formulaslug/fs-3-schematics/BMS/BMS.step

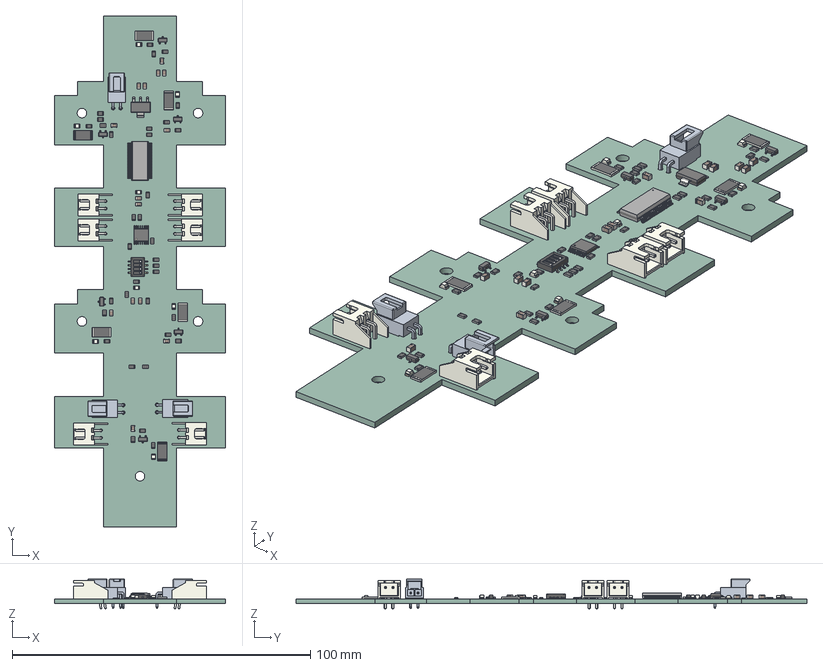
[picture p1: CAD file, 2025-05-03]
BMS/BMS.step
57.4 x 171.2 x 10.0 mm
C_0805_2012Metric x 14
R_0805_2012Metric x 35
SOT_23 x 6
JST_S2B_XH_A x 6
R_2512_6332Metric x 6
LED_0805_2012Metric x 8
A6H_4101
TSSOP_16_44x5mm_P065mm
SOT_223
BMS_PCB
