formulaslug/fs-3-schematics/Telemetry peripheral boards/FS3 Peripheral V4 ATTINY/F3 peripheral boards.step

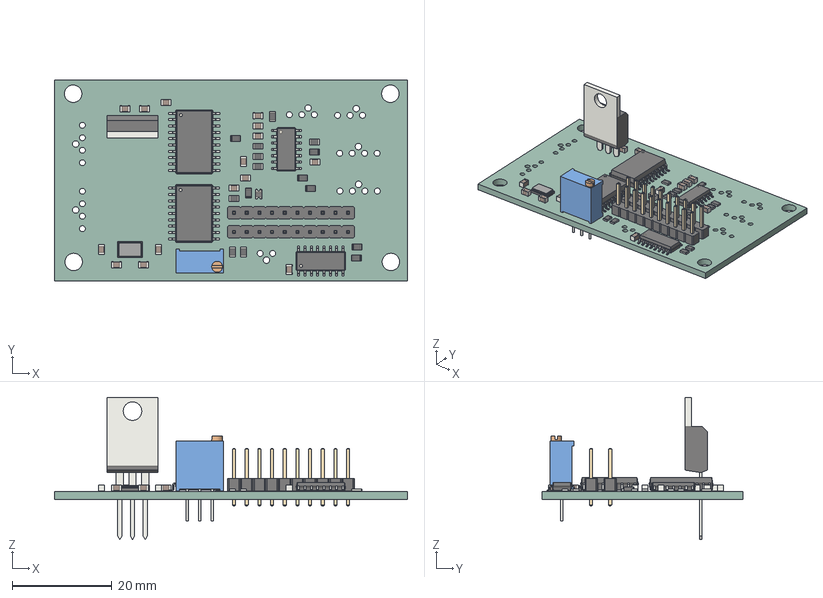
[picture p2: CAD file, 2025-06-03]
Telemetry peripheral boards/FS3 Peripheral V4 ATTINY/F3 peripheral boards.step
70.7 x 40.3 x 28.5 mm
C_0805_2012Metric x 15
SOIC_18W_75x116mm_P127mm
D_0805
R_0805_2012Metric x 15
SOIC_20W_75x128mm_P127mm
Crystal_SMD_5032-2Pin_5.0x3.2mm
SOIC_14_39x87mm_P127mm
PinHeader_1x10_P254mm_Vertical x 2
TO-220-3_Vertical
SOIC_16_39x99mm_P127mm
Potentiometer_Bourns_3296W_Vertical
F3 peripheral boards_PCB
