formulaslug/fs-3-schematics/BSPD/BSPD.pdf

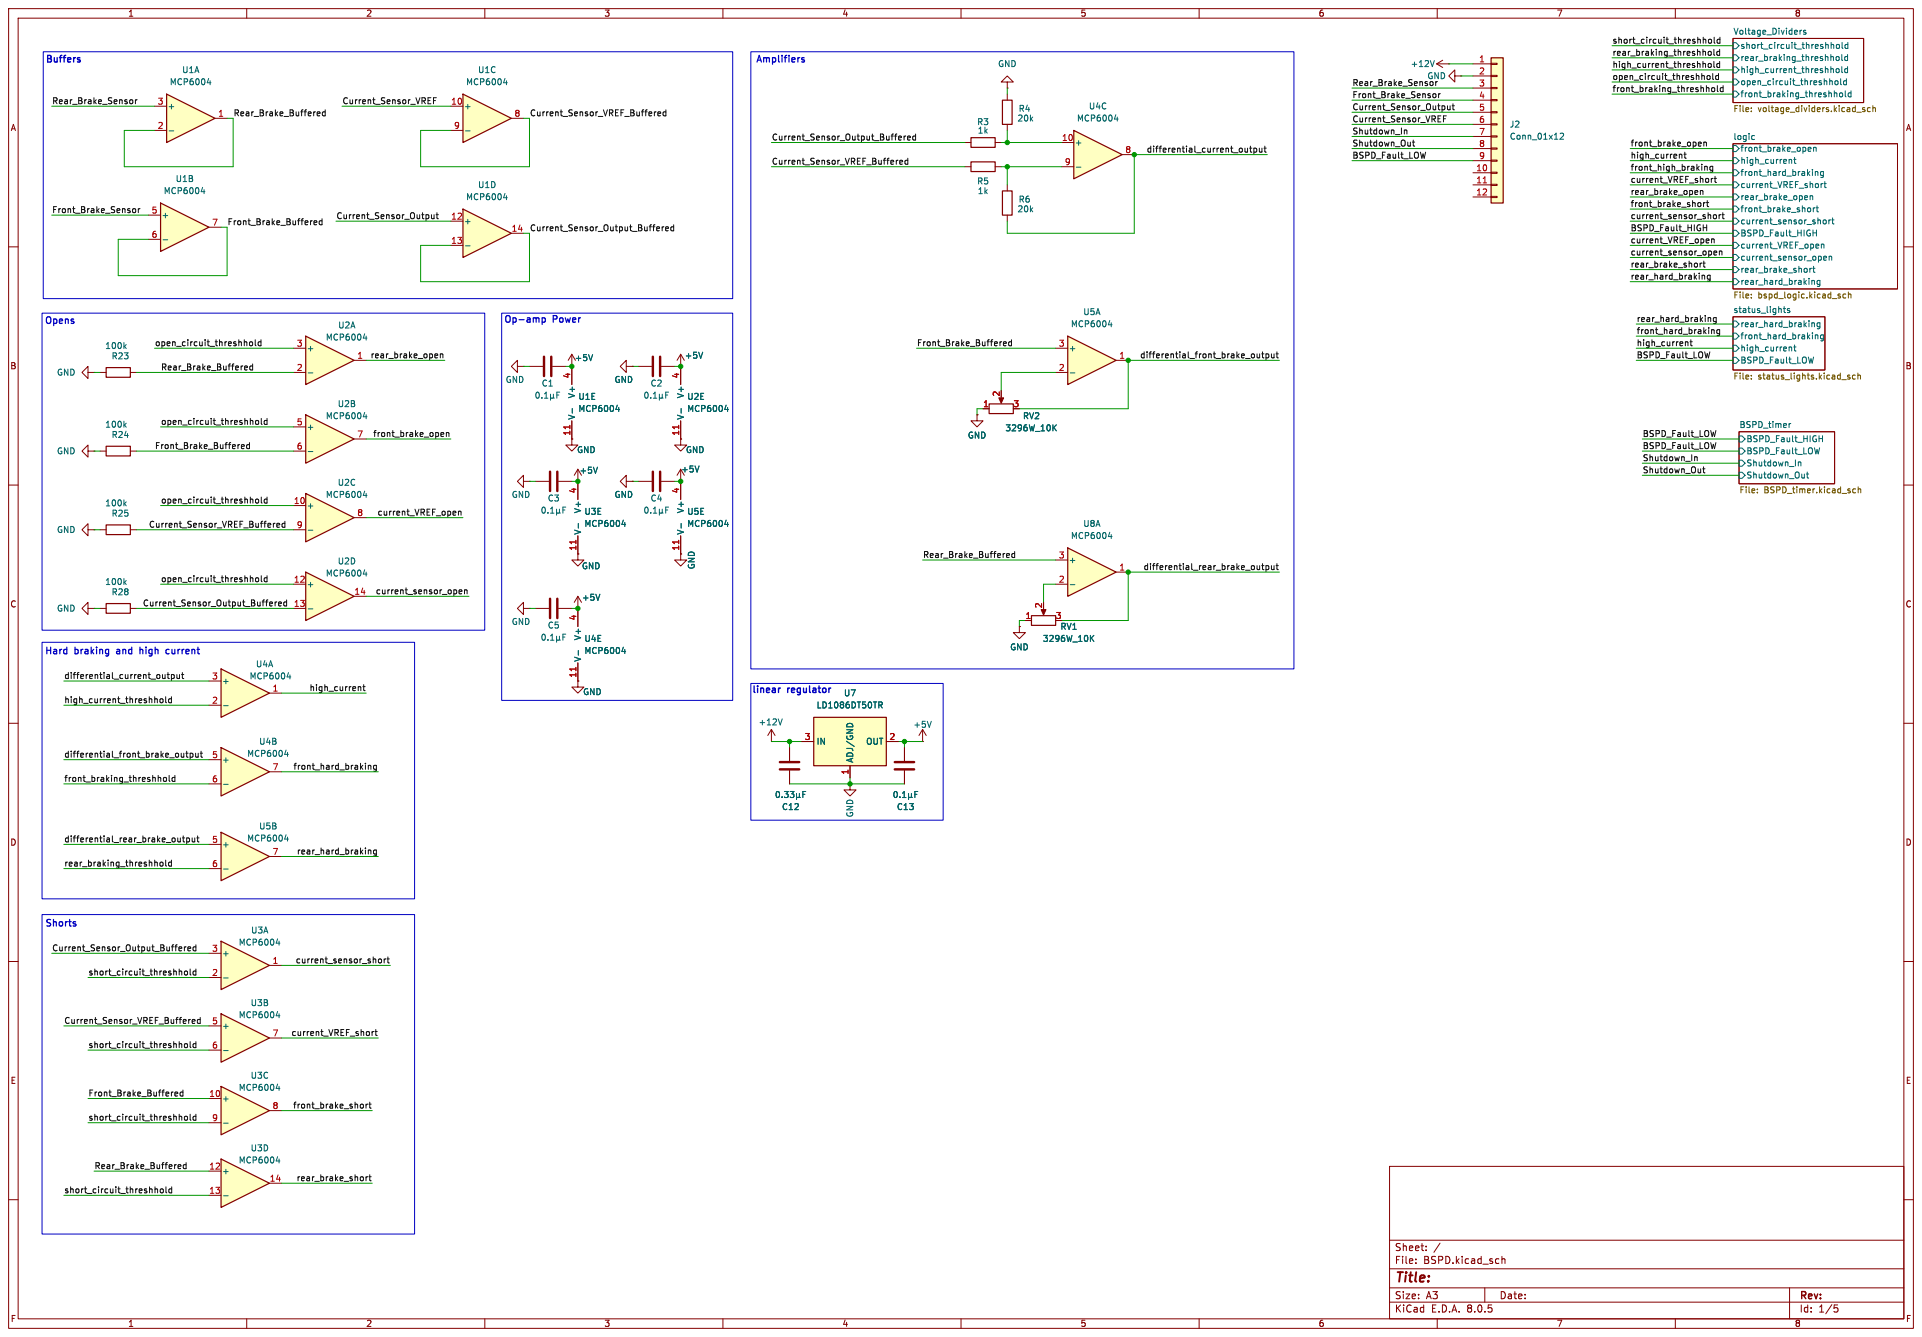
[picture p4: page 1]

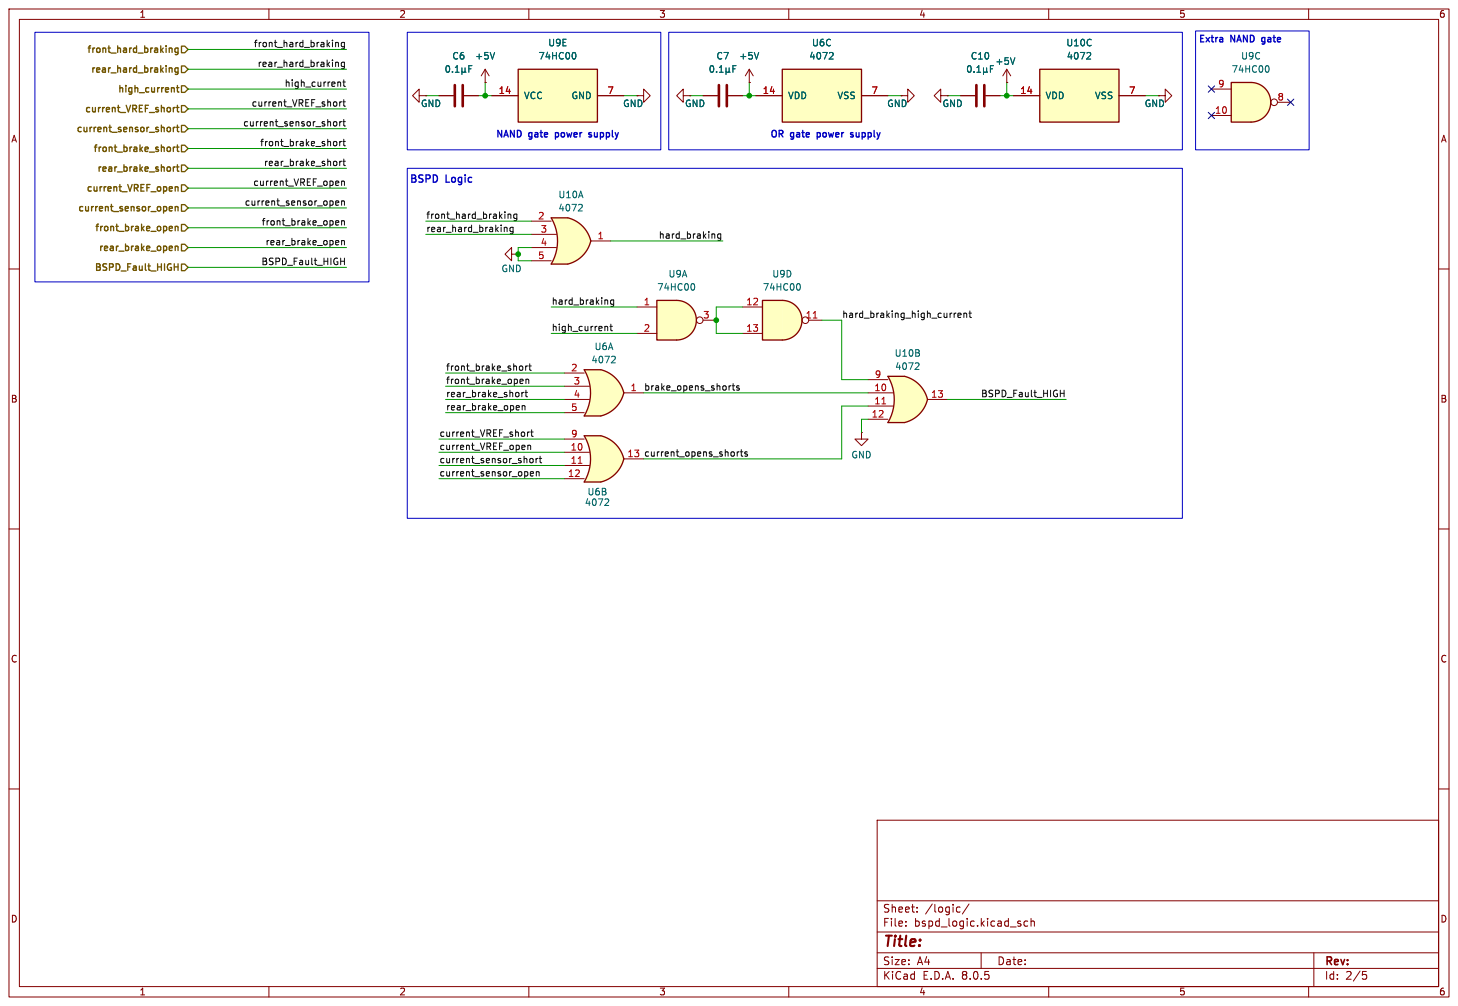
[picture p5: page 2]

Id: 2/5 Title: File: bspd_logic.kicad_sch Sheet: /logic/

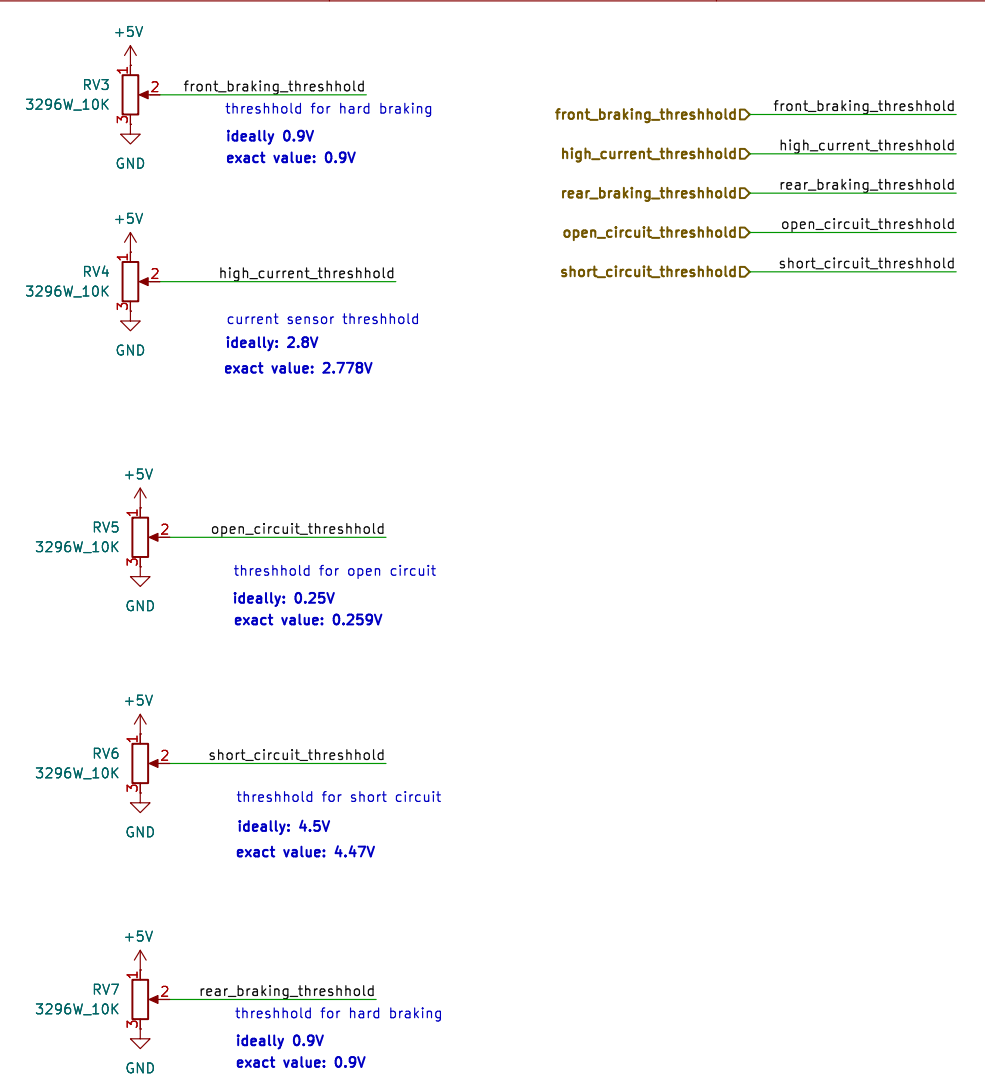
[picture p6: page 3]

Id: 3/5 Title: File: voltage_dividers.kicad_sch Sheet: /Voltage_Dividers/

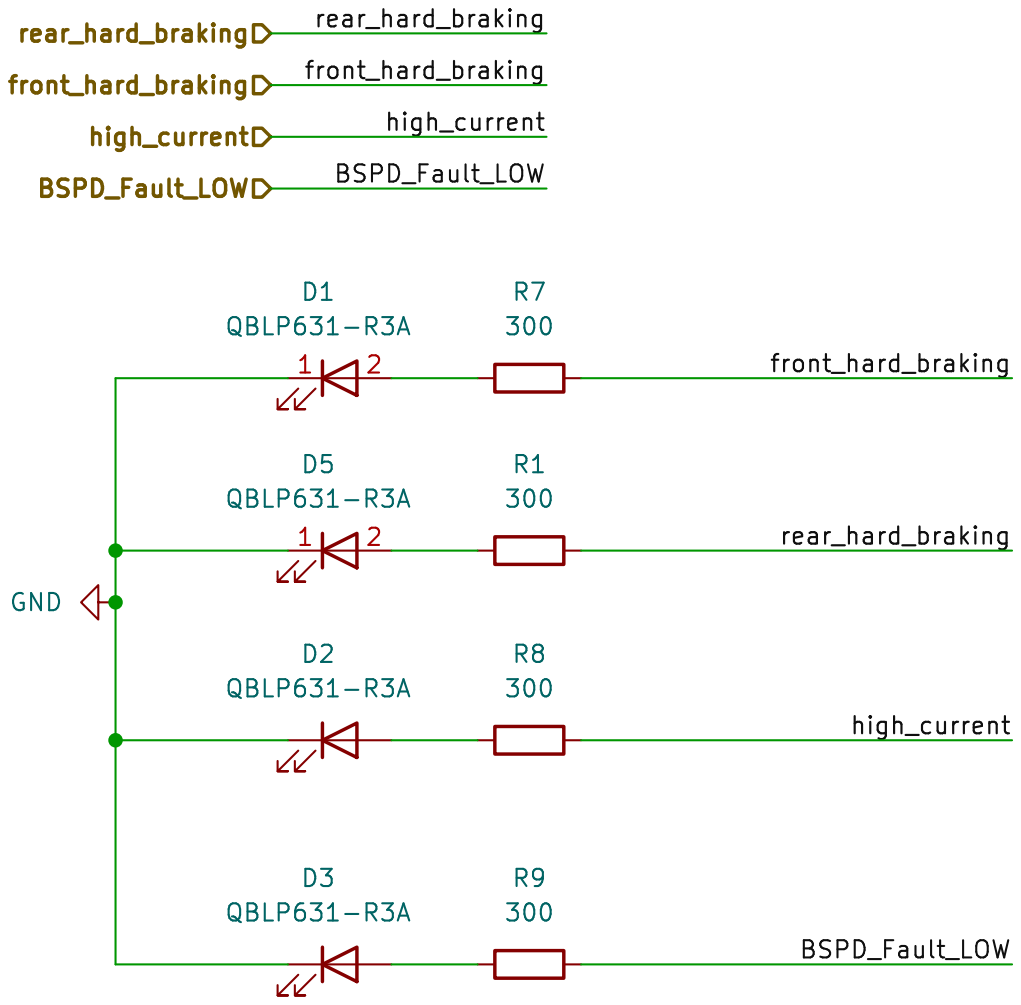
[picture p7: page 4]

Id: 4/5 Title: File: status_lights.kicad_sch Sheet: /status_lights/

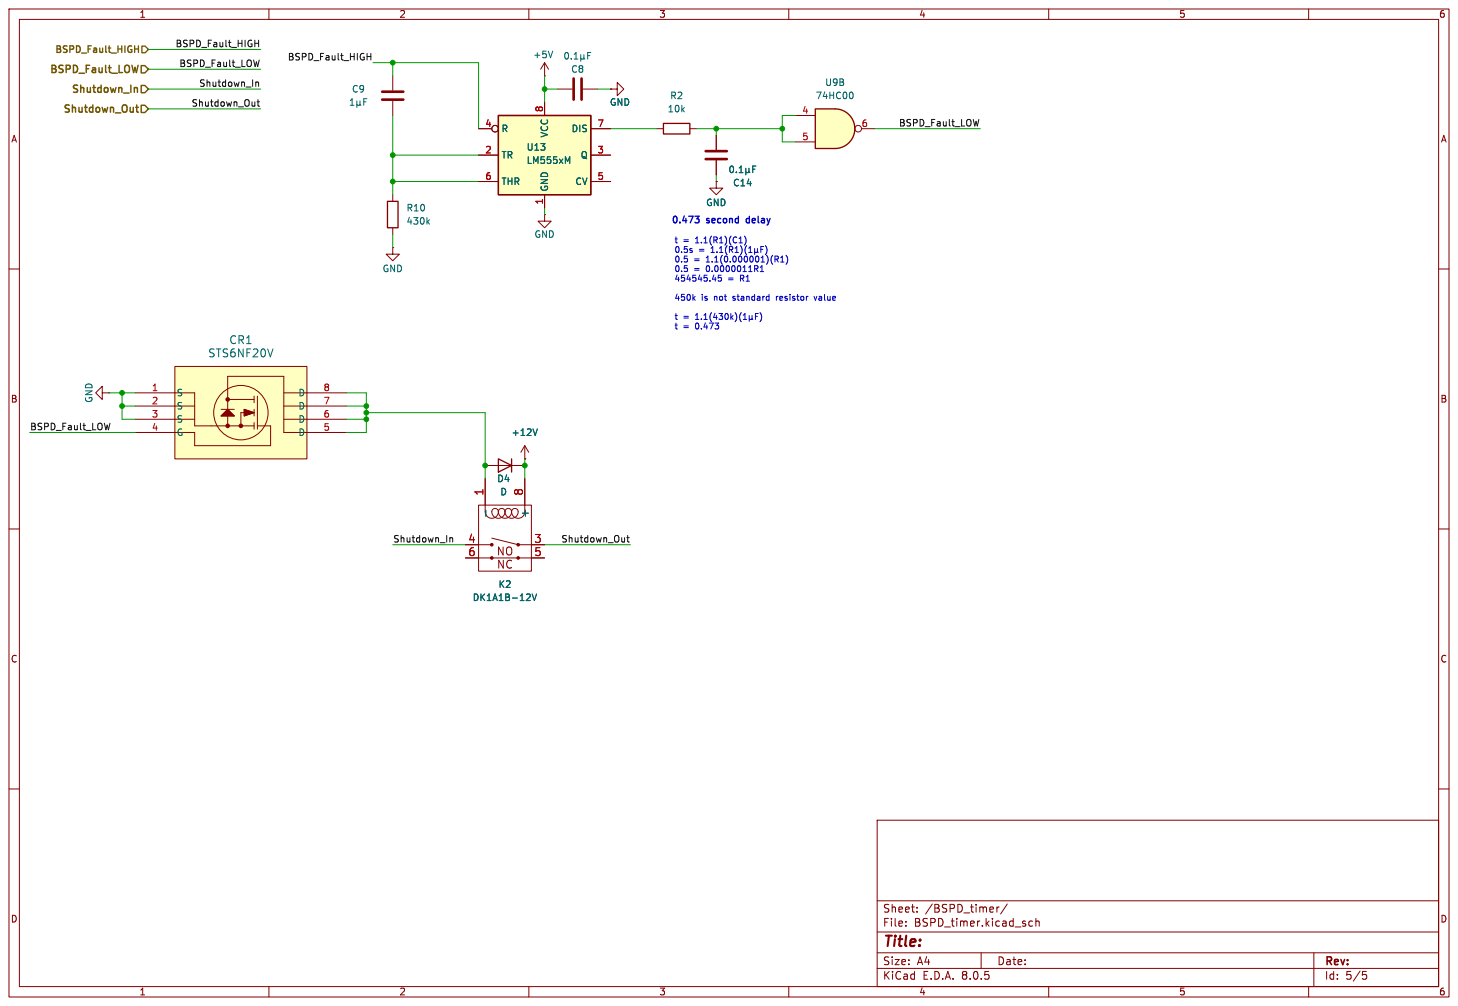
[picture p8: page 5]

Id: 5/5 Title: File: BSPD_timer.kicad_sch Sheet: /BSPD_timer/ D4D
