formulaslug/fs-3-schematics/TelemetryMainRev3/TelemMainV3/Telemetry Board Drawings/Print Preview Black and White.pdf

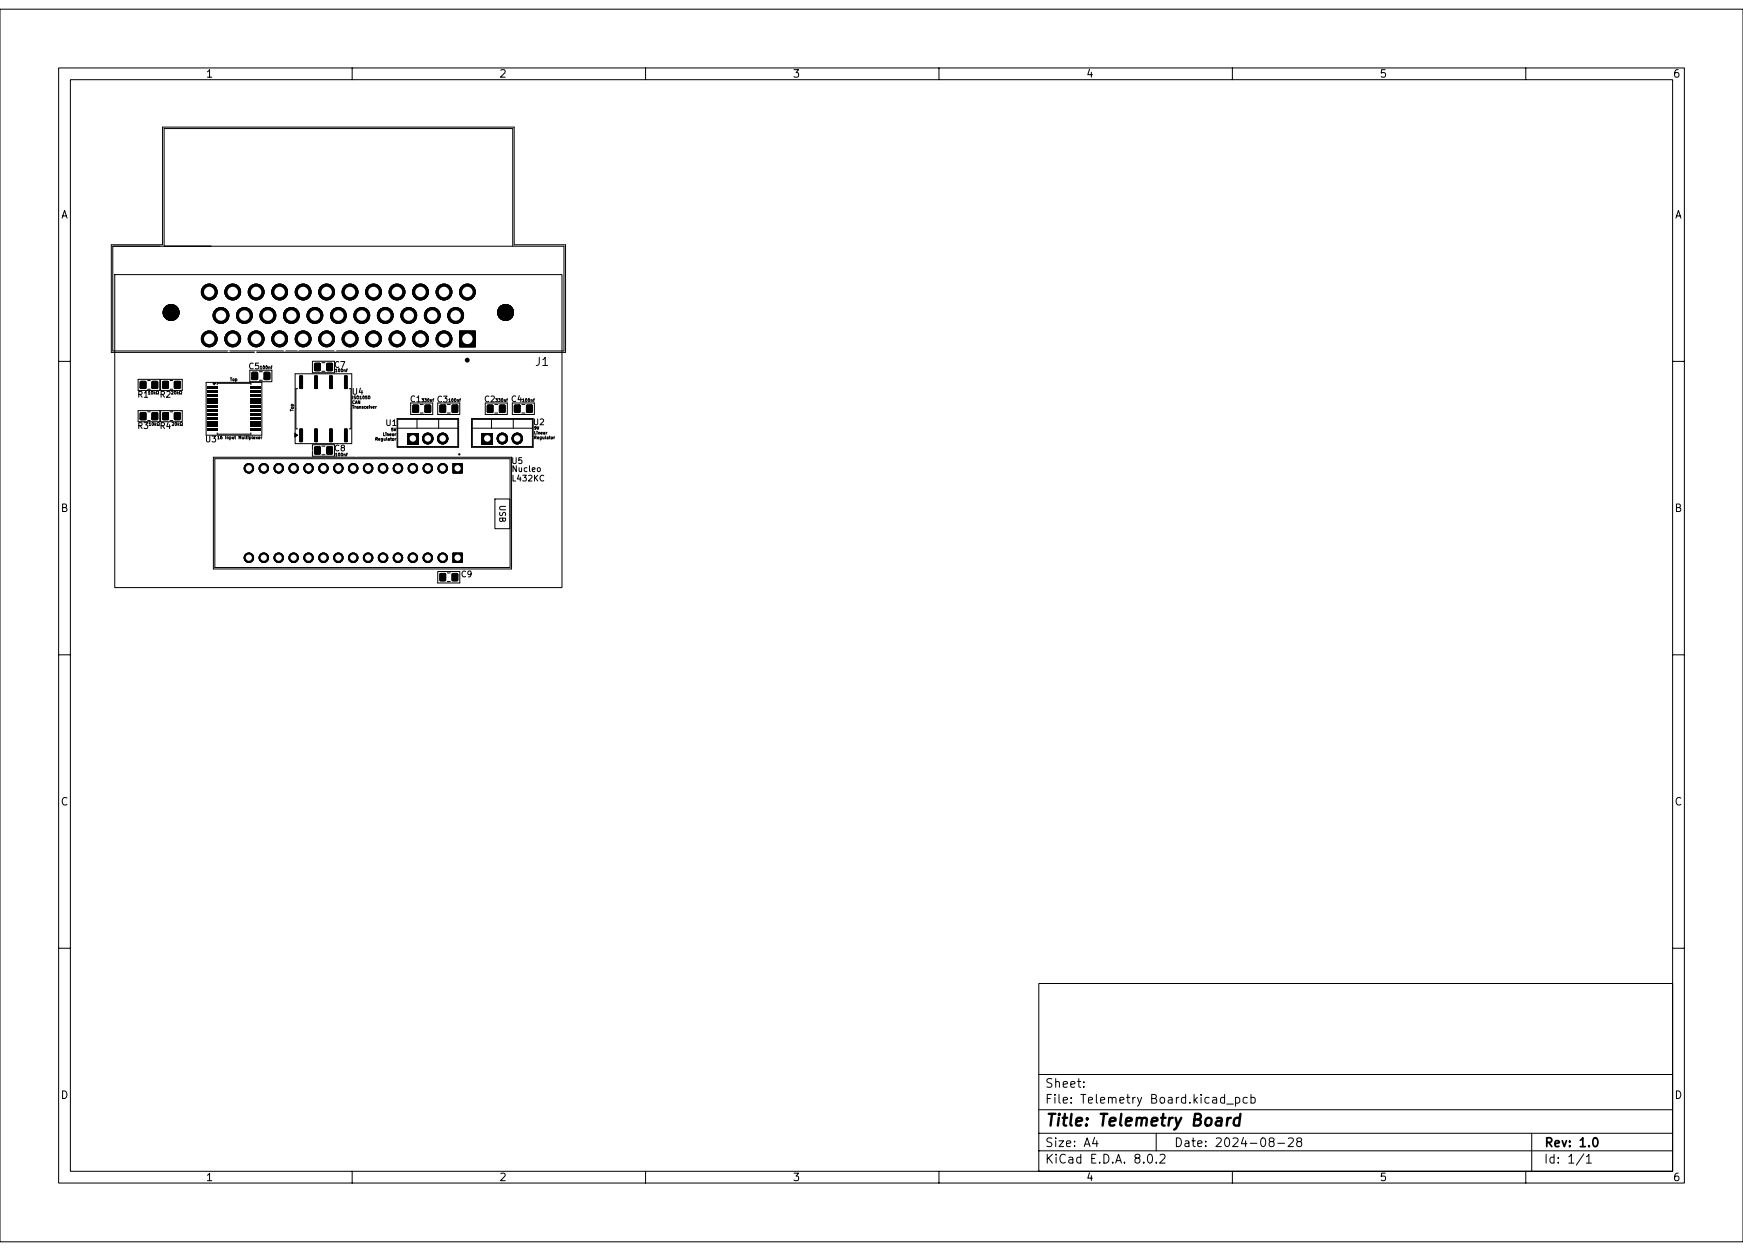
[picture p9: page 1]
