formulaslug/fs-3-schematics/TelemetryMainRev3/TelemMainV3/Telemetry Board Drawings/Print Preview Dark Background.pdf

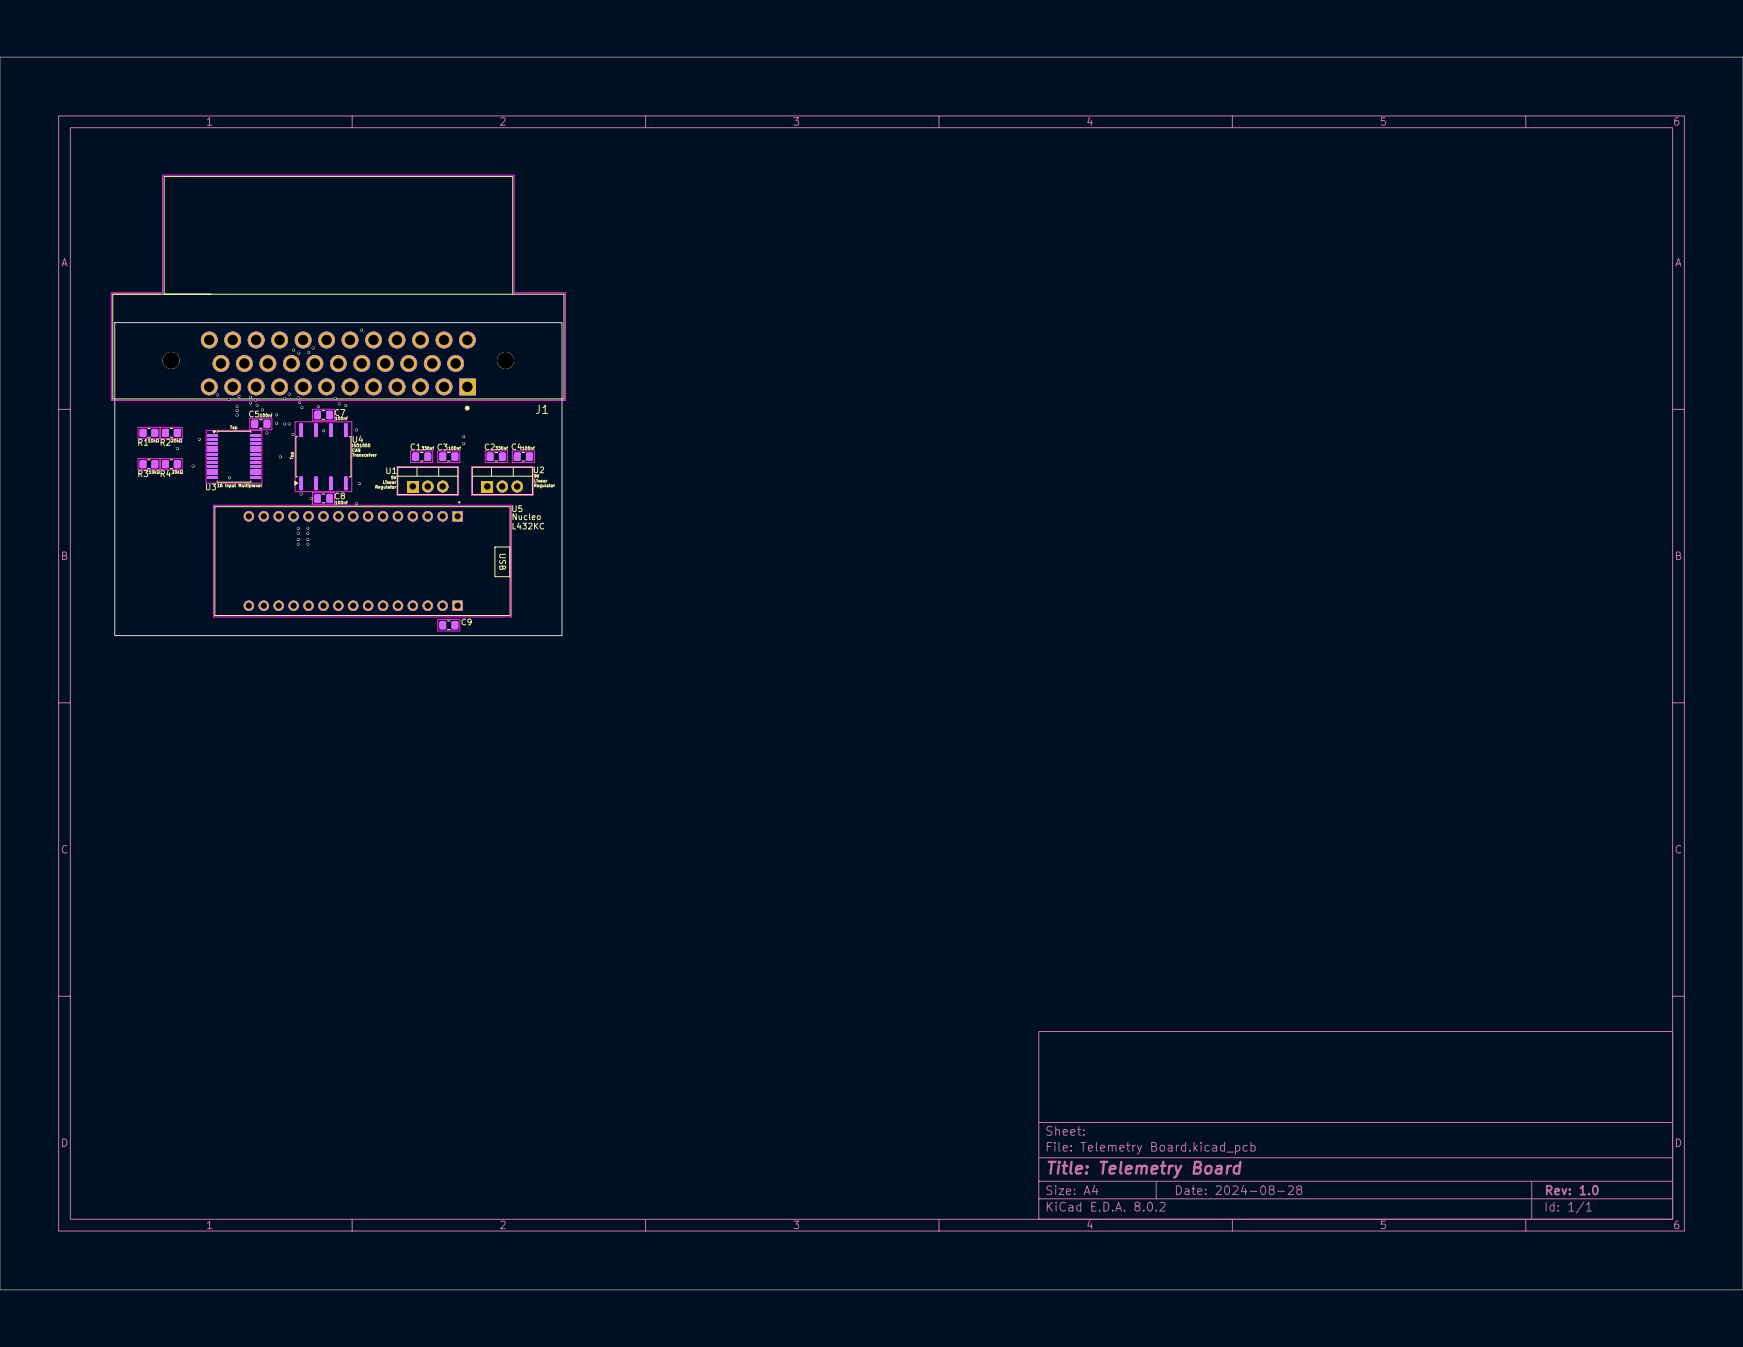
[picture p10: page 1]
