formulaslug/fs-3-schematics/TelemetryMainRev3/TelemMainV3/Telemetry Board Drawings/Print Preview.pdf

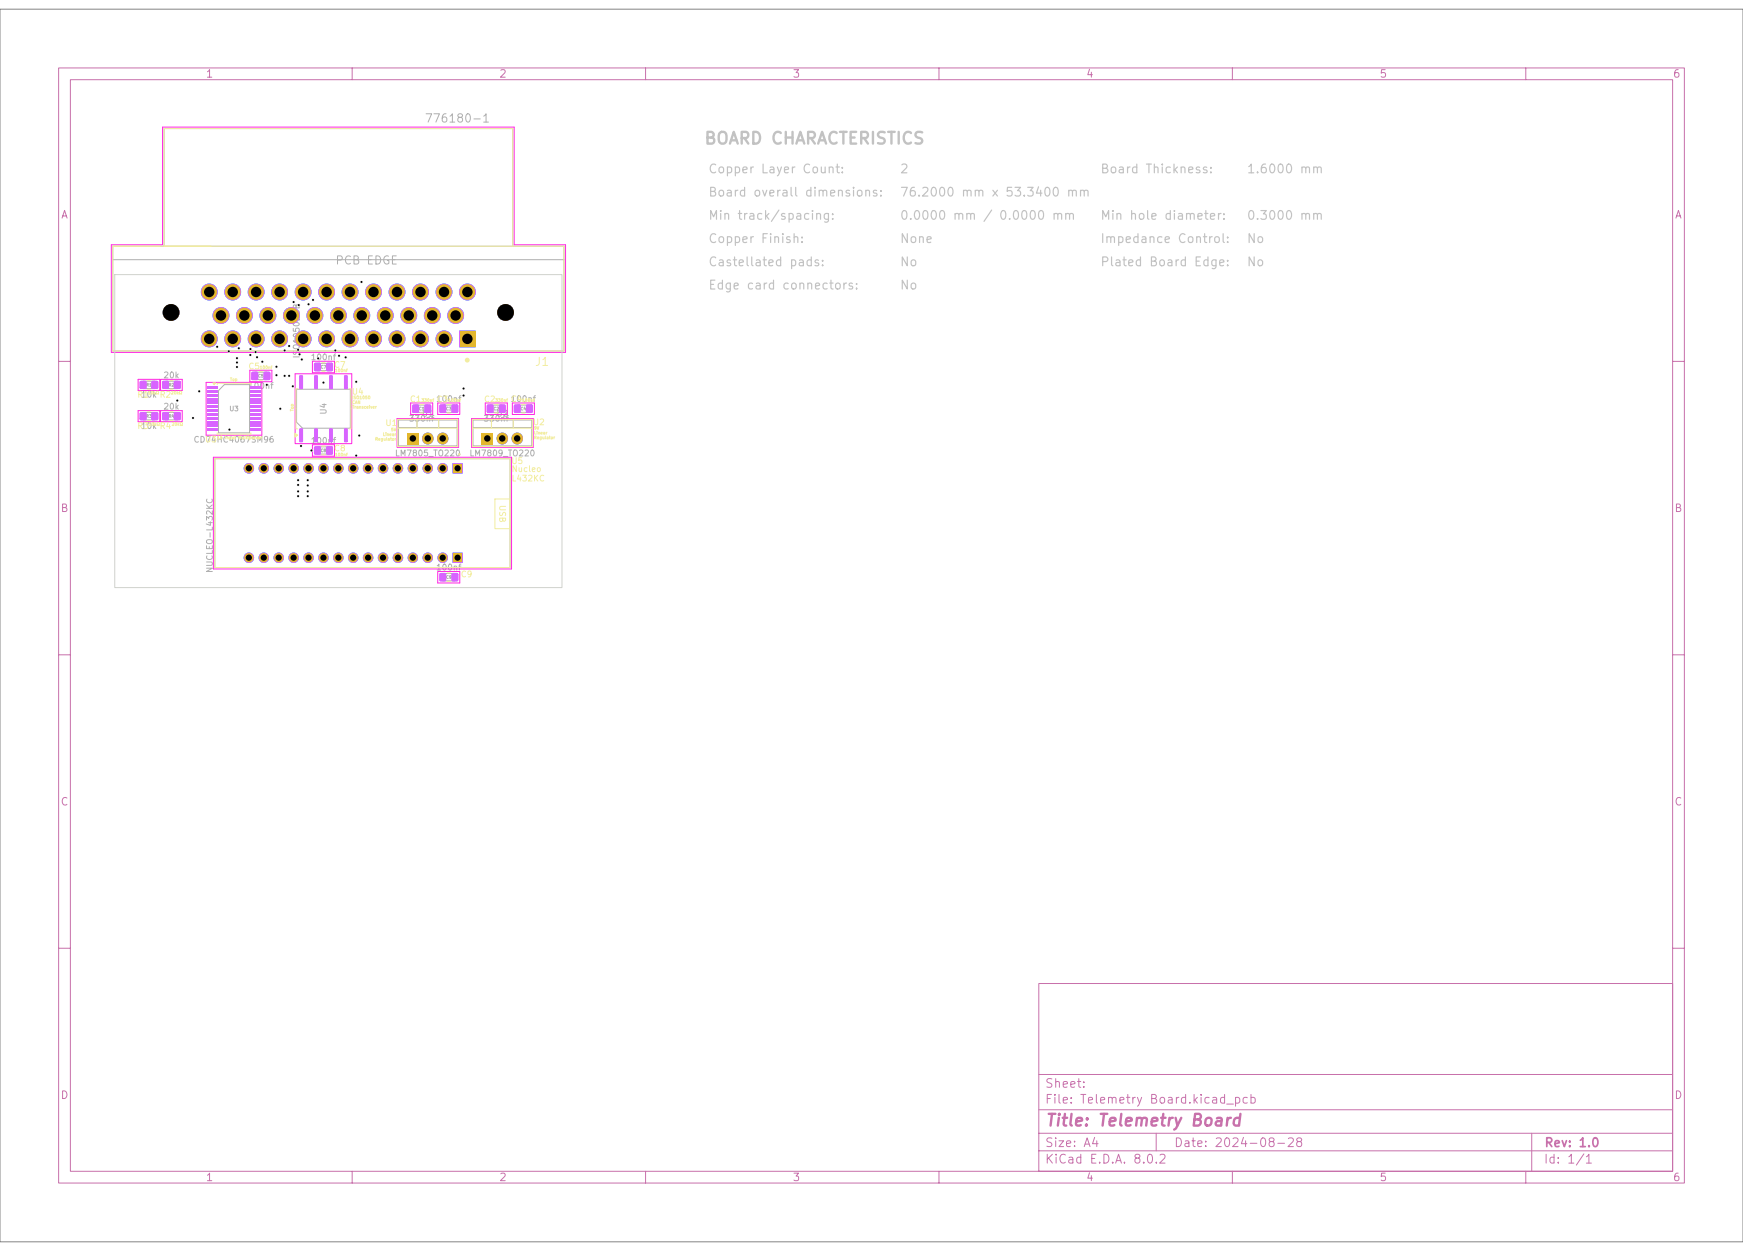
[picture p11: page 1]
