formulaslug/fs-3-schematics/Discharge/Discharge PCB.pdf

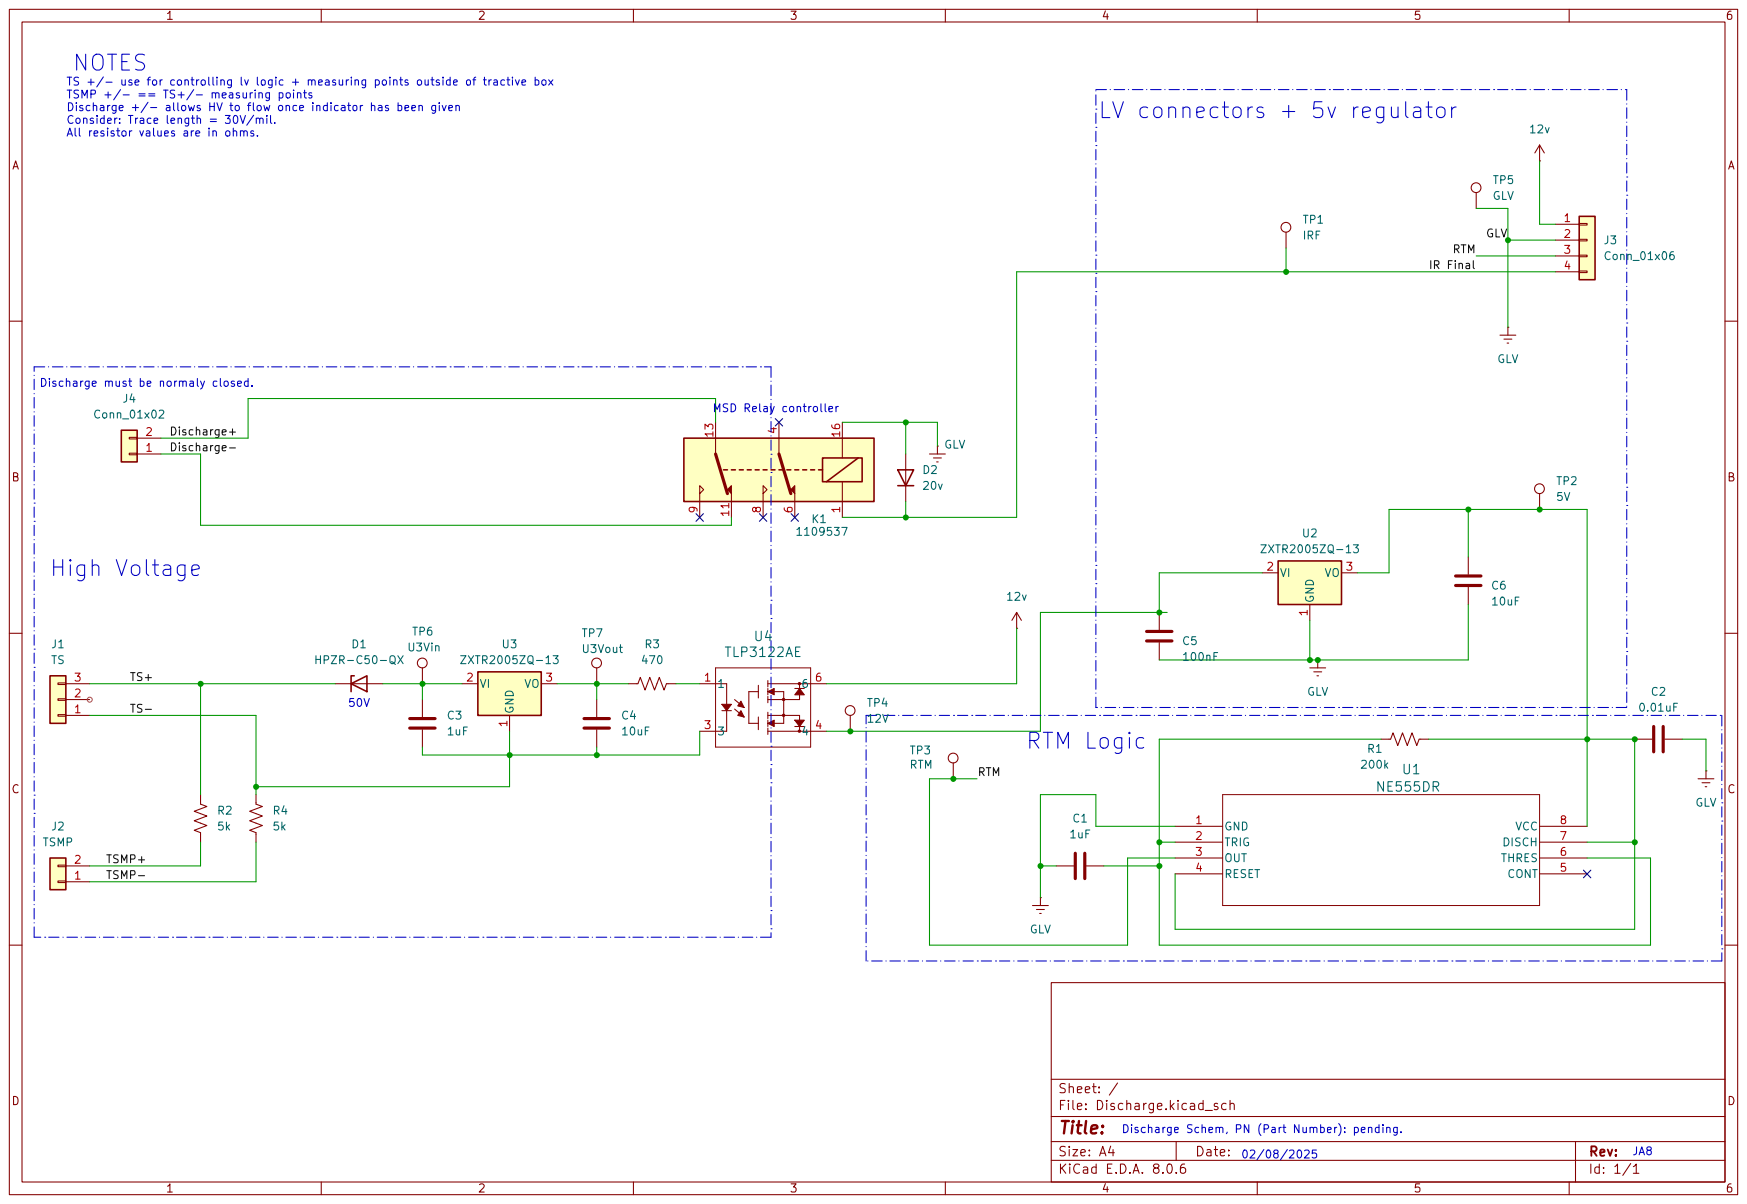
[picture p12: page 1]
