formulaslug/fs-3-schematics/Discharge/Discharge Rev_5.pdf

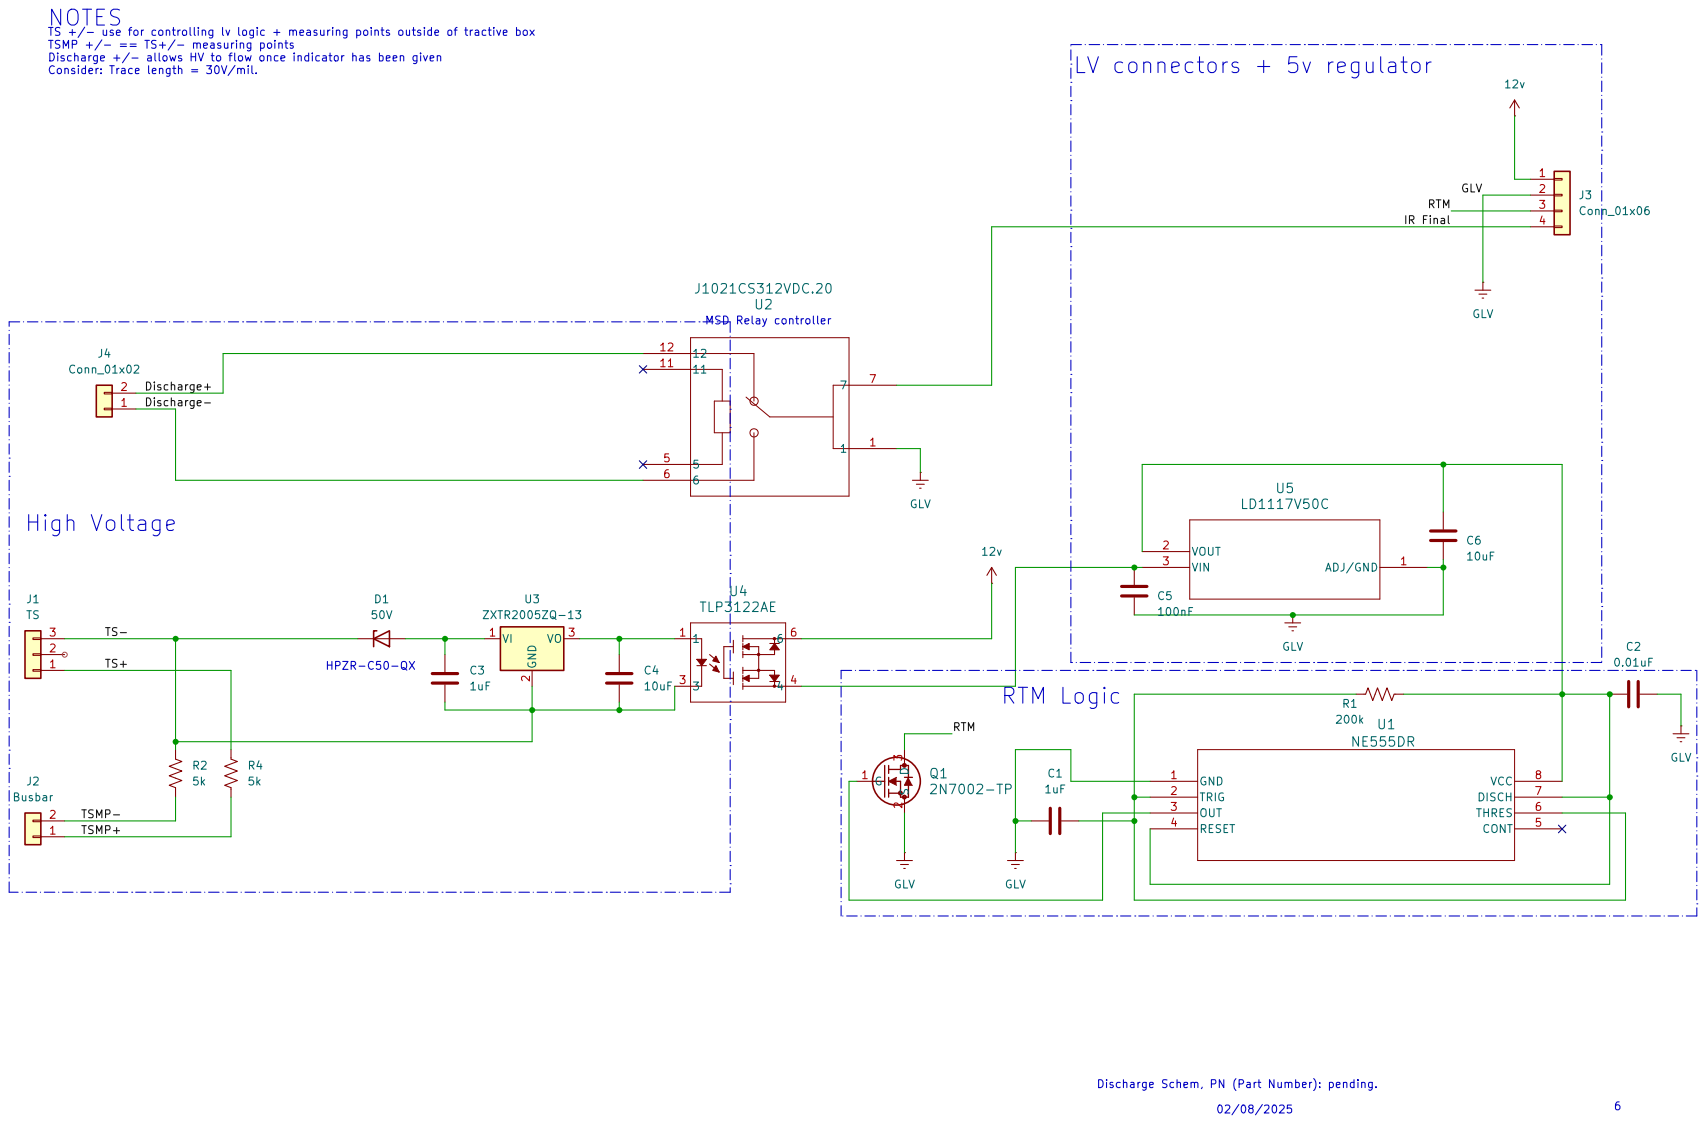
[picture p13: page 1]
