formulaslug/fs-3-schematics/TelemetryMainRev3/TelemMainV3/Telemetry Board Drawings/Full Board V1.pdf

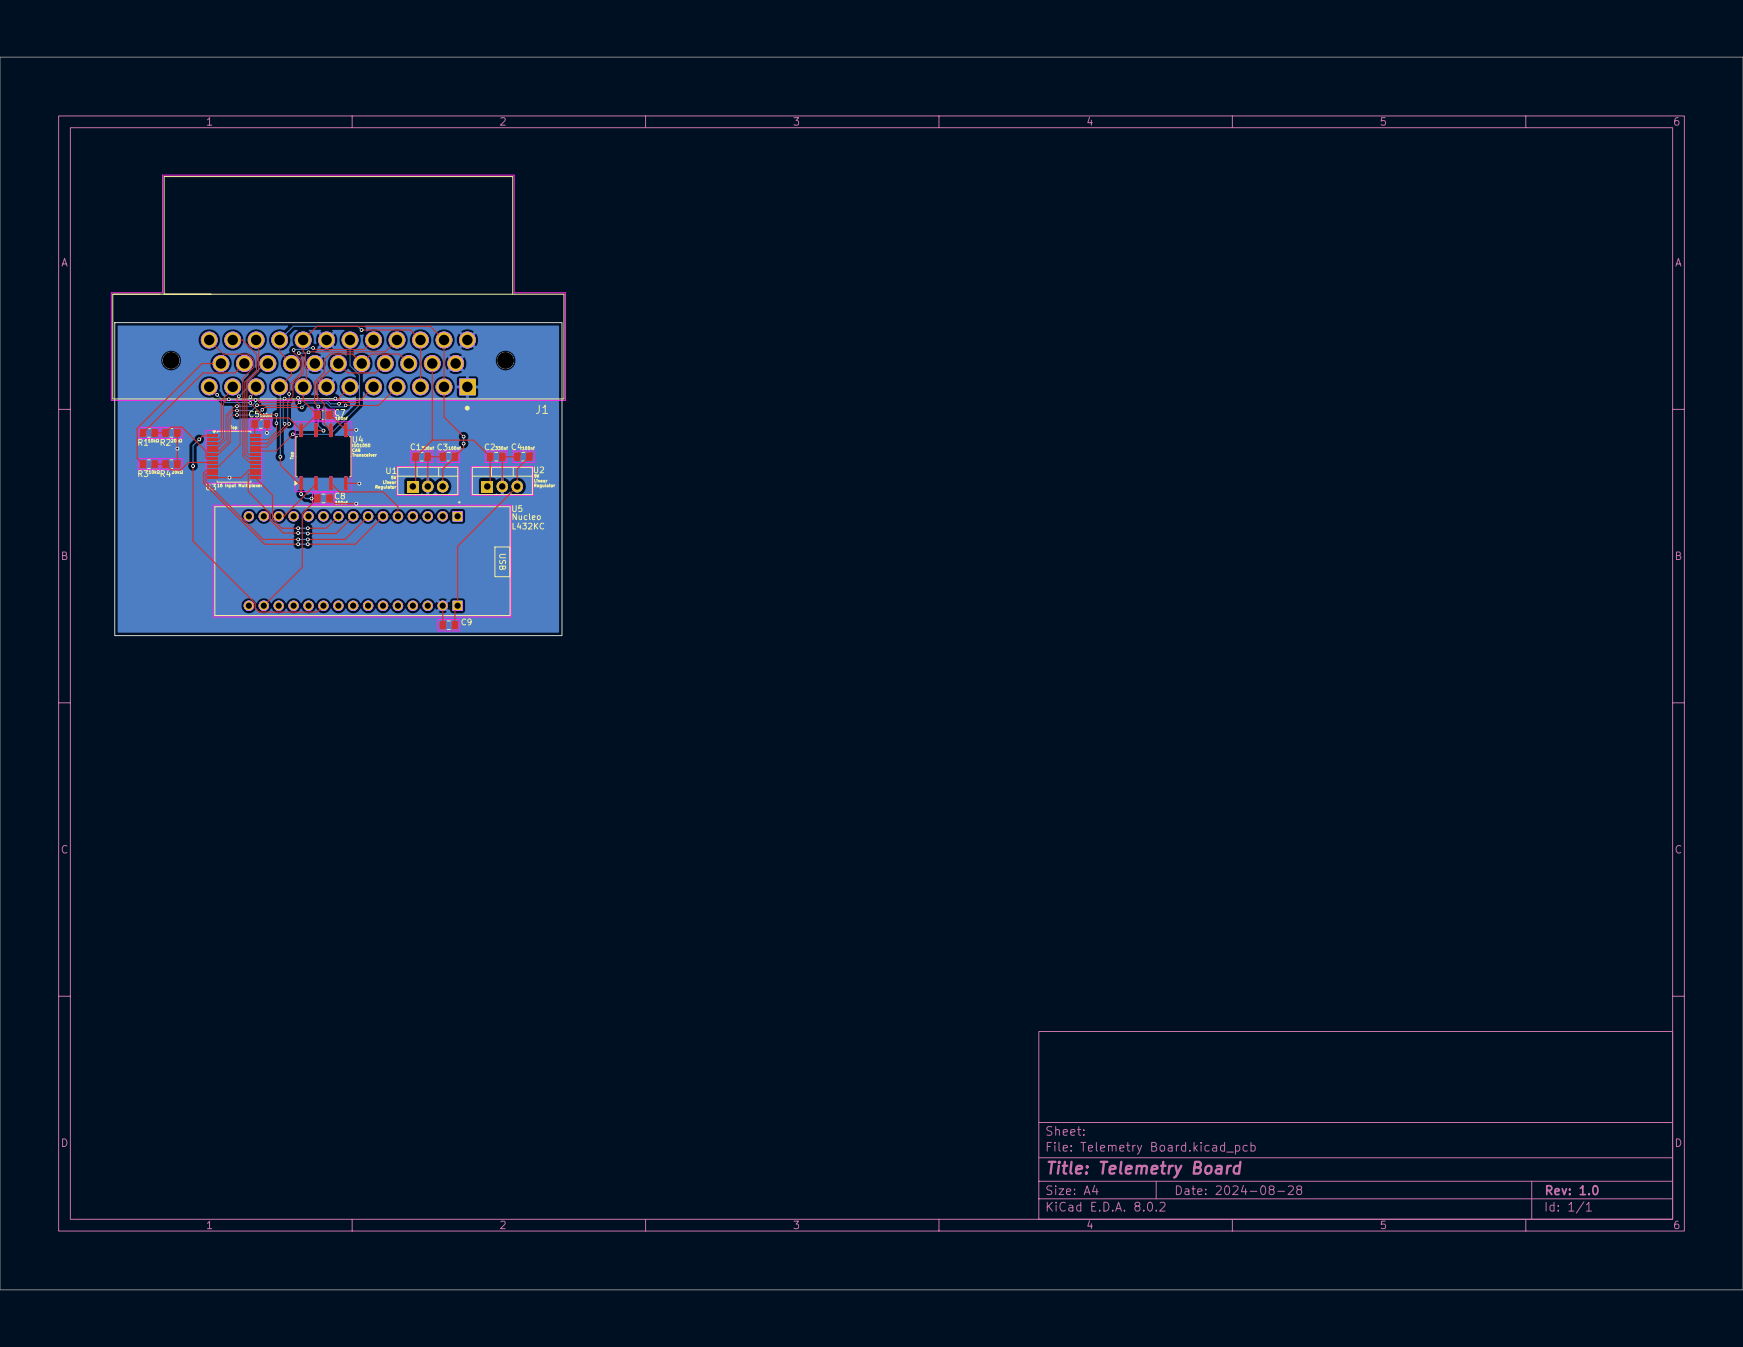
[picture p14: page 1]
