formulaslug/fs-3-schematics/Discharge/Discharge Rev_4.pdf

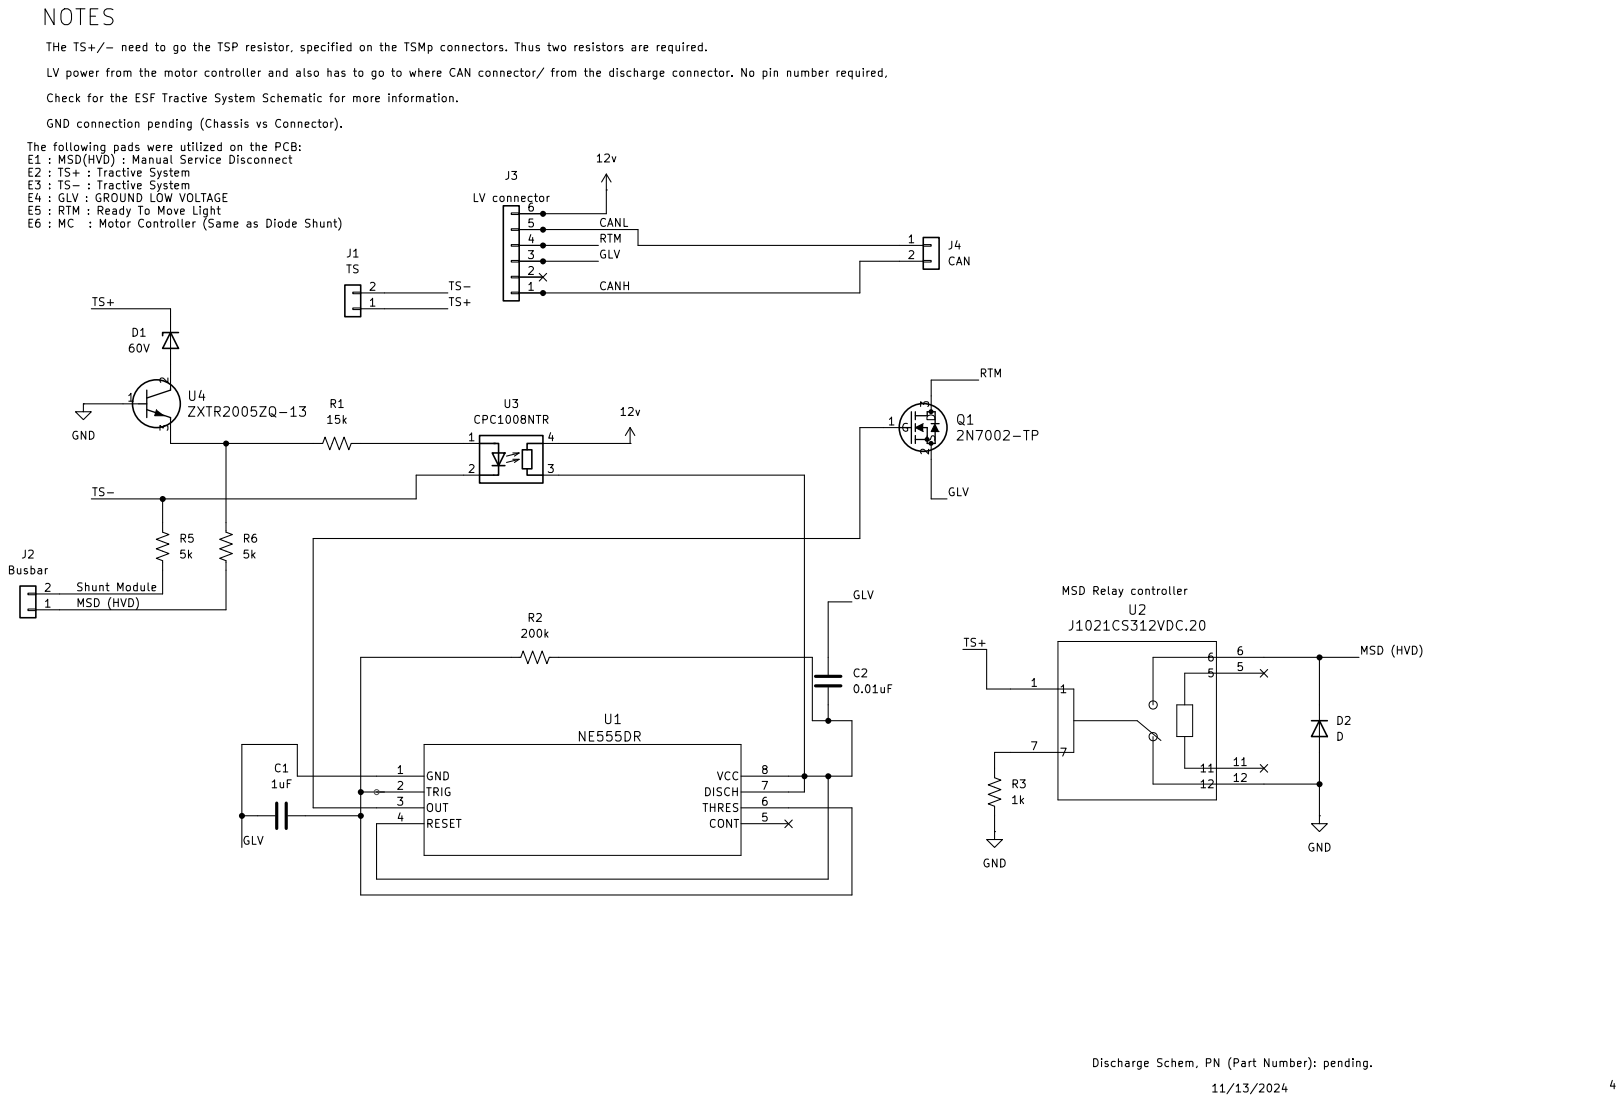
[picture p15: page 1]
