formulaslug/fs-3-schematics/Discharge/Discharge.kicad_pcb

## KiCad design Discharge/Discharge.kicad_pcb (2025-06-14)

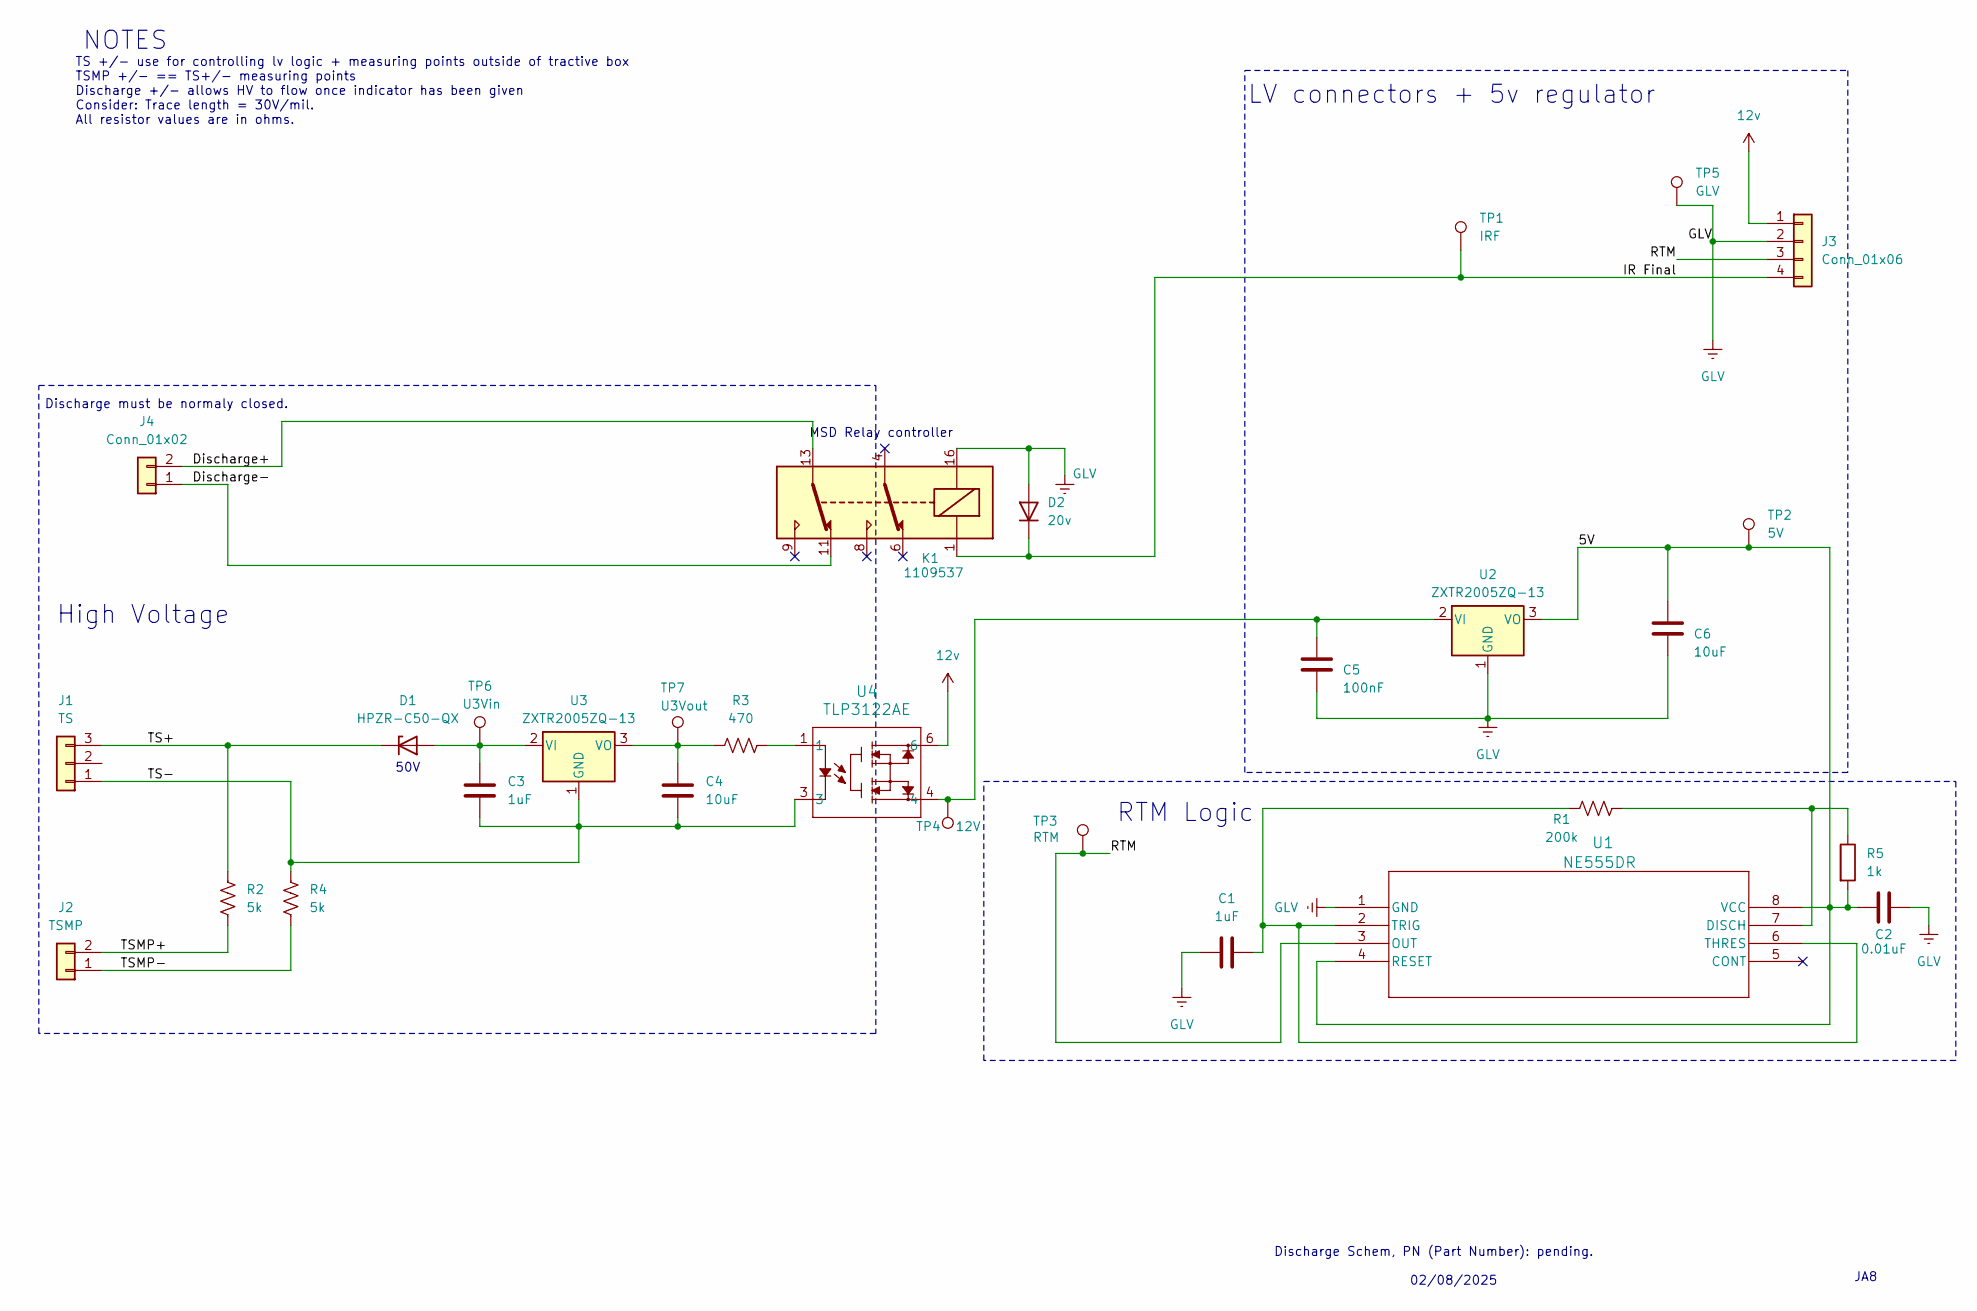
[picture p16: schematic Discharge.kicad_sch]

Parts:
C1, C3: 1uF; C_0805_2012Metric_Pad1.18x1.45mm_HandSolder
C2: 0.01uF; C_0805_2012Metric_Pad1.18x1.45mm_HandSolder
C4, C6: 10uF; C_0805_2012Metric_Pad1.18x1.45mm_HandSolder
C5: 100nF; C_0805_2012Metric_Pad1.18x1.45mm_HandSolder
D1: HPZR-C50-QX; Nexperia_CFP3_SOD-123W
D2: 20v; D_2010_5025Metric
J1: TS; Molex_Nano-Fit_105309-xx03_1x03_P2.50mm_Vertical
J2: TSMP; Molex_Nano-Fit_105309-xx02_1x02_P2.50mm_Vertical
J3: Conn_01x06; Molex_Nano-Fit_105309-xx04_1x04_P2.50mm_Vertical
J4: Conn_01x02; Molex_Nano-Fit_105309-xx02_1x02_P2.50mm_Vertical
K1: 1109537; Relay_DPDT_Omron_G5V-2
R1: 200k; R_0805_2012Metric_Pad1.20x1.40mm_HandSolder
R2, R4: 5k; R_Axial_Power_L20.0mm_W6.4mm_P22.40mm
R3: 470; R_0603_1608Metric_Pad0.98x0.95mm_HandSolder
R5: 1k; R_0805_2012Metric
TP1: IRF; TestPoint_Loop_D2.50mm_Drill1.0mm
TP2: 5V; TestPoint_Loop_D2.50mm_Drill1.0mm
TP3: RTM; TestPoint_Loop_D2.50mm_Drill1.0mm
TP4: 12V; TestPoint_Loop_D2.50mm_Drill1.0mm
TP5: GLV; TestPoint_Loop_D2.50mm_Drill1.0mm
TP6: U3Vin; TestPoint_Loop_D2.50mm_Drill1.0mm
TP7: U3Vout; TestPoint_Loop_D2.50mm_Drill1.0mm
U1: NE555DR; D8
U2, U3: ZXTR2005ZQ-13; SOT-89-3_Handsoldering
U4: TLP3122AE; SO-5-6_4.55x3.7mm_P1.27mm

Connections:
12v: J3.1, U4.6
/5V: C2.1, C6.1, R5.2, TP2.1, U1.4 (RESET), U1.8 (VCC), U2.3 (VO)
/Discharge+: J4.2, K1.13
/Discharge-: J4.1, K1.11
/IR Final: D2.1 (K), J3.4, K1.1, TP1.1
/RTM: J3.3, TP3.1, U1.3 (OUT)
/TS+: D1.1 (K), J1.3, R2.2
/TS-: C3.2, C4.2, J1.1, R4.1, U3.1 (GND), U4.3
/TSMP+: J2.2, R2.1
/TSMP-: J2.1, R4.2
GLV: C1.1, C2.2, C5.2, C6.2, D2.2 (A), J3.2, K1.16, TP5.1, U1.1 (GND), U2.1 (GND)
unnamed: C3.1, D1.2 (A), TP6.1, U3.2 (VI)
unnamed: R3.2, U4.1
unnamed: R1.2, R5.1, U1.7 (DISCH)
unnamed: C1.2, R1.1, U1.2 (TRIG), U1.6 (THRES)
unnamed: C5.1, TP4.1, U2.2 (VI), U4.4
unnamed: C4.1, R3.1, TP7.1, U3.3 (VO)

Notes on the sheet:
JA8
NOTES
MSD Relay controller
High Voltage
LV connectors + 5v regulator
TS +/- use for controlling lv logic + measuring points outside of tractive box TSMP +/- == TS+/- measuring points Discharge +/- allows HV to flow once indicator has been given Consider: Trace length = 30V/mil. All resistor values are in ohms.
50V
02/08/2025
RTM Logic
Discharge must be normaly closed.
Discharge Schem, PN (Part Number): pending.

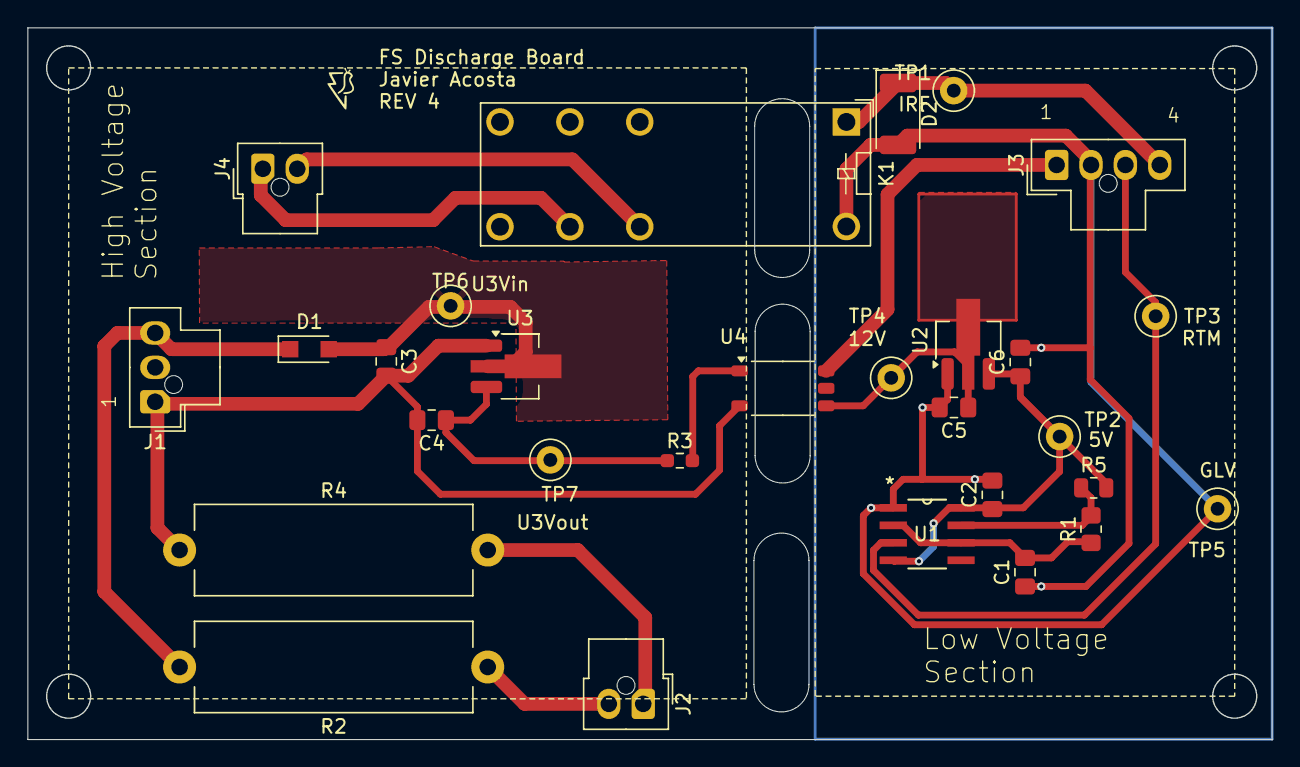
[picture p17: board Discharge.kicad_pcb from above]

Board: 2 copper layers, 90.4 x 51.7 mm, 29 parts (0 on the bottom side), 17 nets.
