formulaslug/fs-3-schematics/TelemetryMainRev3/TelemMainV3/TelemMainV3.kicad_pcb

## KiCad design TelemetryMainRev3/TelemMainV3/TelemMainV3.kicad_pcb (2025-06-03)

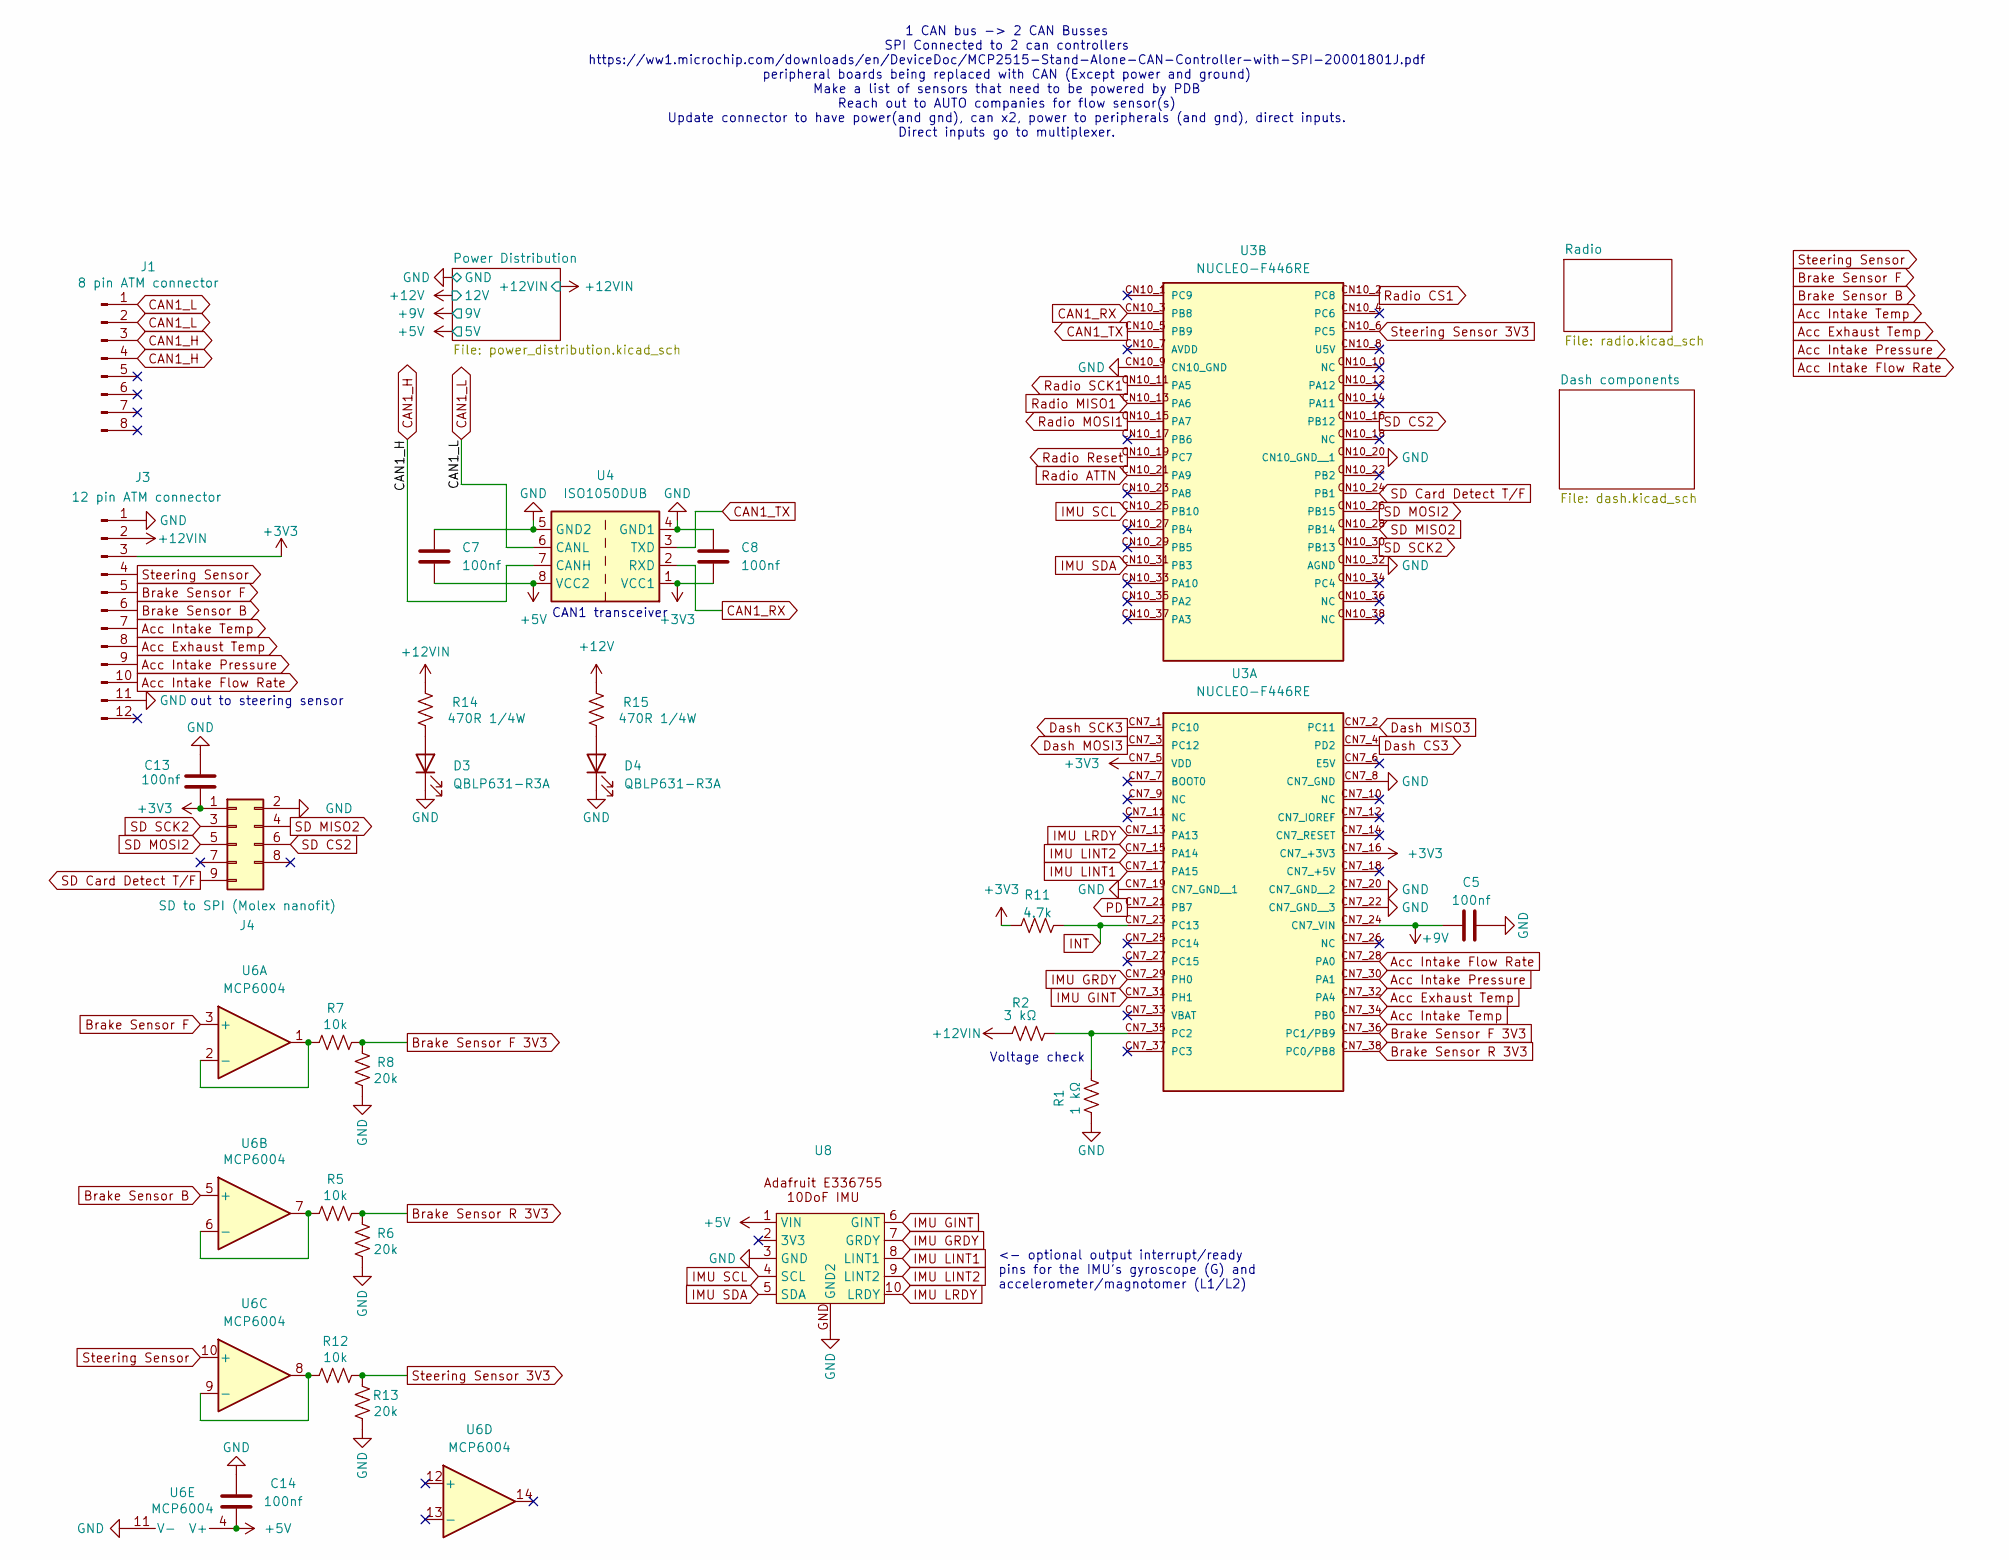
[picture p18: schematic TelemMainV3.kicad_sch, Telemetry Board]

Parts:
C5, C7, C8, C13, C14: 100nf; C_0805_2012Metric_Pad1.18x1.45mm_HandSolder
D3, D4: QBLP631-R3A; LED_0805_2012Metric_Pad1.15x1.40mm_HandSolder
J1: 8 pin ATM connector; ATM13-8PA-BM03
J3: 12 pin ATM connector; ATM13-12PA-BM03
J4: SD to SPI (Molex nanofit); Molex_Nano-Fit_105310-xx10_2x05_P2.50mm_Vertical
R1: 1 kΩ; R_0805_2012Metric_Pad1.20x1.40mm_HandSolder
R2: 3 kΩ; R_0805_2012Metric_Pad1.20x1.40mm_HandSolder
R5, R7, R12: 10k; R_0805_2012Metric_Pad1.20x1.40mm_HandSolder
R6, R8, R13: 20k; R_0805_2012Metric_Pad1.20x1.40mm_HandSolder
R11: 4.7k; R_0805_2012Metric
R14, R15: 470R 1/4W; R_0805_2012Metric_Pad1.20x1.40mm_HandSolder
U3: NUCLEO-F446RE; PARTREV 13
U4: ISO1050DUB; SOP-8_6.62x9.15mm_P2.54mm
U6: MCP6004; SOIC-14_3.9x8.7mm_P1.27mm
U8: Adafruit_E336755_10DoF_IMU

Connections:
+3V3: C8.2, C13.1, J3.3, J4.1, R11.1, U3.CN7_5 (VDD), U3.CN7_16 (CN7_+3V3), U4.1 (VCC1); also elsewhere on the board
+5V: C7.2, C14.1, U4.8 (VCC2), U6.4 (V+), U8.1 (VIN); also elsewhere on the board
+9V: C5.1, U3.CN7_24 (CN7_VIN); also elsewhere on the board
+12V: R15.1; also elsewhere on the board
+12VIN: J3.2, R2.2, R14.1; also elsewhere on the board
Acc Exhaust Temp: J3.8, U3.CN7_32 (PA4)
Acc Intake Flow Rate: J3.10, U3.CN7_28 (PA0)
Acc Intake Pressure: J3.9, U3.CN7_30 (PA1)
Acc Intake Temp: J3.7, U3.CN7_34 (PB0)
Brake Sensor B: J3.6, U6.5 (+)
Brake Sensor F: J3.5, U6.3 (+)
Brake Sensor F 3V3: R7.2, R8.2, U3.CN7_36 (PC1/PB9)
Brake Sensor R 3V3: R5.2, R6.2, U3.CN7_38 (PC0/PB8)
CAN1_H: J1.3, J1.4, U4.7 (CANH)
CAN1_L: J1.1, J1.2, U4.6 (CANL)
CAN1_RX: U3.CN10_3 (PB8), U4.2 (RXD)
CAN1_TX: U3.CN10_5 (PB9), U4.3 (TXD)
Dash CS3: U3.CN7_4 (PD2); also elsewhere on the board
Dash MISO3: U3.CN7_2 (PC11); also elsewhere on the board
Dash MOSI3: U3.CN7_3 (PC12); also elsewhere on the board
Dash SCK3: U3.CN7_1 (PC10); also elsewhere on the board
GND: C5.2, C7.1, C8.1, C13.2, C14.2, D3.1 (K), D4.1 (K), J3.1, J3.11, J4.2, R1.1, R6.1, R8.1, R13.1, U3.CN7_8 (CN7_GND), U3.CN7_19 (CN7_GND__1), U3.CN7_20 (CN7_GND__2), U3.CN7_22 (CN7_GND__3), U3.CN10_9 (CN10_GND), U3.CN10_20 (CN10_GND__1), U3.CN10_32 (AGND), U4.4 (GND1), U4.5 (GND2), U6.11 (V-), U8.3 (GND), U8.GND (GND2); also elsewhere on the board
IMU GINT: U3.CN7_31 (PH1), U8.6 (GINT)
IMU GRDY: U3.CN7_29 (PH0), U8.7 (GRDY)
IMU LINT1: U3.CN7_17 (PA15), U8.8 (LINT1)
IMU LINT2: U3.CN7_15 (PA14), U8.9 (LINT2)
IMU LRDY: U3.CN7_13 (PA13), U8.10 (LRDY)
IMU SCL: U3.CN10_25 (PB10), U8.4 (SCL)
IMU SDA: U3.CN10_31 (PB3), U8.5 (SDA)
INT: R11.2, U3.CN7_23 (PC13); also elsewhere on the board
unnamed: D3.2 (A), R14.2
unnamed: D4.2 (A), R15.2
unnamed: R1.2, R2.1, U3.CN7_35 (PC2)
unnamed: R7.1, U6.1, U6.2 (-)
unnamed: R5.1, U6.6 (-), U6.7
unnamed: R12.1, U6.8, U6.9 (-)
PD: U3.CN7_21 (PB7); also elsewhere on the board
Radio ATTN: U3.CN10_21 (PA9); also elsewhere on the board
Radio CS1: U3.CN10_2 (PC8); also elsewhere on the board
Radio MISO1: U3.CN10_13 (PA6); also elsewhere on the board
Radio MOSI1: U3.CN10_15 (PA7); also elsewhere on the board
Radio Reset: U3.CN10_19 (PC7); also elsewhere on the board
Radio SCK1: U3.CN10_11 (PA5); also elsewhere on the board
SD CS2: J4.6, U3.CN10_16 (PB12)
SD Card Detect T/F: J4.9, U3.CN10_24 (PB1)
SD MISO2: J4.4, U3.CN10_28 (PB14)
SD MOSI2: J4.5, U3.CN10_26 (PB15)
SD SCK2: J4.3, U3.CN10_30 (PB13)
Steering Sensor: J3.4, U6.10 (+)
Steering Sensor 3V3: R12.2, R13.2, U3.CN10_6 (PC5)

Notes on the sheet:
1 CAN bus -> 2 CAN Busses SPI Connected to 2 can controllers https://ww1.microchip.com/downloads/en/DeviceDoc/MCP2515-Stand-Alone-CAN-Controller-with-SPI-20001801J.pdf peripheral boards being replaced with CAN (Except power and ground) Make a list of sensors that need to be powered by PDB Reach out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
CAN1 transceiver
Voltage check
<- optional output interrupt/ready pins for the IMU's gyroscope (G) and accelerometer/magnotomer (L1/L2)
out to steering sensor

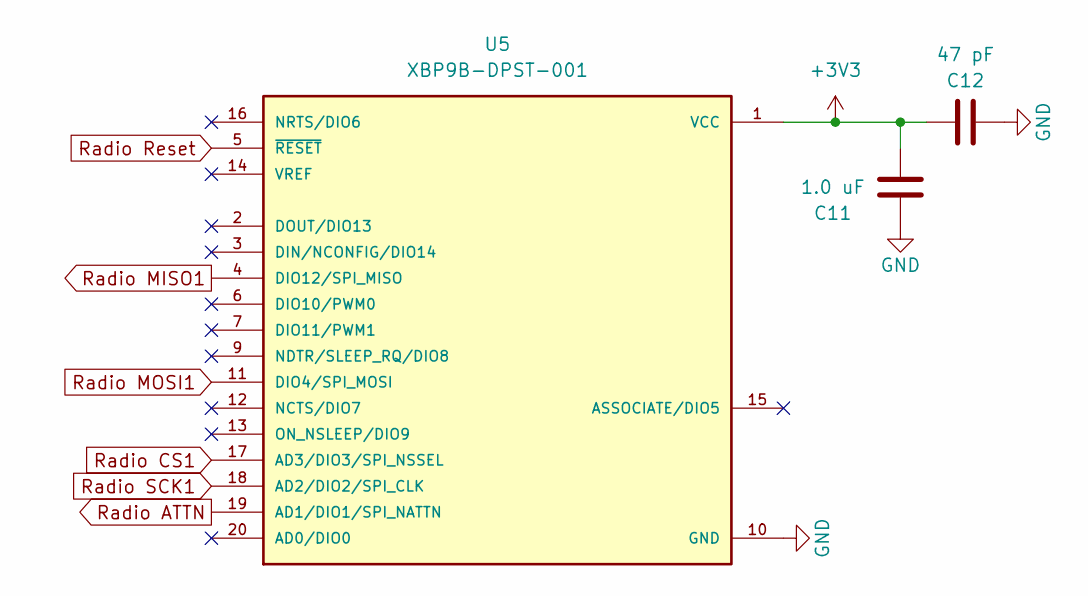
[picture p19: schematic radio.kicad_sch]

Parts:
C11: 1.0 uF; C_0805_2012Metric_Pad1.18x1.45mm_HandSolder
C12: 47 pF; C_0805_2012Metric_Pad1.18x1.45mm_HandSolder
U5: XBP9B-DPST-001

Connections:
+3V3: C11.1, C12.1, U5.1 (VCC); also elsewhere on the board
GND: C11.2, C12.2, U5.10 (GND); also elsewhere on the board
Radio ATTN: U5.19 (AD1/DIO1/SPI_NATTN); also elsewhere on the board
Radio CS1: U5.17 (AD3/DIO3/SPI_NSSEL); also elsewhere on the board
Radio MISO1: U5.4 (DIO12/SPI_MISO); also elsewhere on the board
Radio MOSI1: U5.11 (DIO4/SPI_MOSI); also elsewhere on the board
Radio Reset: U5.5 (~RESET); also elsewhere on the board
Radio SCK1: U5.18 (AD2/DIO2/SPI_CLK); also elsewhere on the board

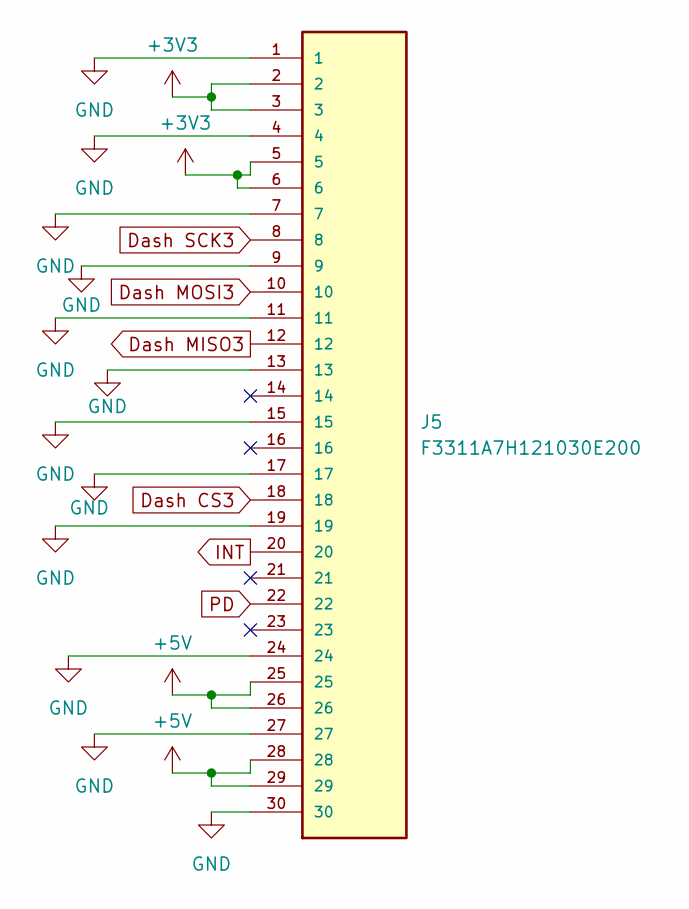
[picture p20: schematic dash.kicad_sch]

Parts:
J5: F3311A7H121030E200; AMPHENOL_F3311A7H121030E200; PARTREV A

Connections:
+3V3: J5.2, J5.3, J5.5, J5.6; also elsewhere on the board
+5V: J5.25, J5.26, J5.28, J5.29; also elsewhere on the board
Dash CS3: J5.18; also elsewhere on the board
Dash MISO3: J5.12; also elsewhere on the board
Dash MOSI3: J5.10; also elsewhere on the board
Dash SCK3: J5.8; also elsewhere on the board
GND: J5.1, J5.4, J5.7, J5.9, J5.11, J5.13, J5.15, J5.17, J5.19, J5.24, J5.27, J5.30; also elsewhere on the board
INT: J5.20; also elsewhere on the board
PD: J5.22; also elsewhere on the board

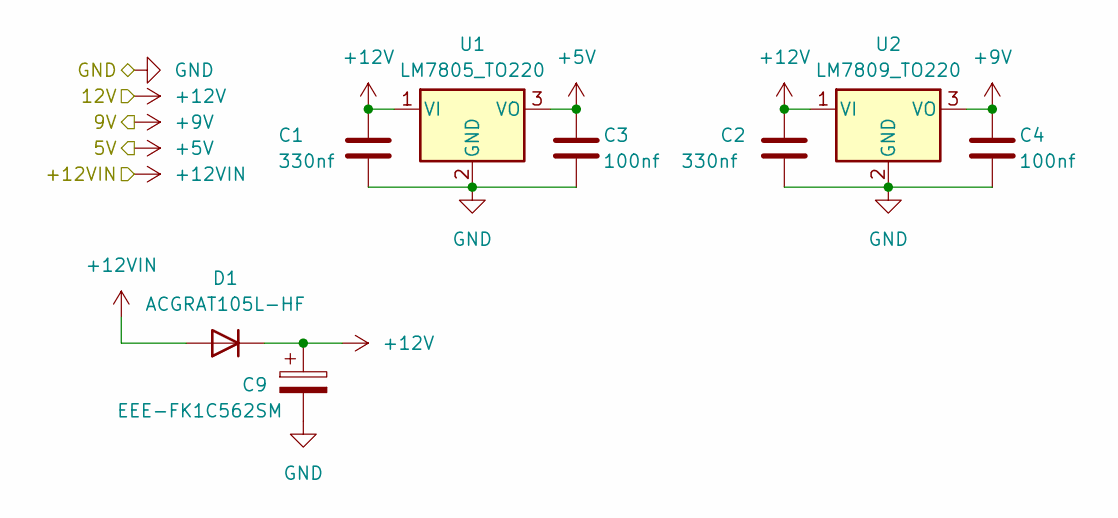
[picture p21: schematic power_distribution.kicad_sch]

Parts:
C1, C2: 330nf; C_0805_2012Metric_Pad1.18x1.45mm_HandSolder
C3, C4: 100nf; C_0805_2012Metric_Pad1.18x1.45mm_HandSolder
C9: EEE-FK1C562SM; CP_Elec_18x17.5
D1: ACGRAT105L-HF; D_2010_5025Metric_Pad1.52x2.65mm_HandSolder
U1: LM7805_TO220; TO-220-3_Vertical
U2: LM7809_TO220; TO-220-3_Vertical

Connections:
+5V: C3.1, U1.3 (VO); also elsewhere on the board
+9V: C4.1, U2.3 (VO); also elsewhere on the board
+12V: C1.1, C2.1, C9.1, D1.1 (K), U1.1 (VI), U2.1 (VI); also elsewhere on the board
+12VIN: D1.2 (A); also elsewhere on the board
GND: C1.2, C2.2, C3.2, C4.2, C9.2, U1.2 (GND), U2.2 (GND); also elsewhere on the board

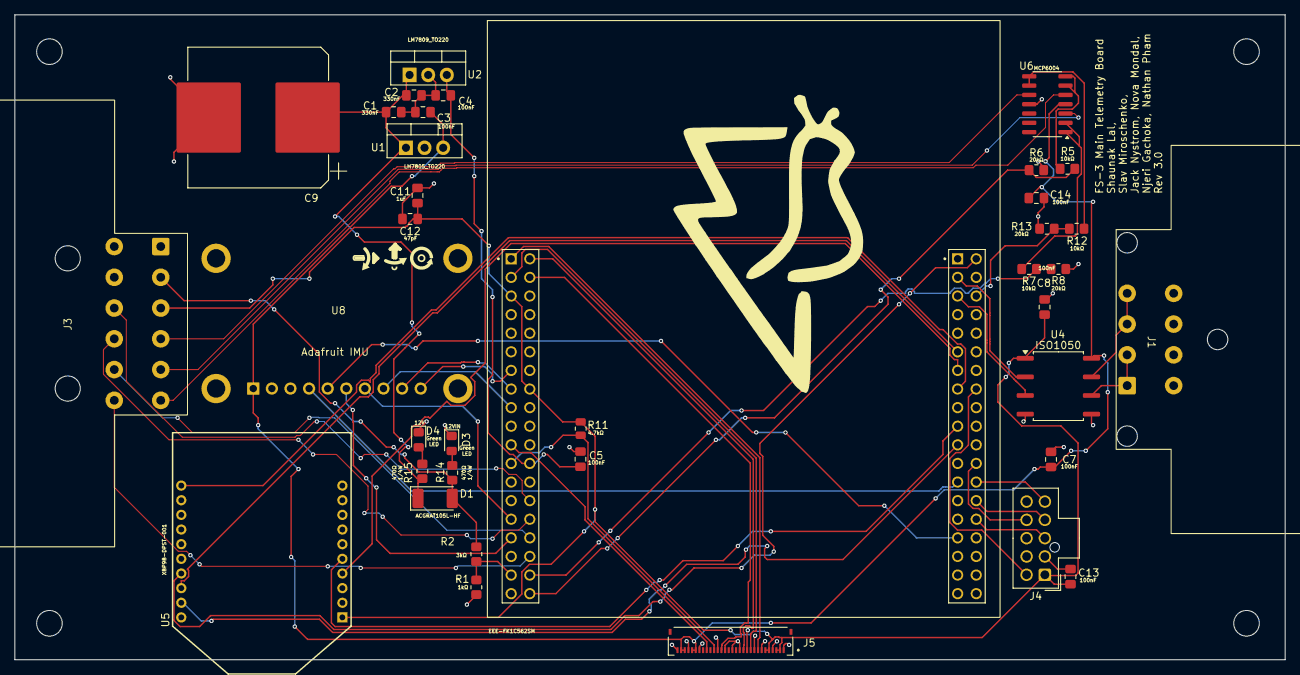
[picture p22: board TelemMainV3.kicad_pcb from above]

Board: 2 copper layers, 173.4 x 88.1 mm, 38 parts (0 on the bottom side), 50 nets.

Other parts of the board:
G1: FS Logo; FS Logo Big
