formulaslug/fs-3-schematics/Telemetry peripheral boards/FS3 Peripheral V3 ATTINY/F3 peripheral boards.kicad_pcb

## KiCad design Telemetry peripheral boards/FS3 Peripheral V3 ATTINY/F3 peripheral boards.kicad_pcb (2025-06-03, an earlier design)

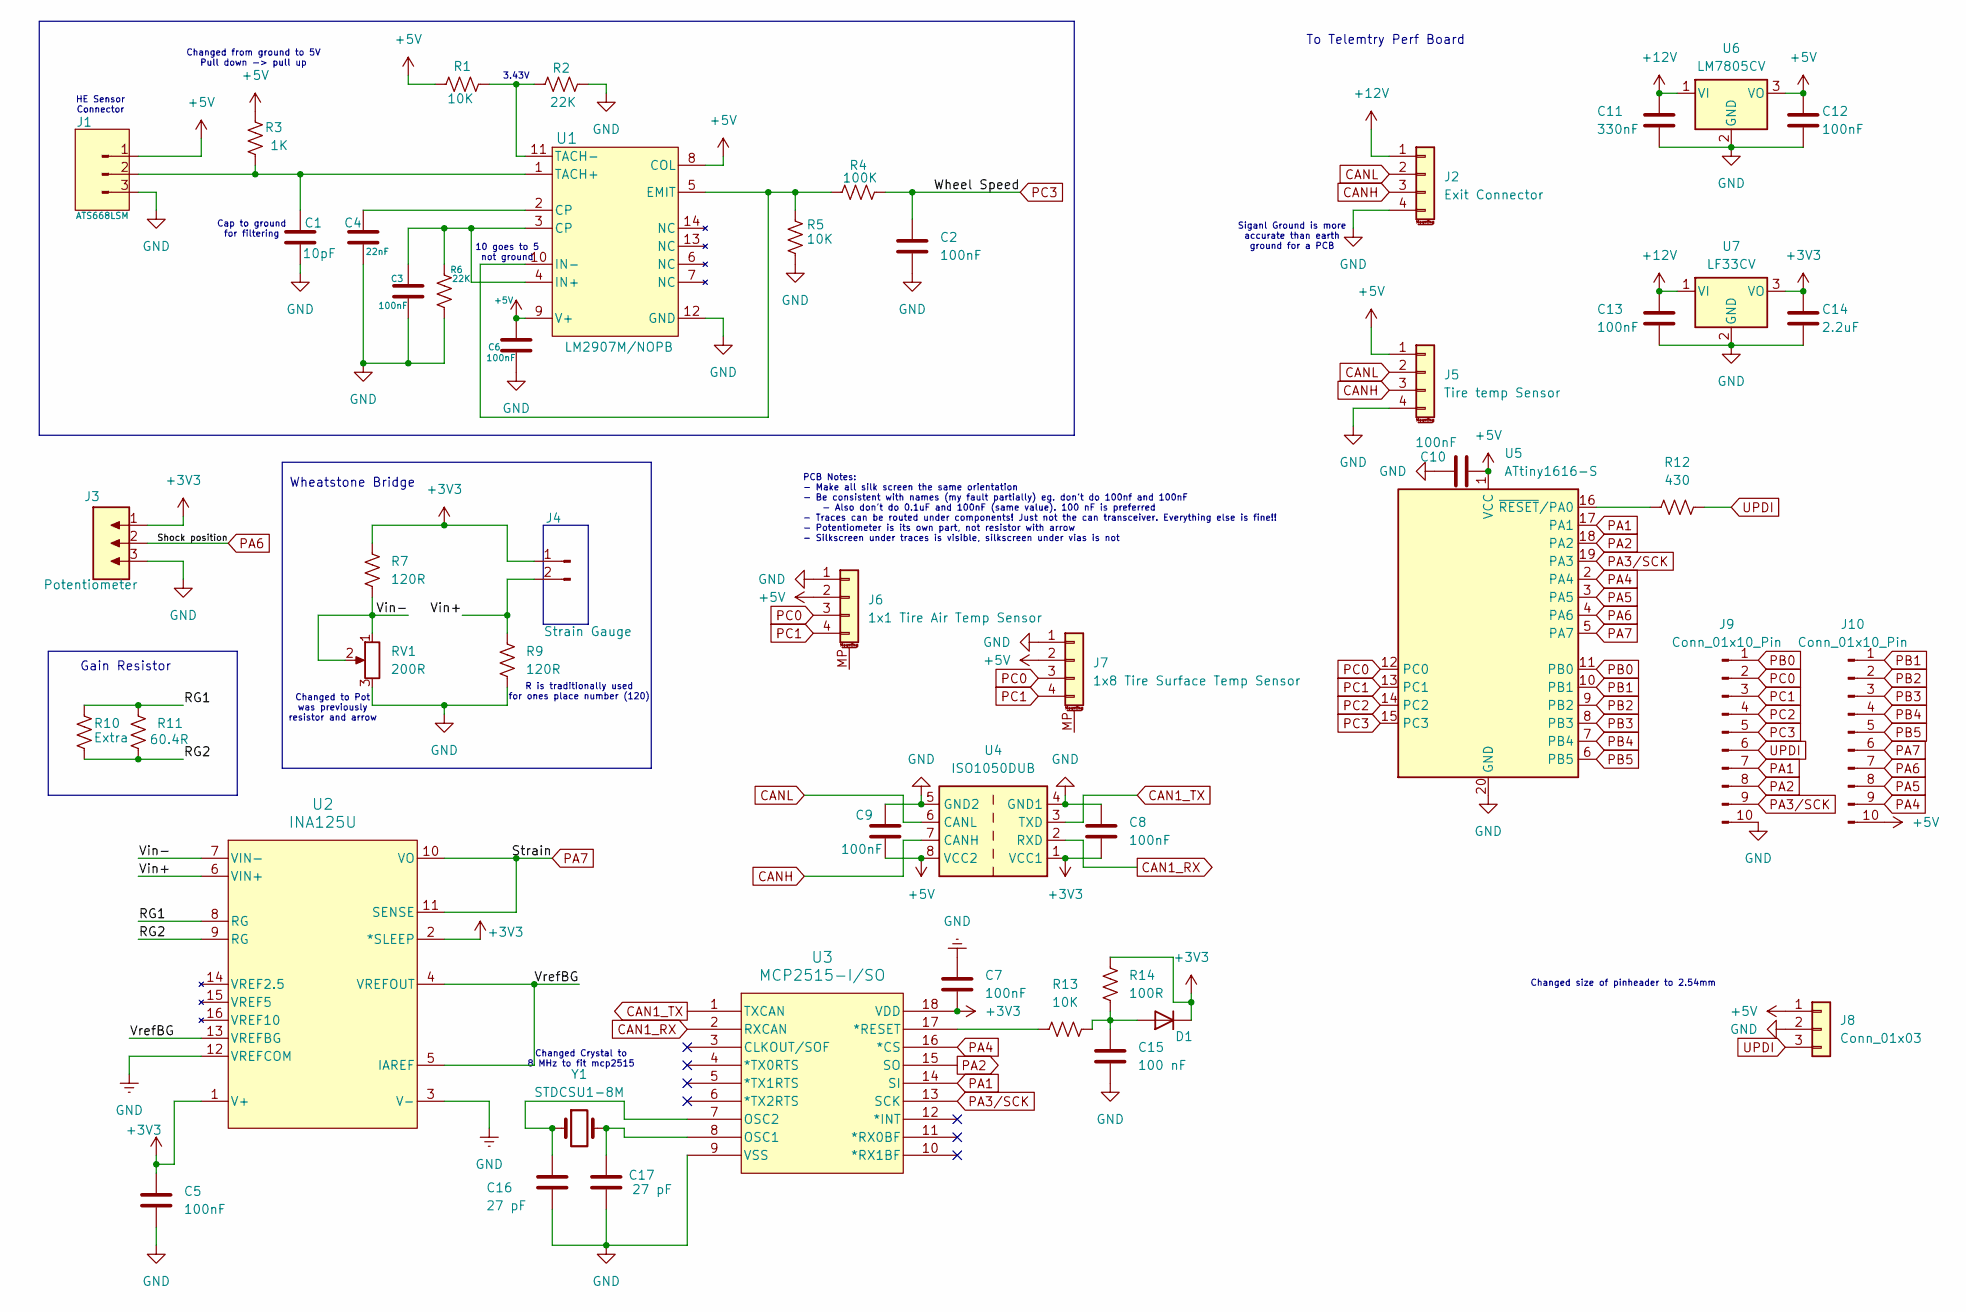
[picture p23: schematic F3 peripheral boards.kicad_sch, Peripheral Board]

Parts:
C1: 10pF; C_0805_2012Metric_Pad1.18x1.45mm_HandSolder
C2, C3, C5, C6, C7, C8, C9, C10, C12, C13: 100nF; C_0805_2012Metric_Pad1.18x1.45mm_HandSolder
C4: 22nF; C_0805_2012Metric_Pad1.18x1.45mm_HandSolder
C11: 330nF; C_0805_2012Metric_Pad1.18x1.45mm_HandSolder
C14: 2.2uF; C_0805_2012Metric_Pad1.18x1.45mm_HandSolder
C15: 100 nF; C_0805_2012Metric_Pad1.18x1.45mm_HandSolder
C16, C17: 27 pF; C_0805_2012Metric_Pad1.18x1.45mm_HandSolder
D1: D; D_0805_2012Metric
J1: ATS668LSM; Molex_Nano-Fit_105309-xx03_1x03_P2.50mm_Vertical
J2: Exit Connector; Molex_Nano-Fit_105309-xx04_1x04_P2.50mm_Vertical
J3: Potentiometer; Molex_Nano-Fit_105309-xx03_1x03_P2.50mm_Vertical
J4: Strain Gauge; Molex_Nano-Fit_105309-xx02_1x02_P2.50mm_Vertical
J5: Tire temp Sensor; Molex_Nano-Fit_105309-xx04_1x04_P2.50mm_Vertical
J6: 1x1 Tire Air Temp Sensor; Molex_Nano-Fit_105309-xx04_1x04_P2.50mm_Vertical
J7: 1x8 Tire Surface Temp Sensor; Molex_Nano-Fit_105309-xx04_1x04_P2.50mm_Vertical
J8: Conn_01x03; PinHeader_1x03_P2.54mm_Vertical
J9, J10: Conn_01x10_Pin; PinHeader_1x10_P2.54mm_Vertical
R1, R6: 22K; R_0805_2012Metric_Pad1.20x1.40mm_HandSolder
R2, R5, R13: 10K; R_0805_2012Metric_Pad1.20x1.40mm_HandSolder
R3: 1K; R_0805_2012Metric_Pad1.20x1.40mm_HandSolder
R4: 100K; R_0805_2012Metric_Pad1.20x1.40mm_HandSolder
R7, R9: 120R; R_0805_2012Metric_Pad1.20x1.40mm_HandSolder
R10: Extra; R_0805_2012Metric_Pad1.20x1.40mm_HandSolder
R11: 60.4R; R_0805_2012Metric_Pad1.20x1.40mm_HandSolder
R12: 430; R_0805_2012Metric_Pad1.20x1.40mm_HandSolder
R14: 100R; R_0805_2012Metric_Pad1.20x1.40mm_HandSolder
RV1: 200R; Potentiometer_Bourns_3296W_Vertical
U1: LM2907M/NOPB; M14A_TEX
U2: INA125U; D16
U3: MCP2515-I/SO; SOIC-18W_7.5x11.6mm_P1.27mm
U4: ISO1050DUB; SOP-8_6.62x9.15mm_P2.54mm
U5: ATtiny1616-S; SOIC-20W_7.5x12.8mm_P1.27mm
U6: LM7805CV; TO-220-3_Vertical
U7: LF33CV; TO-220-3_Vertical
Y1: STDCSU1-8M; Crystal_SMD_5032-2Pin_5.0x3.2mm_HandSoldering

Connections:
+3V3: C5.1, C7.2, C8.2, C14.1, D1.1 (K), J3.1, J4.1 (Pin_2), R7.1, R14.1, U2.1 (V+), U2.2 (*SLEEP), U3.18 (VDD), U4.1 (VCC1), U7.3 (VO)
+5V: C6.1, C9.2, C10.2, C12.1, J1.1, J5.1, J6.2, J7.2, J8.1, J10.10, R1.2, R3.1, U1.8 (COL), U1.9 (V+), U4.8 (VCC2), U5.1 (VCC), U6.3 (VO)
+12V: C11.1, C13.1, J2.1, U6.1 (VI), U7.1 (VI)
/RG1: R10.1, R11.1, U2.8 (RG)
/RG2: R10.2, R11.2, U2.9 (RG)
/Vin+: J4.2 (Pin_1), R9.1, U2.6 (VIN+)
/Vin-: R7.2, RV1.1, RV1.2, U2.7 (VIN-)
/VrefBG: U2.4 (VREFOUT), U2.5 (IAREF), U2.13 (VREFBG)
CAN1_RX: U3.2 (RXCAN), U4.2 (RXD)
CAN1_TX: U3.1 (TXCAN), U4.3 (TXD)
CANH: J2.3, J5.3, U4.7 (CANH)
CANL: J2.2, J5.2, U4.6 (CANL)
GND: C1.2, C2.2, C3.2, C4.2, C5.2, C6.2, C7.1, C8.1, C9.1, C10.1, C11.2, C12.2, C13.2, C14.2, C15.2, C16.2, C17.2, J1.3, J2.4, J3.3, J5.4, J6.1, J7.1, J8.2, J9.10, R2.2, R5.2, R6.2, R9.2, RV1.3, U1.12 (GND), U2.3 (V-), U2.12 (VREFCOM), U3.9 (VSS), U4.4 (GND1), U4.5 (GND2), U5.20 (GND), U6.2 (GND), U7.2 (GND)
unnamed: C4.1, U1.2 (CP)
unnamed: C15.1, D1.2 (A), R13.2, R14.2
unnamed: C1.1, J1.2, R3.2, U1.1 (TACH+)
unnamed: R4.1, R5.1, U1.5 (EMIT), U1.10 (IN-)
unnamed: C3.1, R6.1, U1.3 (CP), U1.4 (IN+)
unnamed: R1.1, R2.1, U1.11 (TACH-)
unnamed: R13.1, U3.17 (*RESET)
unnamed: C17.1, U3.8 (OSC1), Y1.2
unnamed: C16.1, U3.7 (OSC2), Y1.1
unnamed: R12.1, U5.16 (~RESET/PA0)
PA1: J9.7, U3.14 (SI), U5.17 (PA1)
PA2: J9.8, U3.15 (SO), U5.18 (PA2)
PA3/SCK: J9.9, U3.13 (SCK), U5.19 (PA3)
PA4: J10.9, U3.16 (*CS), U5.2 (PA4)
PA5: J10.8, U5.3 (PA5)
PA6: J3.2, J10.7, U5.4 (PA6)
PA7: J10.6, U2.10 (VO), U2.11 (SENSE), U5.5 (PA7)
PB0: J9.1, U5.11 (PB0)
PB1: J10.1, U5.10 (PB1)
PB2: J10.2, U5.9 (PB2)
PB3: J10.3, U5.8 (PB3)
PB4: J10.4, U5.7 (PB4)
PB5: J10.5, U5.6 (PB5)
PC0: J6.3, J7.3, J9.2, U5.12 (PC0)
PC1: J6.4, J7.4, J9.3, U5.13 (PC1)
PC2: J9.4, U5.14 (PC2)
PC3: C2.1, J9.5, R4.2, U5.15 (PC3)
UPDI: J8.3, J9.6, R12.2

Notes on the sheet:
Changed size of pinheader to 2.54mm
Cap to ground for filtering
HE Sensor Connector
To Telemtry Perf Board
Gain Resistor
Changed to Pot was previously resistor and arrow
PCB Notes: - Make all silk screen the same orientation - Be consistent with names (my fault partially) eg. don't do 100nf and 100nF - Also don't do 0.1uF and 100nF (same value). 100 nF is preferred - Traces can be routed under components! Just not the can transceiver. Everything else is fine!! - Po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
Changed from ground to 5V Pull down -> pull up
10 goes to 5 not ground
Changed Crystal to 8 MHz to fit mcp2515
R is traditionally used for ones place number (120)
Siganl Ground is more accurate than earth ground for a PCB
Wheatstone Bridge
3.43V

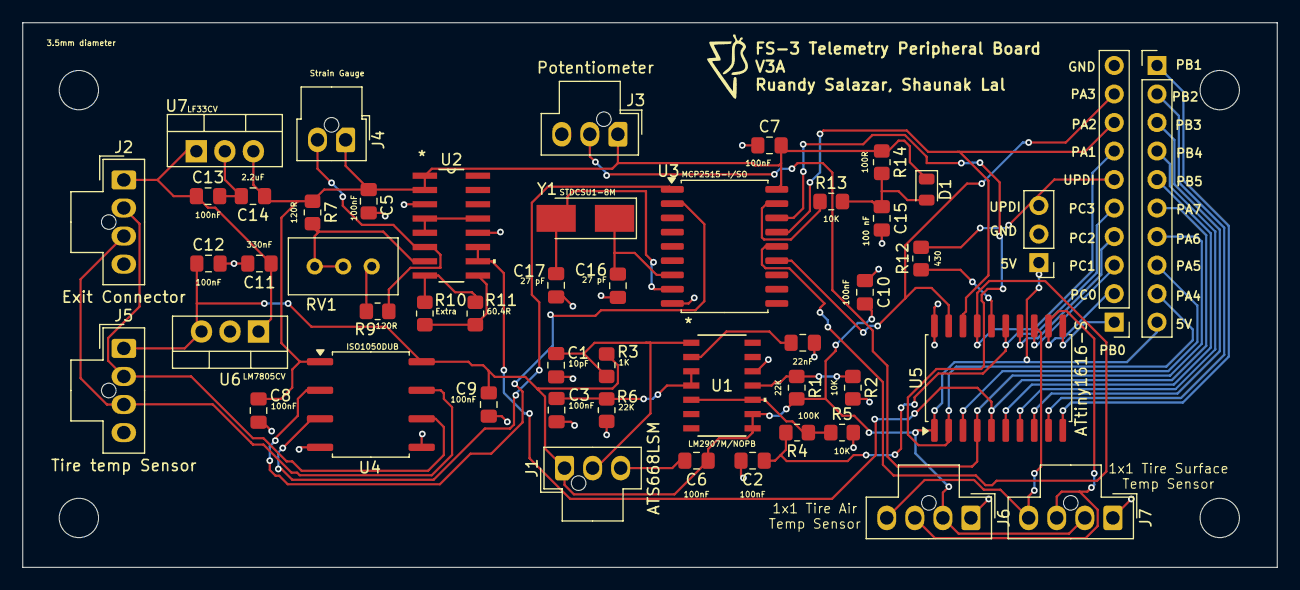
[picture p24: board F3 peripheral boards.kicad_pcb from above]

Board: 2 copper layers, 111.7 x 48.5 mm, 50 parts (0 on the bottom side), 41 nets.
