formulaslug/fs-3-schematics/Power Distrobution Board/Power DIstrobution Board.kicad_pcb

## KiCad design Power Distrobution Board/Power DIstrobution Board.kicad_pcb (2025-05-30)

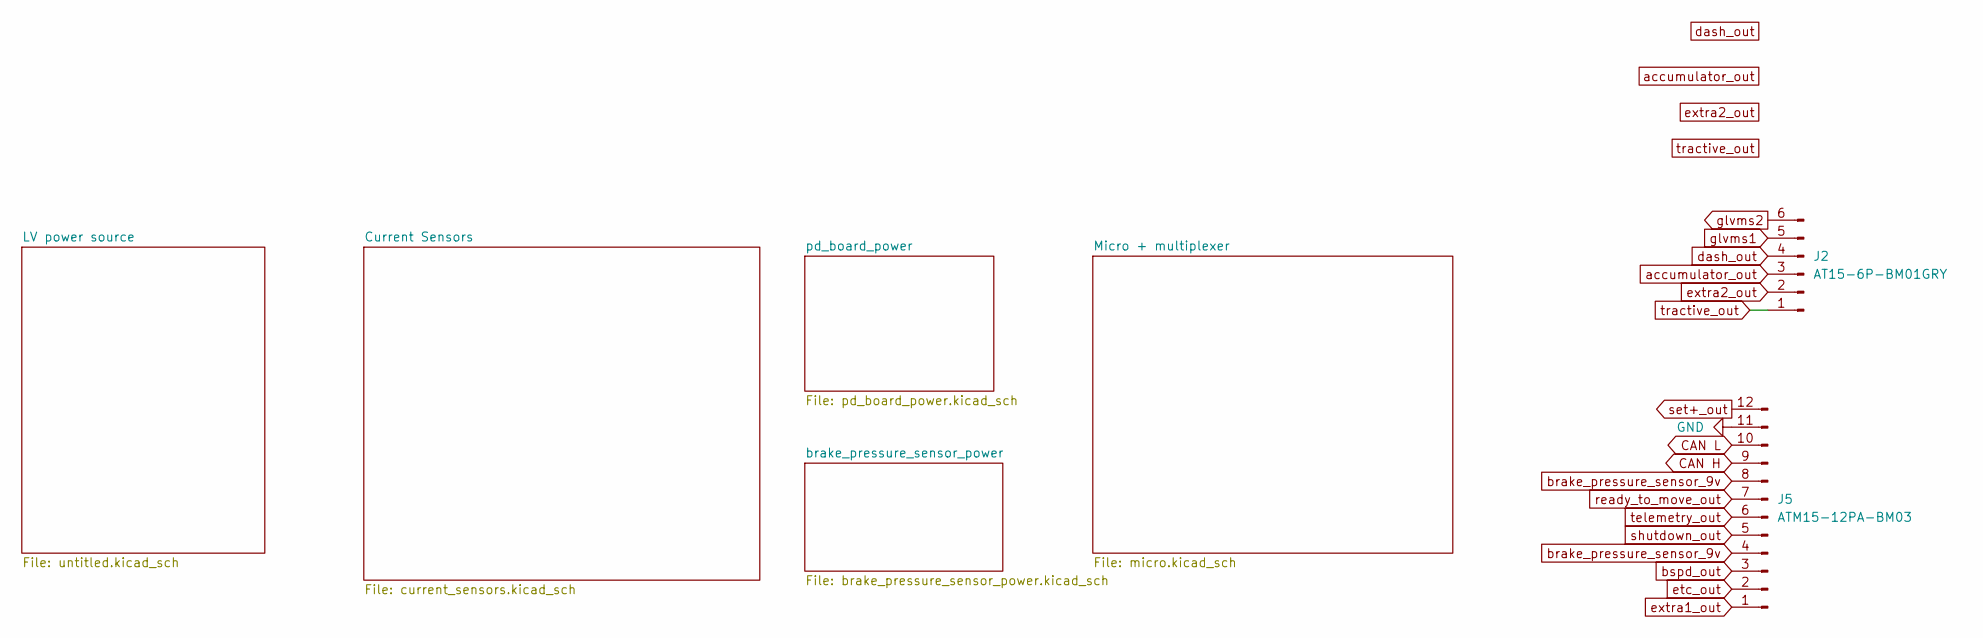
[picture p25: schematic Power DIstrobution Board.kicad_sch, PD BOARD]

Parts:
J2: AT15-6P-BM01GRY; CONN6_DT15-6P_TEC
J5: ATM15-12PA-BM03; TE_DTM15-12PA

Connections:
CAN H: J5.9; also elsewhere on the board
CAN L: J5.10; also elsewhere on the board
GND: J5.11; also elsewhere on the board
accumulator_out: J2.3; also elsewhere on the board
brake_pressure_sensor_9v: J5.4, J5.8; also elsewhere on the board
bspd_out: J5.3; also elsewhere on the board
dash_out: J2.4; also elsewhere on the board
etc_out: J5.2; also elsewhere on the board
extra1_out: J5.1; also elsewhere on the board
extra2_out: J2.2; also elsewhere on the board
glvms1: J2.5; also elsewhere on the board
ready_to_move_out: J5.7; also elsewhere on the board
set+_out: J5.12; also elsewhere on the board
shutdown_out: J5.5; also elsewhere on the board
telemetry_out: J5.6; also elsewhere on the board
tractive_out: J2.1; also elsewhere on the board
