formulaslug/fs-3-schematics/Power Distrobution Board/Power DIstrobution Board.kicad_pcb

## KiCad design Power Distrobution Board/Power DIstrobution Board.kicad_pcb (continued)

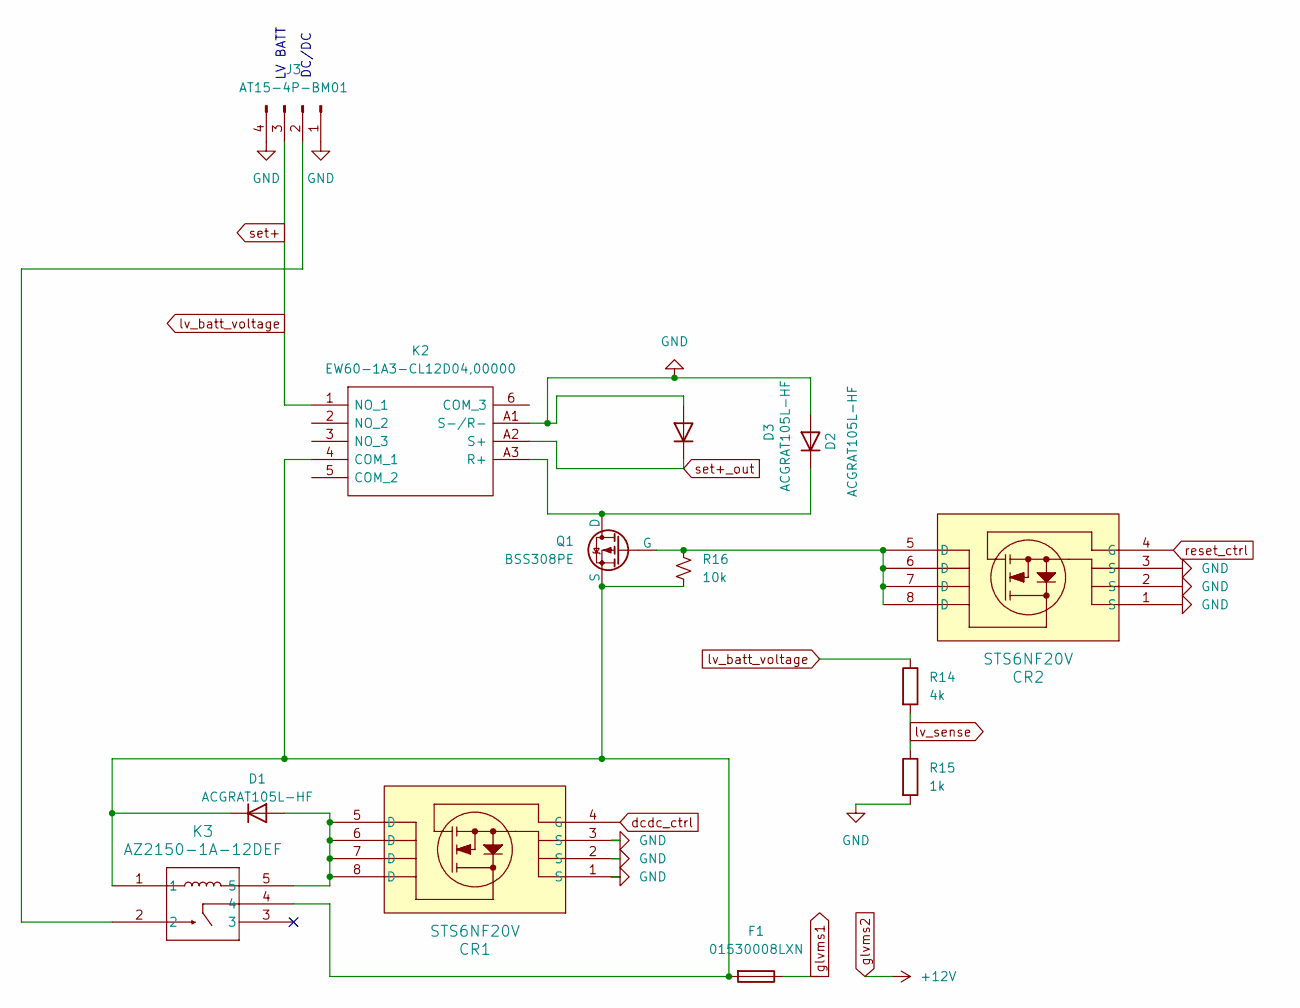
[picture p26: schematic untitled.kicad_sch]

Parts:
CR1, CR2: STS6NF20V; SOIC-8_3.9x4.9mm_P1.27mm
D1, D2, D3: ACGRAT105L-HF; D_2010_5025Metric_Pad1.52x2.65mm_HandSolder
F1: 01530008LXN
J3: AT15-4P-BM01; CONN4_DT15-4P-G003
K2: EW60-1A3-CL12D04,00000; EW601A3CL12D0400000; Manufacturer_Part_Number EW60-1A3-CL12D04,00000
K3: AZ2150-1A-12DEF; AZ2150_AMZ
Q1: BSS308PE; SOT-23_Handsoldering
R14: 4k; R_0805_2012Metric_Pad1.20x1.40mm_HandSolder
R15: 1k; R_0805_2012Metric_Pad1.20x1.40mm_HandSolder
R16: 10k; R_0805_2012Metric_Pad1.20x1.40mm_HandSolder

Connections:
GND: CR1.1 (S), CR1.2 (S), CR1.3 (S), CR2.1 (S), CR2.2 (S), CR2.3 (S), D2.2 (A), D3.2 (A), J3.1, J3.4, K2.A1 (S-/R-), R15.2; also elsewhere on the board
unnamed: CR1.5 (D), CR1.6 (D), CR1.7 (D), CR1.8 (D), D1.2 (A), K3.5
unnamed: D1.1 (K), F1.2, K2.4 (COM_1), K3.1, K3.4, Q1.2 (S), R16.1
unnamed: D2.1 (K), K2.A3 (R+), Q1.3 (D)
unnamed: J3.2, K3.2
unnamed: CR2.5 (D), CR2.6 (D), CR2.7 (D), CR2.8 (D), Q1.1 (G), R16.2
dcdc_ctrl: CR1.4 (G); also elsewhere on the board
glvms1: F1.1; also elsewhere on the board
lv_batt_voltage: J3.3, K2.1 (NO_1), R14.1
lv_sense: R14.2, R15.1; also elsewhere on the board
reset_ctrl: CR2.4 (G); also elsewhere on the board
set+_out: D3.1 (K), K2.A2 (S+); also elsewhere on the board

Notes on the sheet:
DC/DC
LV BATT

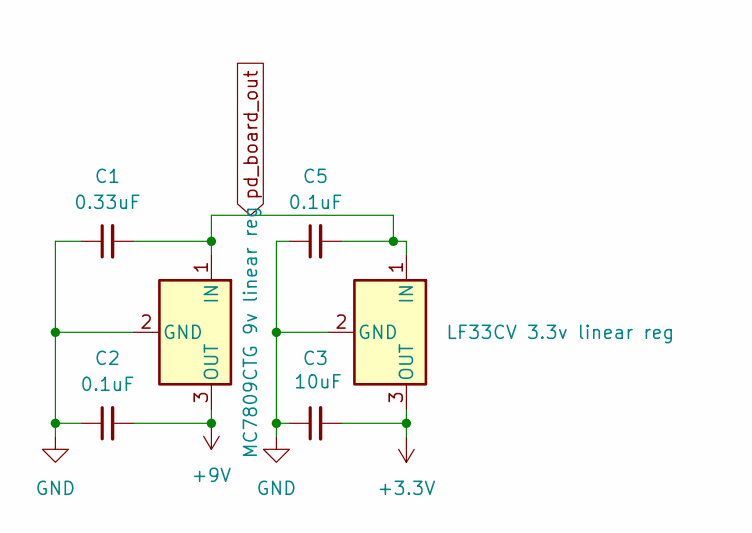
[picture p27: schematic pd_board_power.kicad_sch]

Parts:
C1: 0.33uF; C_0805_2012Metric_Pad1.18x1.45mm_HandSolder
C2, C5: 0.1uF; C_0805_2012Metric_Pad1.18x1.45mm_HandSolder
C3: 10uF; C_0805_2012Metric_Pad1.18x1.45mm_HandSolder
U1: LF33CV 3.3v linear reg; TO-220-3_Horizontal_TabDown
U14: MC7809CTG 9v linear reg; TO-220-3_Horizontal_TabDown

Connections:
+3.3V: C3.2, U1.3 (OUT); also elsewhere on the board
+9V: C2.2, U14.3 (OUT); also elsewhere on the board
GND: C1.1, C2.1, C3.1, C5.1, U1.2 (GND), U14.2 (GND); also elsewhere on the board
pd_board_out: C1.2, C5.2, U1.1 (IN), U14.1 (IN); also elsewhere on the board

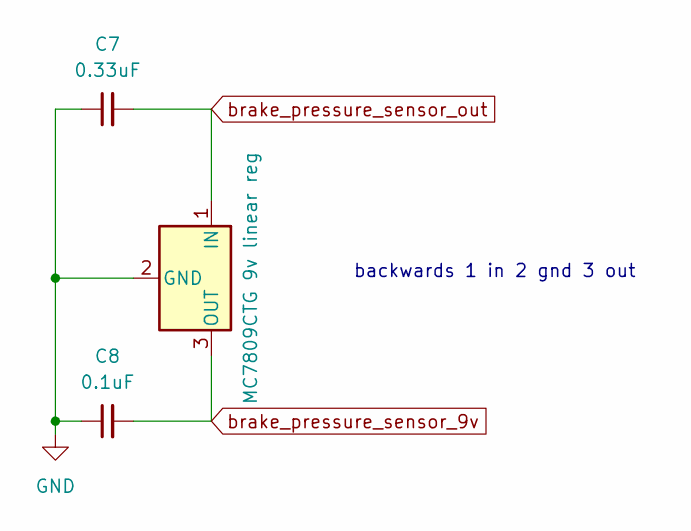
[picture p28: schematic brake_pressure_sensor_power.kicad_sch]

Parts:
C7: 0.33uF; C_0805_2012Metric_Pad1.18x1.45mm_HandSolder
C8: 0.1uF; C_0805_2012Metric_Pad1.18x1.45mm_HandSolder
U15: MC7809CTG 9v linear reg; TO-220-3_Horizontal_TabDown

Connections:
GND: C7.1, C8.1, U15.2 (GND); also elsewhere on the board
brake_pressure_sensor_9v: C8.2, U15.3 (OUT); also elsewhere on the board
brake_pressure_sensor_out: C7.2, U15.1 (IN); also elsewhere on the board

Notes on the sheet:
backwards 1 in 2 gnd 3 out

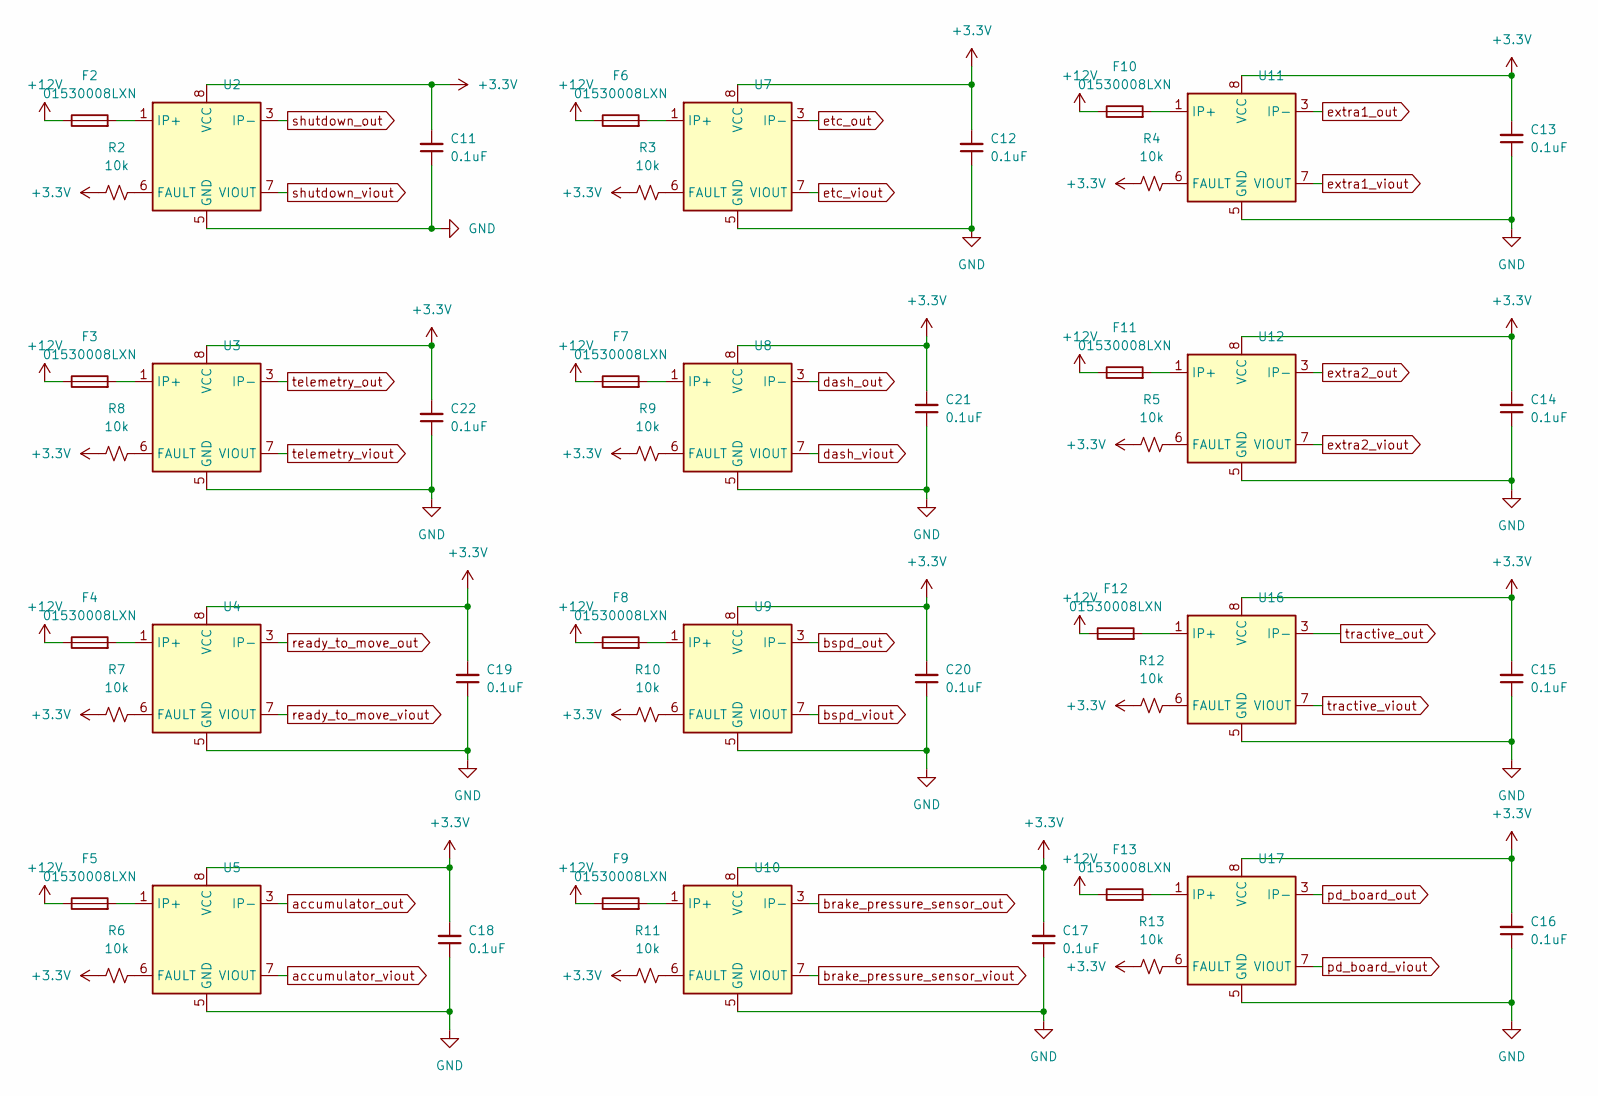
[picture p29: schematic current_sensors.kicad_sch]

Parts:
C11, C12, C13, C14, C15, C16, C17, C18, C19, C20, C21, C22: 0.1uF; C_0805_2012Metric_Pad1.18x1.45mm_HandSolder
F2, F3, F4, F5, F6, F7, F8, F9, F10, F11, F12, F13: 01530008LXN
R2, R3, R4, R5, R6, R7, R8, R9, R10, R11, R12, R13: 10k; R_0805_2012Metric_Pad1.20x1.40mm_HandSolder
U2, U3, U4, U5, U7, U8, U9, U10, U11, U12, U16, U17: ACS71240LLCBTR-025B3; SOIC-8_3.9x4.9mm_P1.27mm

Connections:
+3.3V: C11.2, C12.2, C13.2, C14.2, C15.2, C16.2, C17.2, C18.2, C19.2, C20.2, C21.2, C22.2, R2.1, R3.1, R4.1, R5.1, R6.1, R7.1, R8.1, R9.1, R10.1, R11.1, R12.1, R13.1, U2.8 (VCC), U3.8 (VCC), U4.8 (VCC), U5.8 (VCC), U7.8 (VCC), U8.8 (VCC), U9.8 (VCC), U10.8 (VCC), U11.8 (VCC), U12.8 (VCC), U16.8 (VCC), U17.8 (VCC); also elsewhere on the board
GND: C11.1, C12.1, C13.1, C14.1, C15.1, C16.1, C17.1, C18.1, C19.1, C20.1, C21.1, C22.1, U2.5 (GND), U3.5 (GND), U4.5 (GND), U5.5 (GND), U7.5 (GND), U8.5 (GND), U9.5 (GND), U10.5 (GND), U11.5 (GND), U12.5 (GND), U16.5 (GND), U17.5 (GND); also elsewhere on the board
unnamed: F2.2, U2.1 (IP+), U2.2 (IP+)
unnamed: F3.2, U3.1 (IP+), U3.2 (IP+)
unnamed: F4.2, U4.1 (IP+), U4.2 (IP+)
unnamed: F5.2, U5.1 (IP+), U5.2 (IP+)
unnamed: F6.2, U7.1 (IP+), U7.2 (IP+)
unnamed: F7.2, U8.1 (IP+), U8.2 (IP+)
unnamed: F8.2, U9.1 (IP+), U9.2 (IP+)
unnamed: F9.2, U10.1 (IP+), U10.2 (IP+)
unnamed: F10.2, U11.1 (IP+), U11.2 (IP+)
unnamed: F11.2, U12.1 (IP+), U12.2 (IP+)
unnamed: F12.2, U16.1 (IP+), U16.2 (IP+)
unnamed: F13.2, U17.1 (IP+), U17.2 (IP+)
unnamed: R2.2, U2.6 (FAULT)
unnamed: R8.2, U3.6 (FAULT)
unnamed: R7.2, U4.6 (FAULT)
unnamed: R6.2, U5.6 (FAULT)
unnamed: R3.2, U7.6 (FAULT)
unnamed: R9.2, U8.6 (FAULT)
unnamed: R10.2, U9.6 (FAULT)
unnamed: R11.2, U10.6 (FAULT)
unnamed: R4.2, U11.6 (FAULT)
unnamed: R5.2, U12.6 (FAULT)
unnamed: R12.2, U16.6 (FAULT)
unnamed: R13.2, U17.6 (FAULT)
accumulator_out: U5.3 (IP-), U5.4 (IP-); also elsewhere on the board
accumulator_viout: U5.7 (VIOUT); also elsewhere on the board
brake_pressure_sensor_out: U10.3 (IP-), U10.4 (IP-); also elsewhere on the board
brake_pressure_sensor_viout: U10.7 (VIOUT); also elsewhere on the board
bspd_out: U9.3 (IP-), U9.4 (IP-); also elsewhere on the board
bspd_viout: U9.7 (VIOUT); also elsewhere on the board
dash_out: U8.3 (IP-), U8.4 (IP-); also elsewhere on the board
dash_viout: U8.7 (VIOUT); also elsewhere on the board
etc_out: U7.3 (IP-), U7.4 (IP-); also elsewhere on the board
etc_viout: U7.7 (VIOUT); also elsewhere on the board
extra1_out: U11.3 (IP-), U11.4 (IP-); also elsewhere on the board
extra1_viout: U11.7 (VIOUT); also elsewhere on the board
extra2_out: U12.3 (IP-), U12.4 (IP-); also elsewhere on the board
extra2_viout: U12.7 (VIOUT); also elsewhere on the board
pd_board_out: U17.3 (IP-), U17.4 (IP-); also elsewhere on the board
pd_board_viout: U17.7 (VIOUT); also elsewhere on the board
ready_to_move_out: U4.3 (IP-), U4.4 (IP-); also elsewhere on the board
ready_to_move_viout: U4.7 (VIOUT); also elsewhere on the board
shutdown_out: U2.3 (IP-), U2.4 (IP-); also elsewhere on the board
shutdown_viout: U2.7 (VIOUT); also elsewhere on the board
telemetry_out: U3.3 (IP-), U3.4 (IP-); also elsewhere on the board
telemetry_viout: U3.7 (VIOUT); also elsewhere on the board
tractive_out: U16.3 (IP-), U16.4 (IP-); also elsewhere on the board
tractive_viout: U16.7 (VIOUT); also elsewhere on the board

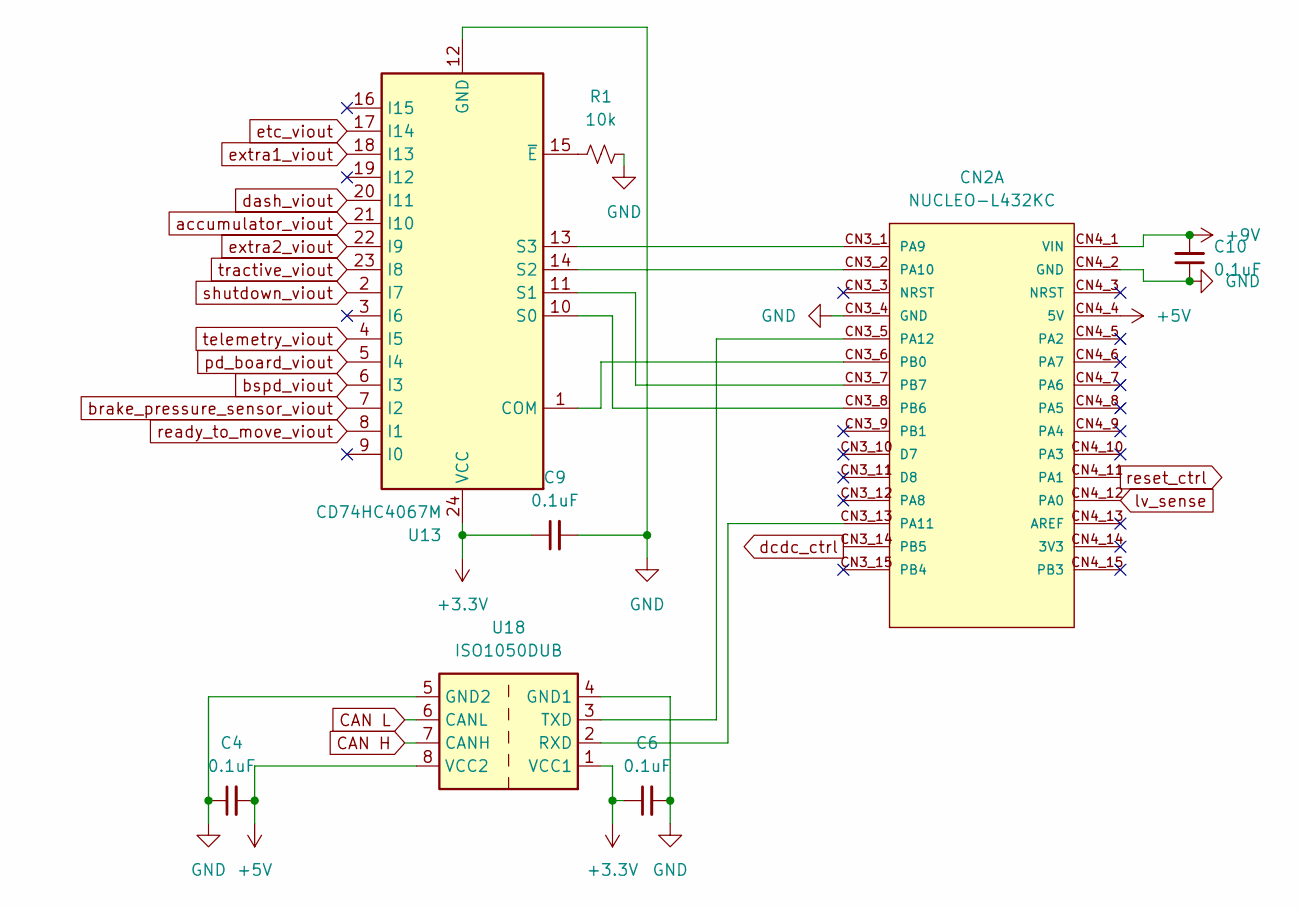
[picture p30: schematic micro.kicad_sch, PD Micro]

Parts:
C4, C6, C9, C10: 0.1uF; C_0805_2012Metric_Pad1.18x1.45mm_HandSolder
CN2: NUCLEO-L432KC; PARTREV N/A
R1: 10k; R_0805_2012Metric_Pad1.20x1.40mm_HandSolder
U13: CD74HC4067M; SOIC-24W_7.5x15.4mm_P1.27mm
U18: ISO1050DUB; SOP-8_6.62x9.15mm_P2.54mm

Connections:
+3.3V: C6.1, C9.1, U13.24 (VCC), U18.1 (VCC1); also elsewhere on the board
+5V: C4.2, CN2.CN4_4 (5V), U18.8 (VCC2)
+9V: C10.2, CN2.CN4_1 (VIN); also elsewhere on the board
CAN H: U18.7 (CANH); also elsewhere on the board
CAN L: U18.6 (CANL); also elsewhere on the board
GND: C4.1, C6.2, C9.2, C10.1, CN2.CN3_4 (GND), CN2.CN4_2 (GND), R1.2, U13.12 (GND), U18.4 (GND1), U18.5 (GND2); also elsewhere on the board
unnamed: CN2.CN3_1 (PA9), U13.13 (S3)
unnamed: CN2.CN3_2 (PA10), U13.14 (S2)
unnamed: CN2.CN3_13 (PA11), U18.2 (RXD)
unnamed: CN2.CN3_5 (PA12), U18.3 (TXD)
unnamed: CN2.CN3_6 (PB0), U13.1 (COM)
unnamed: CN2.CN3_8 (PB6), U13.10 (S0)
unnamed: CN2.CN3_7 (PB7), U13.11 (S1)
unnamed: R1.1, U13.15 (~E)
accumulator_viout: U13.21 (I10); also elsewhere on the board
brake_pressure_sensor_viout: U13.7 (I2); also elsewhere on the board
bspd_viout: U13.6 (I3); also elsewhere on the board
dash_viout: U13.20 (I11); also elsewhere on the board
dcdc_ctrl: CN2.CN3_14 (PB5); also elsewhere on the board
etc_viout: U13.17 (I14); also elsewhere on the board
extra1_viout: U13.18 (I13); also elsewhere on the board
extra2_viout: U13.22 (I9); also elsewhere on the board
lv_sense: CN2.CN4_12 (PA0); also elsewhere on the board
pd_board_viout: U13.5 (I4); also elsewhere on the board
ready_to_move_viout: U13.8 (I1); also elsewhere on the board
reset_ctrl: CN2.CN4_11 (PA1); also elsewhere on the board
shutdown_viout: U13.2 (I7); also elsewhere on the board
telemetry_viout: U13.4 (I5); also elsewhere on the board
tractive_viout: U13.23 (I8); also elsewhere on the board

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
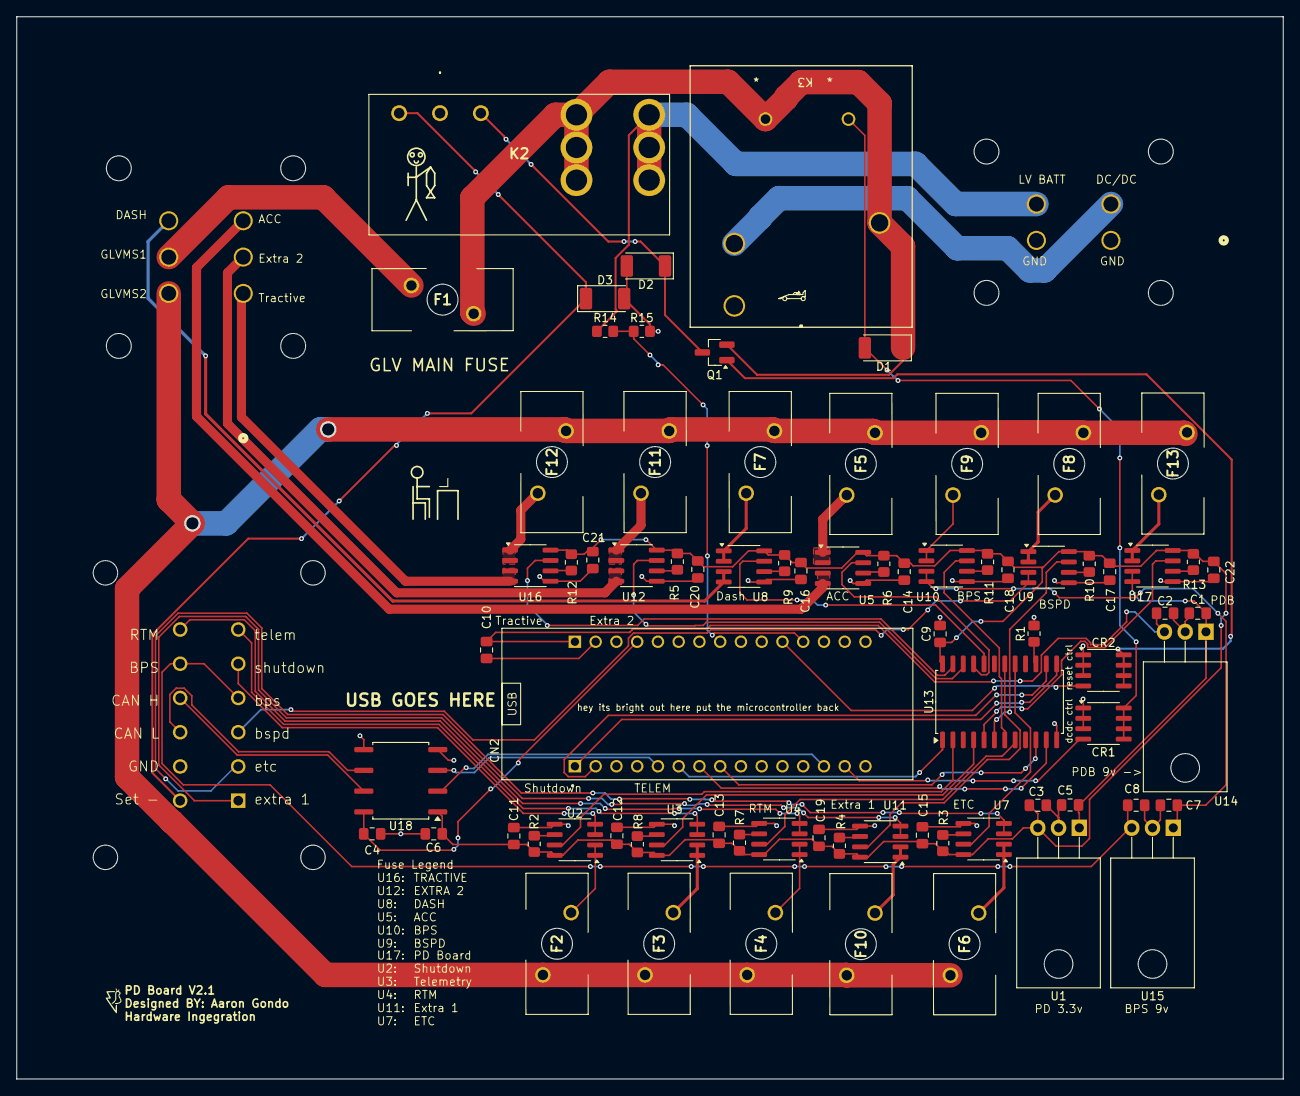
[picture p31: board Power DIstrobution Board.kicad_pcb from above]

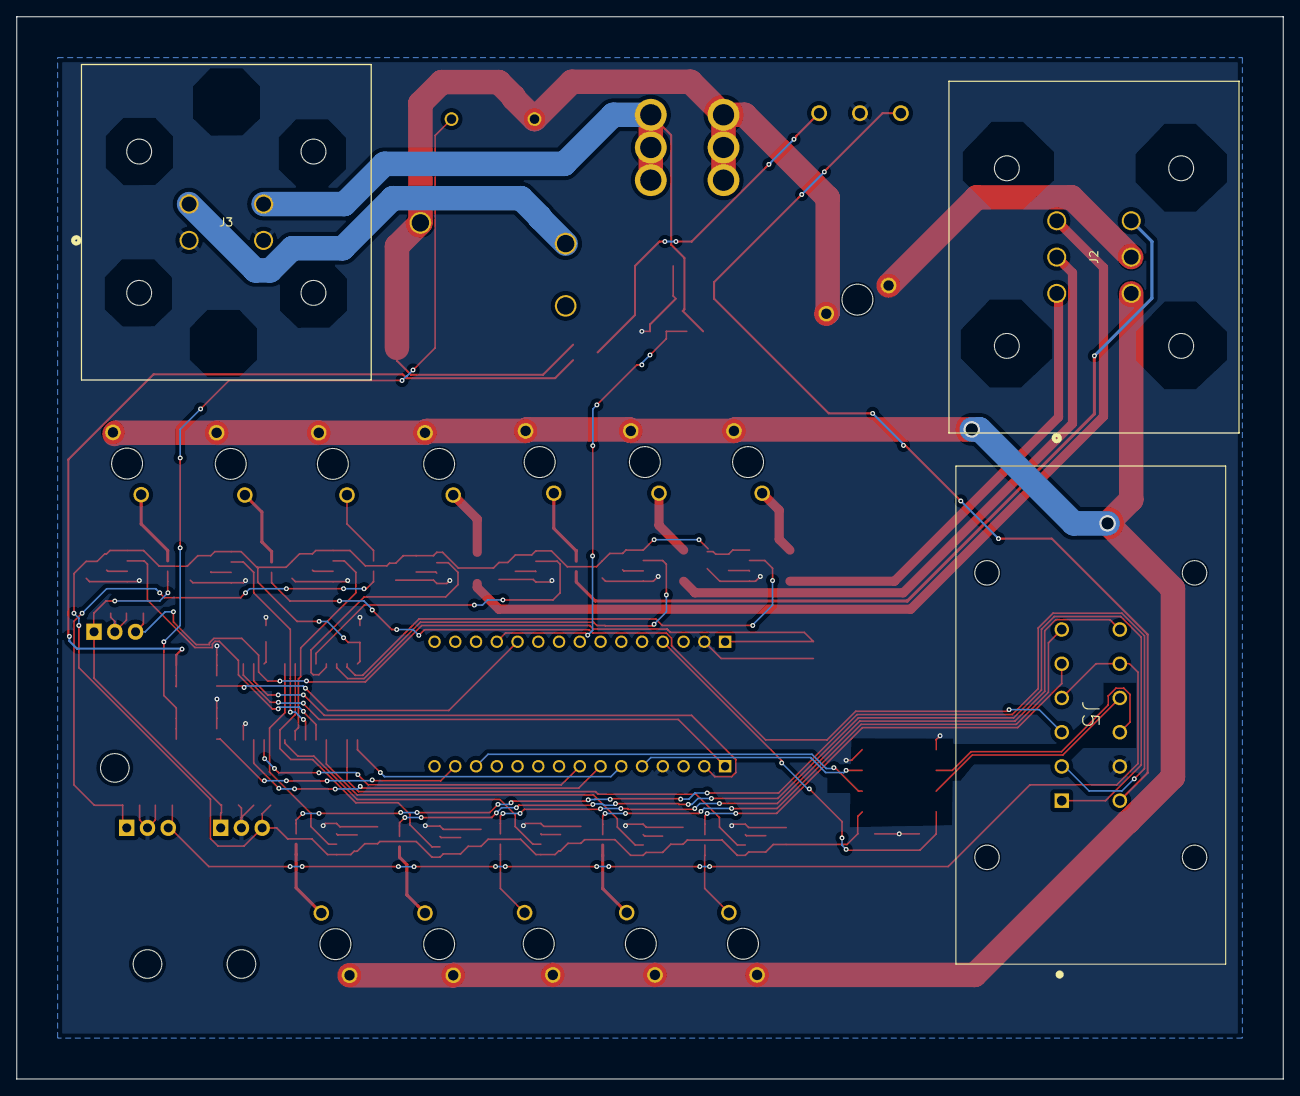
[picture p32: board Power DIstrobution Board.kicad_pcb from below]

Board: 2 copper layers, 155.0 x 130.0 mm, 79 parts (3 on the bottom side), 75 nets.
