formulaslug/fs-3-schematics/Accumulator_Board/Accumulator_Board.kicad_pcb

## KiCad design Accumulator_Board/Accumulator_Board.kicad_pcb (2025-05-08)

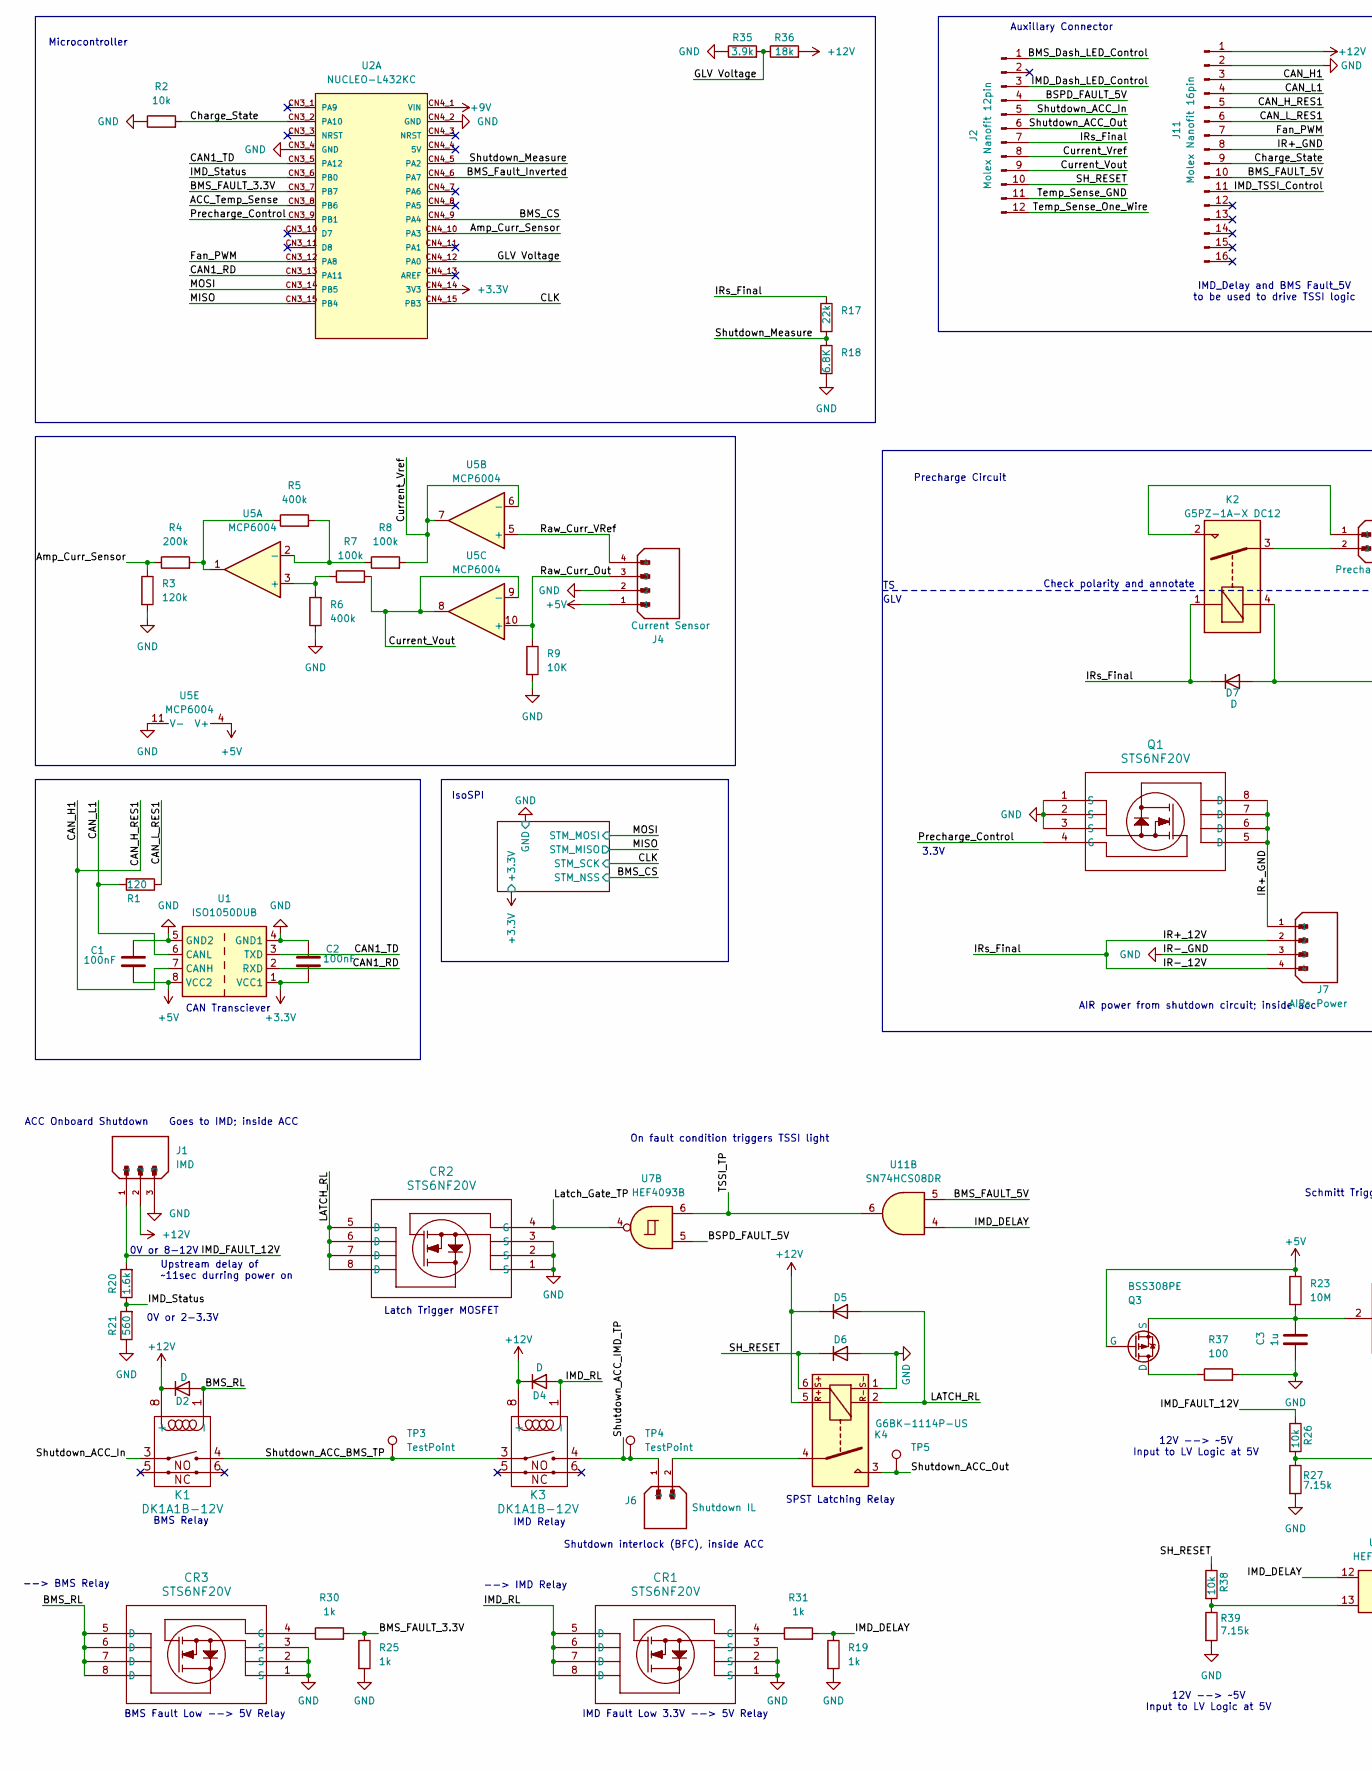
[picture p33: schematic Accumulator_Board.kicad_sch, Accumulator Board, part in row 1, column 1]

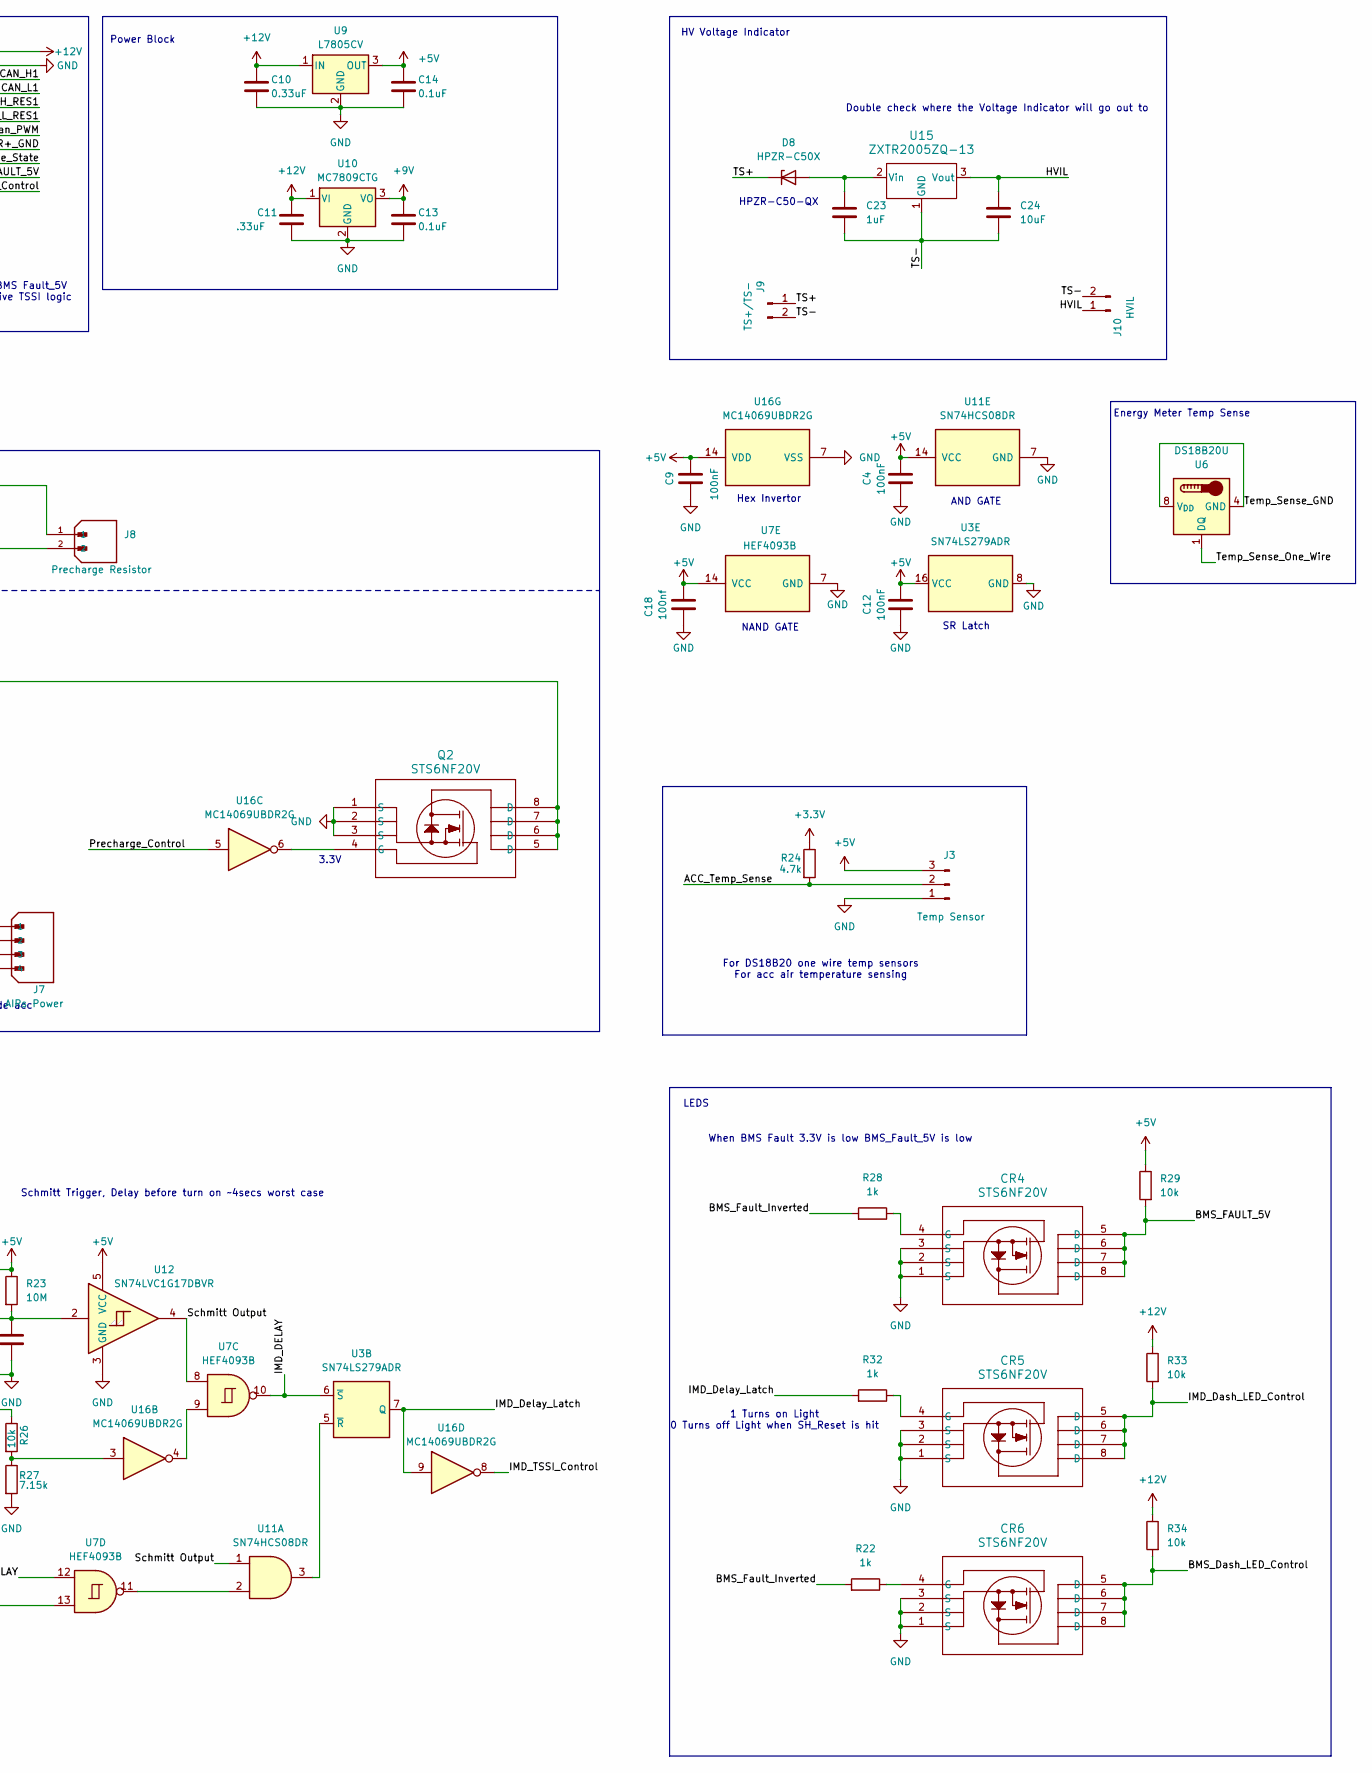
[picture p34: schematic Accumulator_Board.kicad_sch, Accumulator Board, part in row 1, column 2]

Parts:
C1, C2, C4, C9, C12: 100nF; C_0805_2012Metric_Pad1.18x1.45mm_HandSolder
C3: 1u; C_0805_2012Metric_Pad1.18x1.45mm_HandSolder
C10: 0.33uF; C_0805_2012Metric_Pad1.18x1.45mm_HandSolder
C11: .33uF; C_0805_2012Metric_Pad1.18x1.45mm_HandSolder
C13, C14: 0.1uF; C_0805_2012Metric_Pad1.18x1.45mm_HandSolder
C18: 100nf; C_0805_2012Metric_Pad1.18x1.45mm_HandSolder
C23: 1uF; C_0805_2012Metric_Pad1.18x1.45mm_HandSolder
C24: 10uF; C_0805_2012Metric_Pad1.18x1.45mm_HandSolder
CR1, CR2, CR3, CR4, CR5, CR6: STS6NF20V; SOIC-8_3.9x4.9mm_P1.27mm
D2, D4, D5, D6, D7: D; D_2010_5025Metric_Pad1.52x2.65mm_HandSolder
D8: HPZR-C50X; Nexperia_CFP3_SOD-123W
J1: IMD; Molex_Nano-Fit_105309-xx03_1x03_P2.50mm_Vertical; PARTREV H
J2: Molex Nanofit 12pin; Molex_Nano-Fit_105310-xx12_2x06_P2.50mm_Vertical
J3: Temp Sensor; Molex_Nano-Fit_105309-xx03_1x03_P2.50mm_Vertical
J4: Current Sensor; Molex_Nano-Fit_105309-xx04_1x04_P2.50mm_Vertical; PARTREV H
J6: Shutdown IL; Molex_Nano-Fit_105309-xx02_1x02_P2.50mm_Vertical; PARTREV H
J7: AIRs Power; Molex_Nano-Fit_105309-xx04_1x04_P2.50mm_Vertical; PARTREV H
J8: Precharge Resistor; Molex_Nano-Fit_105309-xx02_1x02_P2.50mm_Vertical; PARTREV H
J9: TS+/TS-; Molex_Nano-Fit_105309-xx02_1x02_P2.50mm_Vertical
J10: HVIL; Molex_Nano-Fit_105309-xx02_1x02_P2.50mm_Vertical
J11: Molex Nanofit 16pin; Molex_Nano-Fit_105310-xx16_2x08_P2.50mm_Vertical
K1, K3: DK1A1B-12V; DK1A1B
K2: G5PZ-1A-X DC12
K4: G6BK-1114P-US; RELAY_G6BK-1114P-US_OMR
Q1, Q2: STS6NF20V; SOIC-8_3.9x4.9mm_P1.27mm
Q3: BSS308PE; SOT-23_Handsoldering
R1: 120; R_0805_2012Metric_Pad1.20x1.40mm_HandSolder
R2, R26, R29, R33, R34, R38: 10k; R_0805_2012Metric_Pad1.20x1.40mm_HandSolder
R3: 120k; R_0805_2012Metric_Pad1.20x1.40mm_HandSolder
R4: 200k; R_0805_2012Metric_Pad1.20x1.40mm_HandSolder
R5, R6: 400k; R_0805_2012Metric_Pad1.20x1.40mm_HandSolder
R7, R8: 100k; R_0805_2012Metric_Pad1.20x1.40mm_HandSolder
R9: 10K; R_0805_2012Metric_Pad1.20x1.40mm_HandSolder
R17: 22k; R_0805_2012Metric_Pad1.20x1.40mm_HandSolder
R18: 6.8K; R_0805_2012Metric_Pad1.20x1.40mm_HandSolder
R19, R22, R25, R28, R30, R31, R32: 1k; R_0805_2012Metric_Pad1.20x1.40mm_HandSolder
R20: 1.6k; R_0805_2012Metric_Pad1.20x1.40mm_HandSolder
R21: 560; R_0805_2012Metric_Pad1.20x1.40mm_HandSolder
R23: 10M; R_0805_2012Metric_Pad1.20x1.40mm_HandSolder
R24: 4.7k; R_0805_2012Metric_Pad1.20x1.40mm_HandSolder
R27, R39: 7.15k; R_0805_2012Metric_Pad1.20x1.40mm_HandSolder
R35: 3.9k; R_0805_2012Metric_Pad1.20x1.40mm_HandSolder
R36: 18k; R_0805_2012Metric_Pad1.20x1.40mm_HandSolder
R37: 100; R_0805_2012Metric_Pad1.20x1.40mm_HandSolder
TP3, TP4, TP5: TestPoint; TestPoint_Pad_D1.5mm
U1: ISO1050DUB; SOP-8_6.62x9.15mm_P2.54mm
U2: NUCLEO-L432KC; PARTREV N/A
U3: SN74LS279ADR; SOIC-16_3.9x9.9mm_P1.27mm
U5: MCP6004; SOIC-14_3.9x8.7mm_P1.27mm
U6: DS18B20U; MSOP-8_3x3mm_P0.65mm
U7: HEF4093B; SOIC-14_3.9x8.7mm_P1.27mm
U9: L7805CV; TO-220-3_Vertical
U10: MC7809CTG; TO-220-3_Vertical
U11: SN74HCS08DR; SOIC-14_3.9x8.7mm_P1.27mm
U12: SN74LVC1G17DBVR; SOT-23-5
U15: ZXTR2005ZQ-13; SOT-89_4P5X2P45_DIO
U16: MC14069UBDR2G; SOIC-14_3.9x8.7mm_P1.27mm

Connections:
+3.3V: C2.2, R24.1, U1.1 (VCC1), U2.CN4_14 (3V3); also elsewhere on the board
+5V: C1.2, C4.2, C9.2, C12.2, C14.1, C18.2, J3.3, J4.1, Q3.1 (G), R23.1, R29.1, U1.8 (VCC2), U3.16 (VCC), U5.4 (V+), U7.14 (VCC), U9.3 (OUT), U11.14 (VCC), U12.5 (VCC), U16.14 (VDD)
+9V: C13.1, U2.CN4_1 (VIN), U10.3 (VO)
+12V: C10.1, C11.1, D2.1 (K), D4.1 (K), D5.1 (K), J1.2, J11.1, K1.8 (+), K3.8 (+), K4.5, R33.1, R34.1, R36.2, U9.1 (IN), U10.1 (VI)
/ACC_Temp_Sense: J3.2, R24.2, U2.CN3_8 (PB6)
/Amp_Curr_Sensor: R3.1, R4.1, U2.CN4_10 (PA3)
/BMS_CS: U2.CN4_9 (PA4); also elsewhere on the board
/BMS_Dash_LED_Control: CR6.5 (D), CR6.6 (D), CR6.7 (D), CR6.8 (D), J2.1, R34.2
/BMS_FAULT_3.3V: R25.1, R30.2, U2.CN3_7 (PB7)
/BMS_FAULT_5V: CR4.5 (D), CR4.6 (D), CR4.7 (D), CR4.8 (D), J11.10, R29.2, U11.5
/BMS_Fault_Inverted: R22.2, R28.2, U2.CN4_6 (PA7)
/BMS_RL: CR3.5 (D), CR3.6 (D), CR3.7 (D), CR3.8 (D), D2.2 (A), K1.1 (-)
/BSPD_FAULT_5V: J2.4, U7.5
/CAN1_RD: U1.2 (RXD), U2.CN3_13 (PA11)
/CAN1_TD: U1.3 (TXD), U2.CN3_5 (PA12)
/CAN_H1: J11.3, J11.5, U1.7 (CANH)
/CAN_L1: J11.4, R1.2, U1.6 (CANL)
/CAN_L_RES1: J11.6, R1.1
/CLK: U2.CN4_15 (PB3); also elsewhere on the board
/Charge_State: J11.9, R2.2, U2.CN3_2 (PA10)
/Current_Vout: J2.9, R7.2, U5.8, U5.9 (-)
/Current_Vref: J2.8, R8.2, U5.6 (-), U5.7
/Fan_PWM: J11.7, U2.CN3_12 (PA8)
/GLV Voltage: R35.2, R36.1, U2.CN4_12 (PA0)
/HVIL: C24.1, J10.1, U15.3 (Vout)
/IMD_DELAY: R19.1, R31.2, U3.6 (~S), U7.10, U7.12, U11.4
/IMD_Dash_LED_Control: CR5.5 (D), CR5.6 (D), CR5.7 (D), CR5.8 (D), J2.3, R33.2
/IMD_Delay_Latch: R32.2, U3.7 (Q), U16.9
/IMD_FAULT_12V: J1.1, R20.2, R26.1
/IMD_RL: CR1.5 (D), CR1.6 (D), CR1.7 (D), CR1.8 (D), D4.2 (A), K3.1 (-)
/IMD_Status: R20.1, R21.2, U2.CN3_6 (PB0)
/IMD_TSSI_Control: J11.11, U16.8
/IR+_12V: D7.1 (K), J2.7, J7.2, J7.4, K2.1, R17.1
/IR+_GND: J7.1, J11.8, Q1.5 (D), Q1.6 (D), Q1.7 (D), Q1.8 (D)
/LATCH_RL: CR2.5 (D), CR2.6 (D), CR2.7 (D), CR2.8 (D), D5.2 (A), K4.2
/Latch_Gate_TP: CR2.4 (G), U7.4
/MISO: U2.CN3_15 (PB4); also elsewhere on the board
/MOSI: U2.CN3_14 (PB5); also elsewhere on the board
/Precharge_Control: Q1.4 (G), U2.CN3_9 (PB1), U16.5
/Raw_Curr_Out: J4.3, R9.1, U5.10 (+)
/Raw_Curr_VRef: J4.4, U5.5 (+)
/SH_RESET: D6.1 (K), J2.10, K4.6, R38.1
/Schmitt Output: U7.8, U11.1, U12.4
/Shutdown_ACC_BMS_TP: K1.4, K3.3, TP3.1
/Shutdown_ACC_IMD_TP: J6.1, K3.4, TP4.1
/Shutdown_ACC_In: J2.5, K1.3
/Shutdown_ACC_Out: J2.6, K4.3, TP5.1
/Shutdown_Measure: R17.2, R18.1, U2.CN4_5 (PA2)
/TS+: D8.1 (K), J9.1
/TS-: C23.2, C24.2, J9.2, J10.2, U15.1 (GND)
/TSSI_TP: U7.6, U11.6
/Temp_Sense_GND: J2.11, U6.4 (GND), U6.8 (V_{DD})
/Temp_Sense_One_Wire: J2.12, U6.1 (DQ)
GND: C1.1, C2.1, C3.1, C4.1, C9.1, C10.2, C11.2, C12.1, C13.2, C14.2, C18.1, CR1.1 (S), CR1.2 (S), CR1.3 (S), CR2.1 (S), CR2.2 (S), CR2.3 (S), CR3.1 (S), CR3.2 (S), CR3.3 (S), CR4.1 (S), CR4.2 (S), CR4.3 (S), CR5.1 (S), CR5.2 (S), CR5.3 (S), CR6.1 (S), CR6.2 (S), CR6.3 (S), D6.2 (A), J1.3, J3.1, J4.2, J7.3, J11.2, K4.1, Q1.1 (S), Q1.2 (S), Q1.3 (S), Q2.1 (S), Q2.2 (S), Q2.3 (S), R2.1, R3.2, R6.1, R9.2, R18.2, R19.2, R21.1, R25.2, R27.2, R35.1, R37.2, R39.2, U1.4 (GND1), U1.5 (GND2), U2.CN3_4 (GND), U2.CN4_2 (GND), U3.8 (GND), U5.11 (V-), U7.7 (GND), U9.2 (GND), U10.2 (GND), U11.7 (GND), U12.3 (GND), U16.7 (VSS); also elsewhere on the board
unnamed: CR1.4 (G), R31.1
unnamed: CR3.4 (G), R30.1
unnamed: CR4.4 (G), R28.1
unnamed: CR5.4 (G), R32.1
unnamed: CR6.4 (G), R22.1
unnamed: D7.2 (A), K2.4, Q2.5 (D), Q2.6 (D), Q2.7 (D), Q2.8 (D)
unnamed: C23.1, D8.2 (A), U15.2 (Vin)
unnamed: J6.2, K4.4
unnamed: J8.1, K2.2
unnamed: J8.2, K2.3
unnamed: Q2.4 (G), U16.6
unnamed: Q3.3 (D), R37.1
unnamed: C3.2, Q3.2 (S), R23.2, U12.2
unnamed: R4.2, R5.1, U5.1
unnamed: R26.2, R27.1, U16.3
unnamed: R38.2, R39.1, U7.13
unnamed: U3.5 (~R), U11.3
unnamed: R6.2, R7.1, U5.3 (+)
unnamed: R5.2, R8.1, U5.2 (-)
unnamed: U7.11, U11.2
unnamed: U7.9, U16.4

Notes on the sheet:
Energy Meter Temp Sense
SR Latch
Check polarity and annotate
--> BMS Relay
12V --> ~5V Input to LV Logic at 5V
Latch Trigger MOSFET
NAND GATE
GLV
Voltage Indicator
Double check where the Voltage Indicator will go out to
IsoSPI
ACC Onboard Shutdown
Hex Invertor
1 Turns on Light 0 Turns off Light when SH_Reset is hit
3.3V
--> IMD Relay
Power Block
AIR power from shutdown circuit; inside acc
When BMS Fault 3.3V is low BMS_Fault_5V is low
Upstream delay of ~11sec durring power on
BMS Fault Low --> 5V Relay
CAN Transciever
LEDS
On fault condition triggers TSSI light
IMD Fault Low 3.3V --> 5V Relay
IMD Relay
Auxillary Connector
Schmitt Trigger, Delay before turn on ~4secs worst case
IMD_Delay and BMS Fault_5V to be used to drive TSSI logic
Precharge Circuit
Shutdown interlock (BFC), inside ACC
SPST Latching Relay
BMS Relay
Microcontroller
For DS18B20 one wire temp sensors For acc air temperature sensing
0V or 8-12V
Goes to IMD; inside ACC
0V or 2-3.3V
AND GATE
HPZR-C50-QX
