formulaslug/fs-3-schematics/Accumulator_Board/Accumulator_Board.kicad_pcb

## KiCad design Accumulator_Board/Accumulator_Board.kicad_pcb (continued)

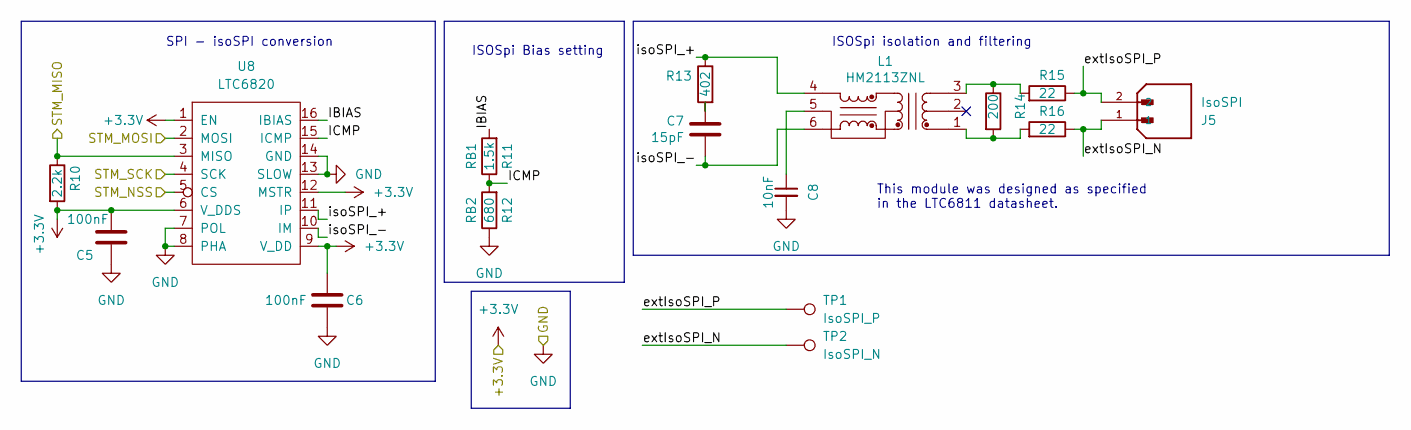
[picture p35: schematic isoSPI.kicad_sch]

Parts:
C5, C6: 100nF; C_0805_2012Metric_Pad1.18x1.45mm_HandSolder
C7: 15pF; C_0805_2012Metric_Pad1.18x1.45mm_HandSolder
C8: 10nF; C_0805_2012Metric_Pad1.18x1.45mm_HandSolder
J5: IsoSPI; Molex_Nano-Fit_105309-xx02_1x02_P2.50mm_Vertical; PARTREV H
L1: HM2113ZNL; HM2113ZNLT
R10: 2.2k; R_0805_2012Metric_Pad1.20x1.40mm_HandSolder
R11: 1.5k; R_0805_2012Metric_Pad1.20x1.40mm_HandSolder
R12: 680; R_0805_2012Metric_Pad1.20x1.40mm_HandSolder
R13: 402; R_0805_2012Metric_Pad1.20x1.40mm_HandSolder
R14: 200; R_0805_2012Metric_Pad1.20x1.40mm_HandSolder
R15, R16: 22; R_0805_2012Metric_Pad1.20x1.40mm_HandSolder
TP1: IsoSPI_P; TestPoint_Loop_D2.50mm_Drill1.0mm
TP2: IsoSPI_N; TestPoint_Loop_D2.50mm_Drill1.0mm
U8: LTC6820; MSOP-16_3x4.039mm_P0.5mm

Connections:
+3.3V: C5.1, C6.1, R10.2, U8.1 (EN), U8.6 (V_DDS), U8.9 (V_DD), U8.12 (MSTR); also elsewhere on the board
/BMS_CS: U8.5 (CS); also elsewhere on the board
/CLK: U8.4 (SCK); also elsewhere on the board
/Iso SPI/IBIAS: R11.2, U8.16 (IBIAS)
/Iso SPI/ICMP: R11.1, R12.2, U8.15 (ICMP)
/Iso SPI/extIsoSPI_N: J5.1, R16.1, TP2.1
/Iso SPI/extIsoSPI_P: J5.2, R15.1, TP1.1
/Iso SPI/isoSPI_+: L1.4, R13.1, U8.11 (IP)
/Iso SPI/isoSPI_-: C7.1, L1.6, U8.10 (IM)
/MISO: R10.1, U8.3 (MISO); also elsewhere on the board
/MOSI: U8.2 (MOSI); also elsewhere on the board
GND: C5.2, C6.2, C8.2, R12.1, U8.7 (POL), U8.8 (PHA), U8.13 (SLOW), U8.14 (GND); also elsewhere on the board
unnamed: C7.2, R13.2
unnamed: C8.1, L1.5
unnamed: L1.1, R14.2, R16.2
unnamed: L1.3, R14.1, R15.2

Notes on the sheet:
This module was designed as specified in the LTC6811 datasheet.
ISOSpi Bias setting
SPI - isoSPI conversion
ISOSpi isolation and filtering

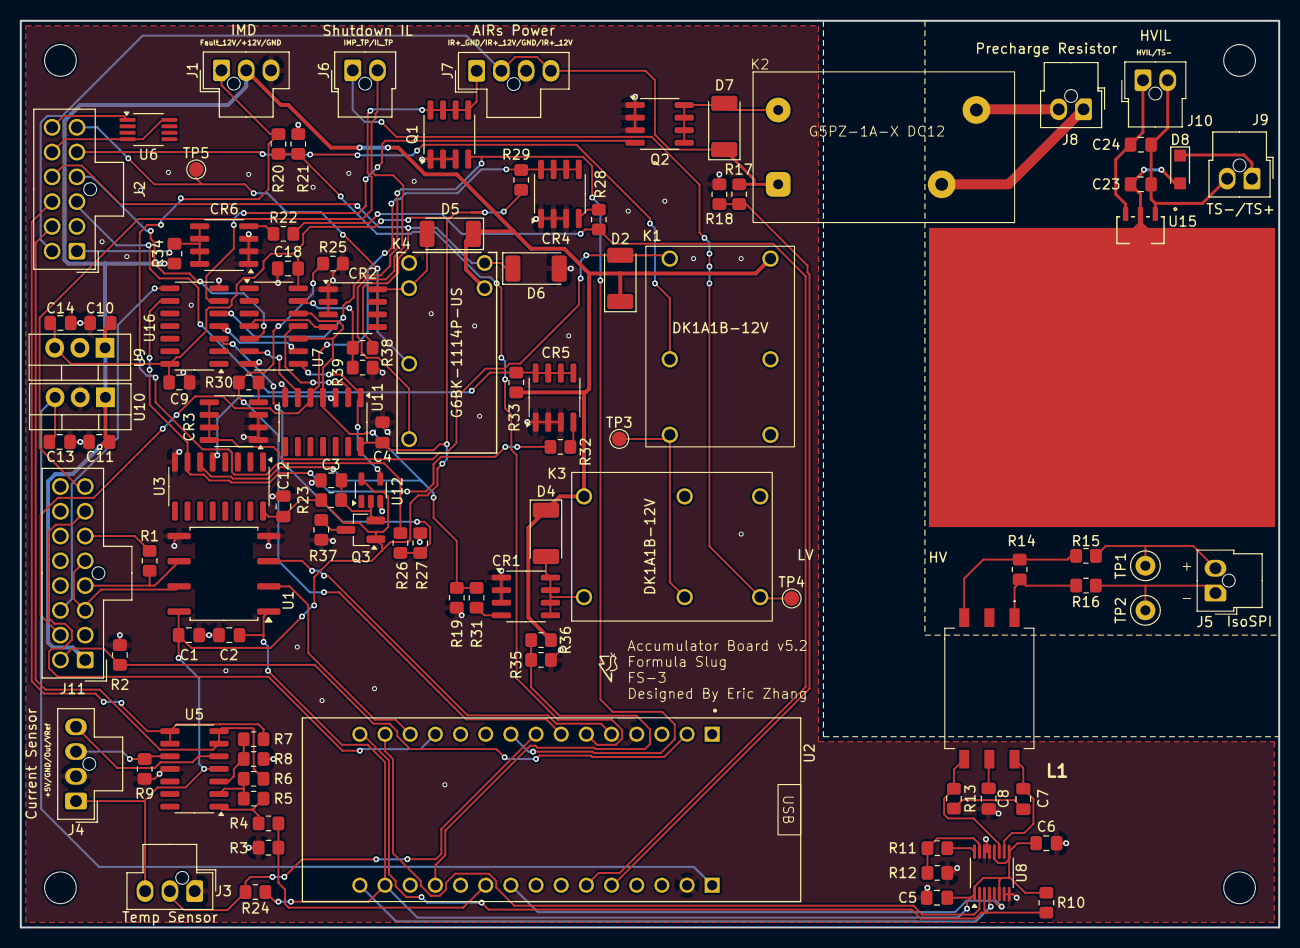
[picture p36: board Accumulator_Board.kicad_pcb from above]

Board: 2 copper layers, 127.0 x 91.5 mm, 105 parts (0 on the bottom side), 85 nets.
