formulaslug/fs-3-schematics/charger_shutdownboard/charger_shutdownboard.kicad_pcb

## KiCad design charger_shutdownboard/charger_shutdownboard.kicad_pcb (2025-05-04)

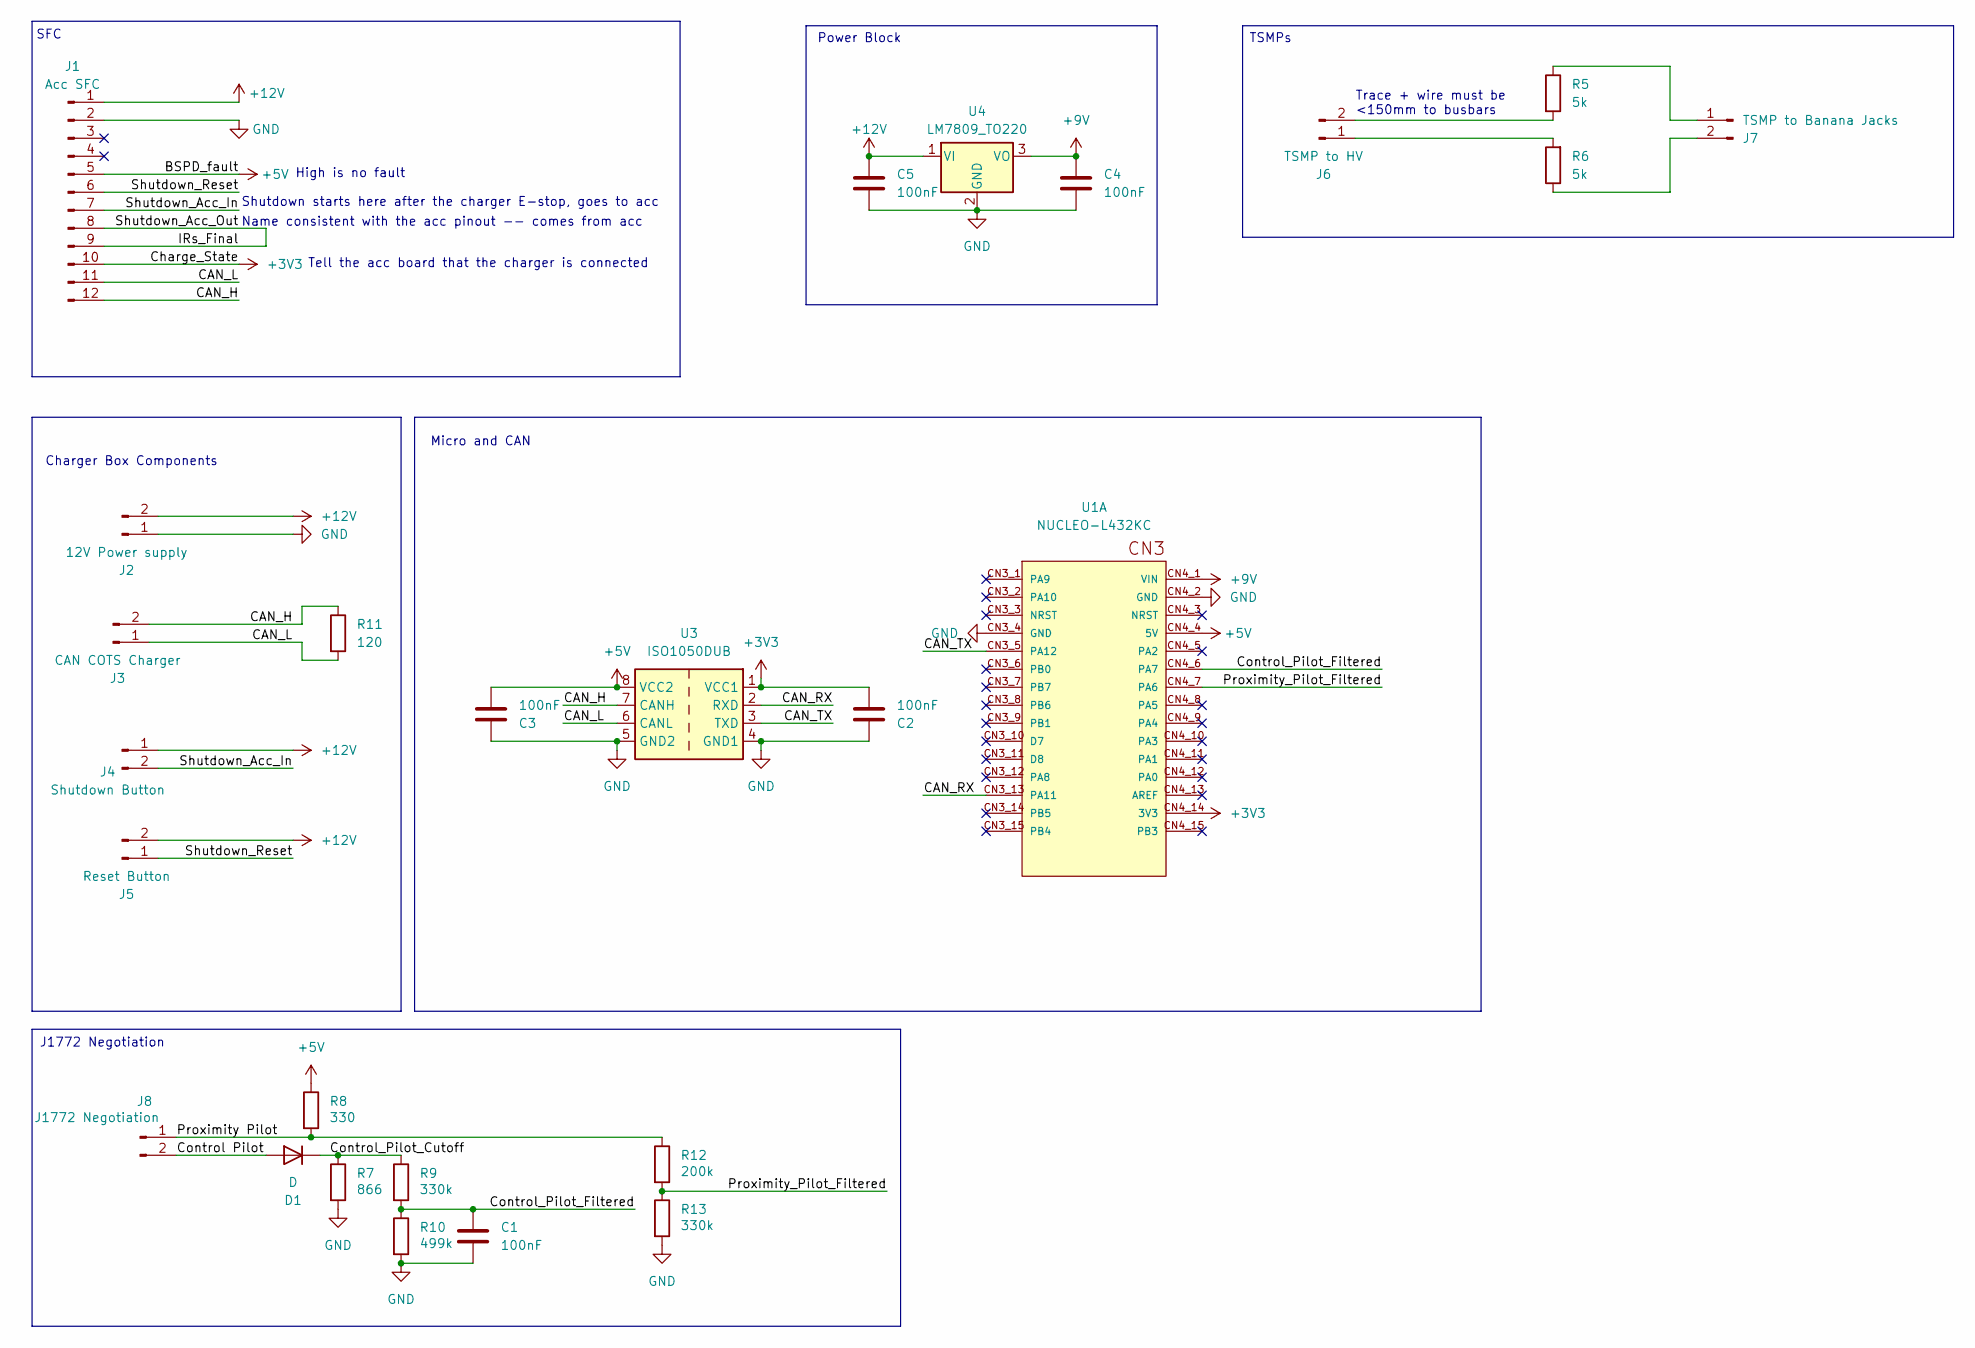
[picture p37: schematic charger_shutdownboard.kicad_sch, FS-3 Charger Board]

Parts:
C1, C2, C3, C4, C5: 100nF; C_0805_2012Metric_Pad1.18x1.45mm_HandSolder
D1: D; D_0805_2012Metric_Pad1.15x1.40mm_HandSolder
J1: Acc SFC; Molex_Nano-Fit_105310-xx12_2x06_P2.50mm_Vertical
J2: 12V Power supply; Molex_Nano-Fit_105309-xx02_1x02_P2.50mm_Vertical
J3: CAN COTS Charger; Molex_Nano-Fit_105309-xx02_1x02_P2.50mm_Vertical
J4: Shutdown Button; Molex_Nano-Fit_105309-xx02_1x02_P2.50mm_Vertical
J5: Reset Button; Molex_Nano-Fit_105309-xx02_1x02_P2.50mm_Vertical
J6: TSMP to HV; Molex_Nano-Fit_105309-xx02_1x02_P2.50mm_Vertical
J7: TSMP to Banana Jacks; Molex_Nano-Fit_105309-xx02_1x02_P2.50mm_Vertical
J8: J1772 Negotiation; Molex_Nano-Fit_105309-xx02_1x02_P2.50mm_Vertical
R5, R6: 5k; R_Axial_DIN0922_L20.0mm_D9.0mm_P25.40mm_Horizontal
R7: 866; R_0805_2012Metric_Pad1.20x1.40mm_HandSolder
R8: 330; R_0805_2012Metric_Pad1.20x1.40mm_HandSolder
R9, R13: 330k; R_0805_2012Metric_Pad1.20x1.40mm_HandSolder
R10: 499k; R_0805_2012Metric_Pad1.20x1.40mm_HandSolder
R11: 120; R_0805_2012Metric_Pad1.20x1.40mm_HandSolder
R12: 200k; R_0805_2012Metric_Pad1.20x1.40mm_HandSolder
U1: NUCLEO-L432KC; PARTREV N/A
U3: ISO1050DUB; SOP-8_6.62x9.15mm_P2.54mm
U4: LM7809_TO220; TO-220-3_Vertical

Connections:
+3V3: C2.2, J1.10, U1.CN4_14 (3V3), U3.1 (VCC1)
+5V: C3.2, J1.5, R8.1, U1.CN4_4 (5V), U3.8 (VCC2)
+9V: C4.1, U1.CN4_1 (VIN), U4.3 (VO)
+12V: C5.1, J1.1, J2.2, J4.1, J5.2, U4.1 (VI)
/CAN_H: J1.12, J3.2, R11.1, U3.7 (CANH)
/CAN_L: J1.11, J3.1, R11.2, U3.6 (CANL)
/CAN_RX: U1.CN3_13 (PA11), U3.2 (RXD)
/CAN_TX: U1.CN3_5 (PA12), U3.3 (TXD)
/Control Pilot: D1.2 (A), J8.2
/Control_Pilot_Cutoff: D1.1 (K), R7.1, R9.1
/Control_Pilot_Filtered: C1.1, R9.2, R10.1, U1.CN4_6 (PA7)
/IRs_Final: J1.8, J1.9
/Proximity Pilot: J8.1, R8.2, R12.1
/Proximity_Pilot_Filtered: R12.2, R13.1, U1.CN4_7 (PA6)
/Shutdown_Acc_In: J1.7, J4.2
/Shutdown_Reset: J1.6, J5.1
GND: C1.2, C2.1, C3.1, C4.2, C5.2, J1.2, J2.1, R7.2, R10.2, R13.2, U1.CN3_4 (GND), U1.CN4_2 (GND), U3.4 (GND1), U3.5 (GND2), U4.2 (GND)
unnamed: J6.1, R6.2
unnamed: J6.2, R5.2
unnamed: J7.1, R5.1
unnamed: J7.2, R6.1

Notes on the sheet:
Charger Box Components
Shutdown starts here after the charger E-stop, goes to acc
Name consistent with the acc pinout -- comes from acc
J1772 Negotiation
Trace + wire must be <150mm to busbars
High is no fault
Power Block
Tell the acc board that the charger is connected
TSMPs
Micro and CAN
SFC

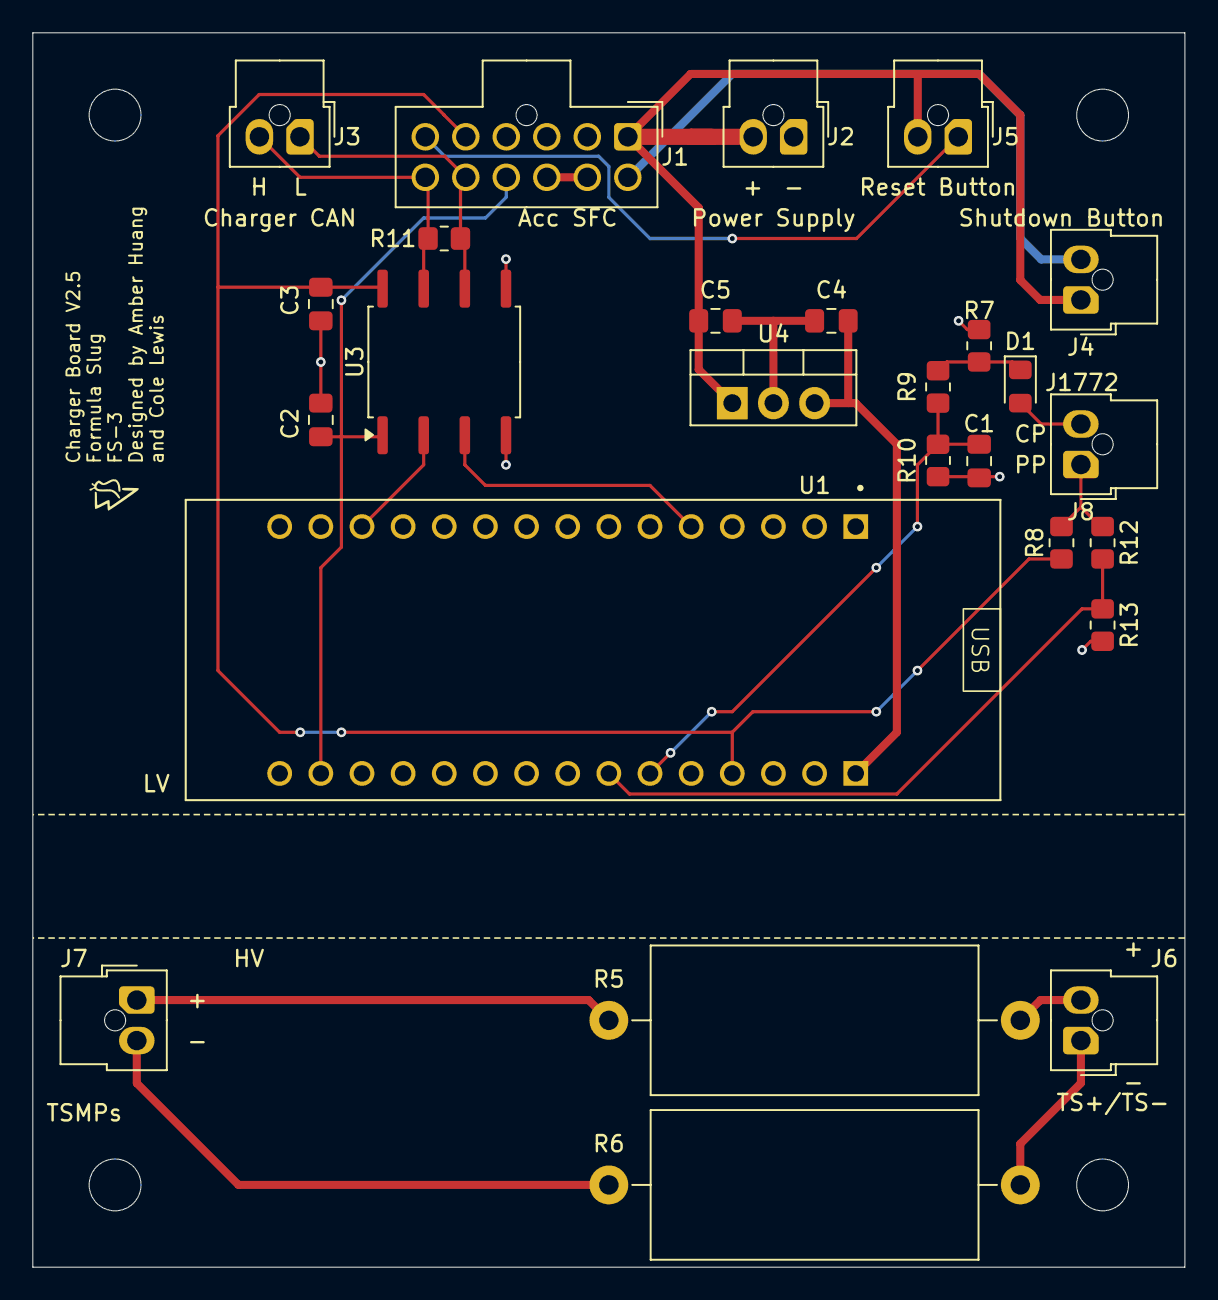
[picture p38: board charger_shutdownboard.kicad_pcb from above]

Board: 2 copper layers, 71.1 x 76.2 mm, 26 parts (0 on the bottom side), 21 nets.
