formulaslug/fs-3-schematics/BSPD/BSPD.kicad_pcb

## KiCad design BSPD/BSPD.kicad_pcb (2025-05-03)

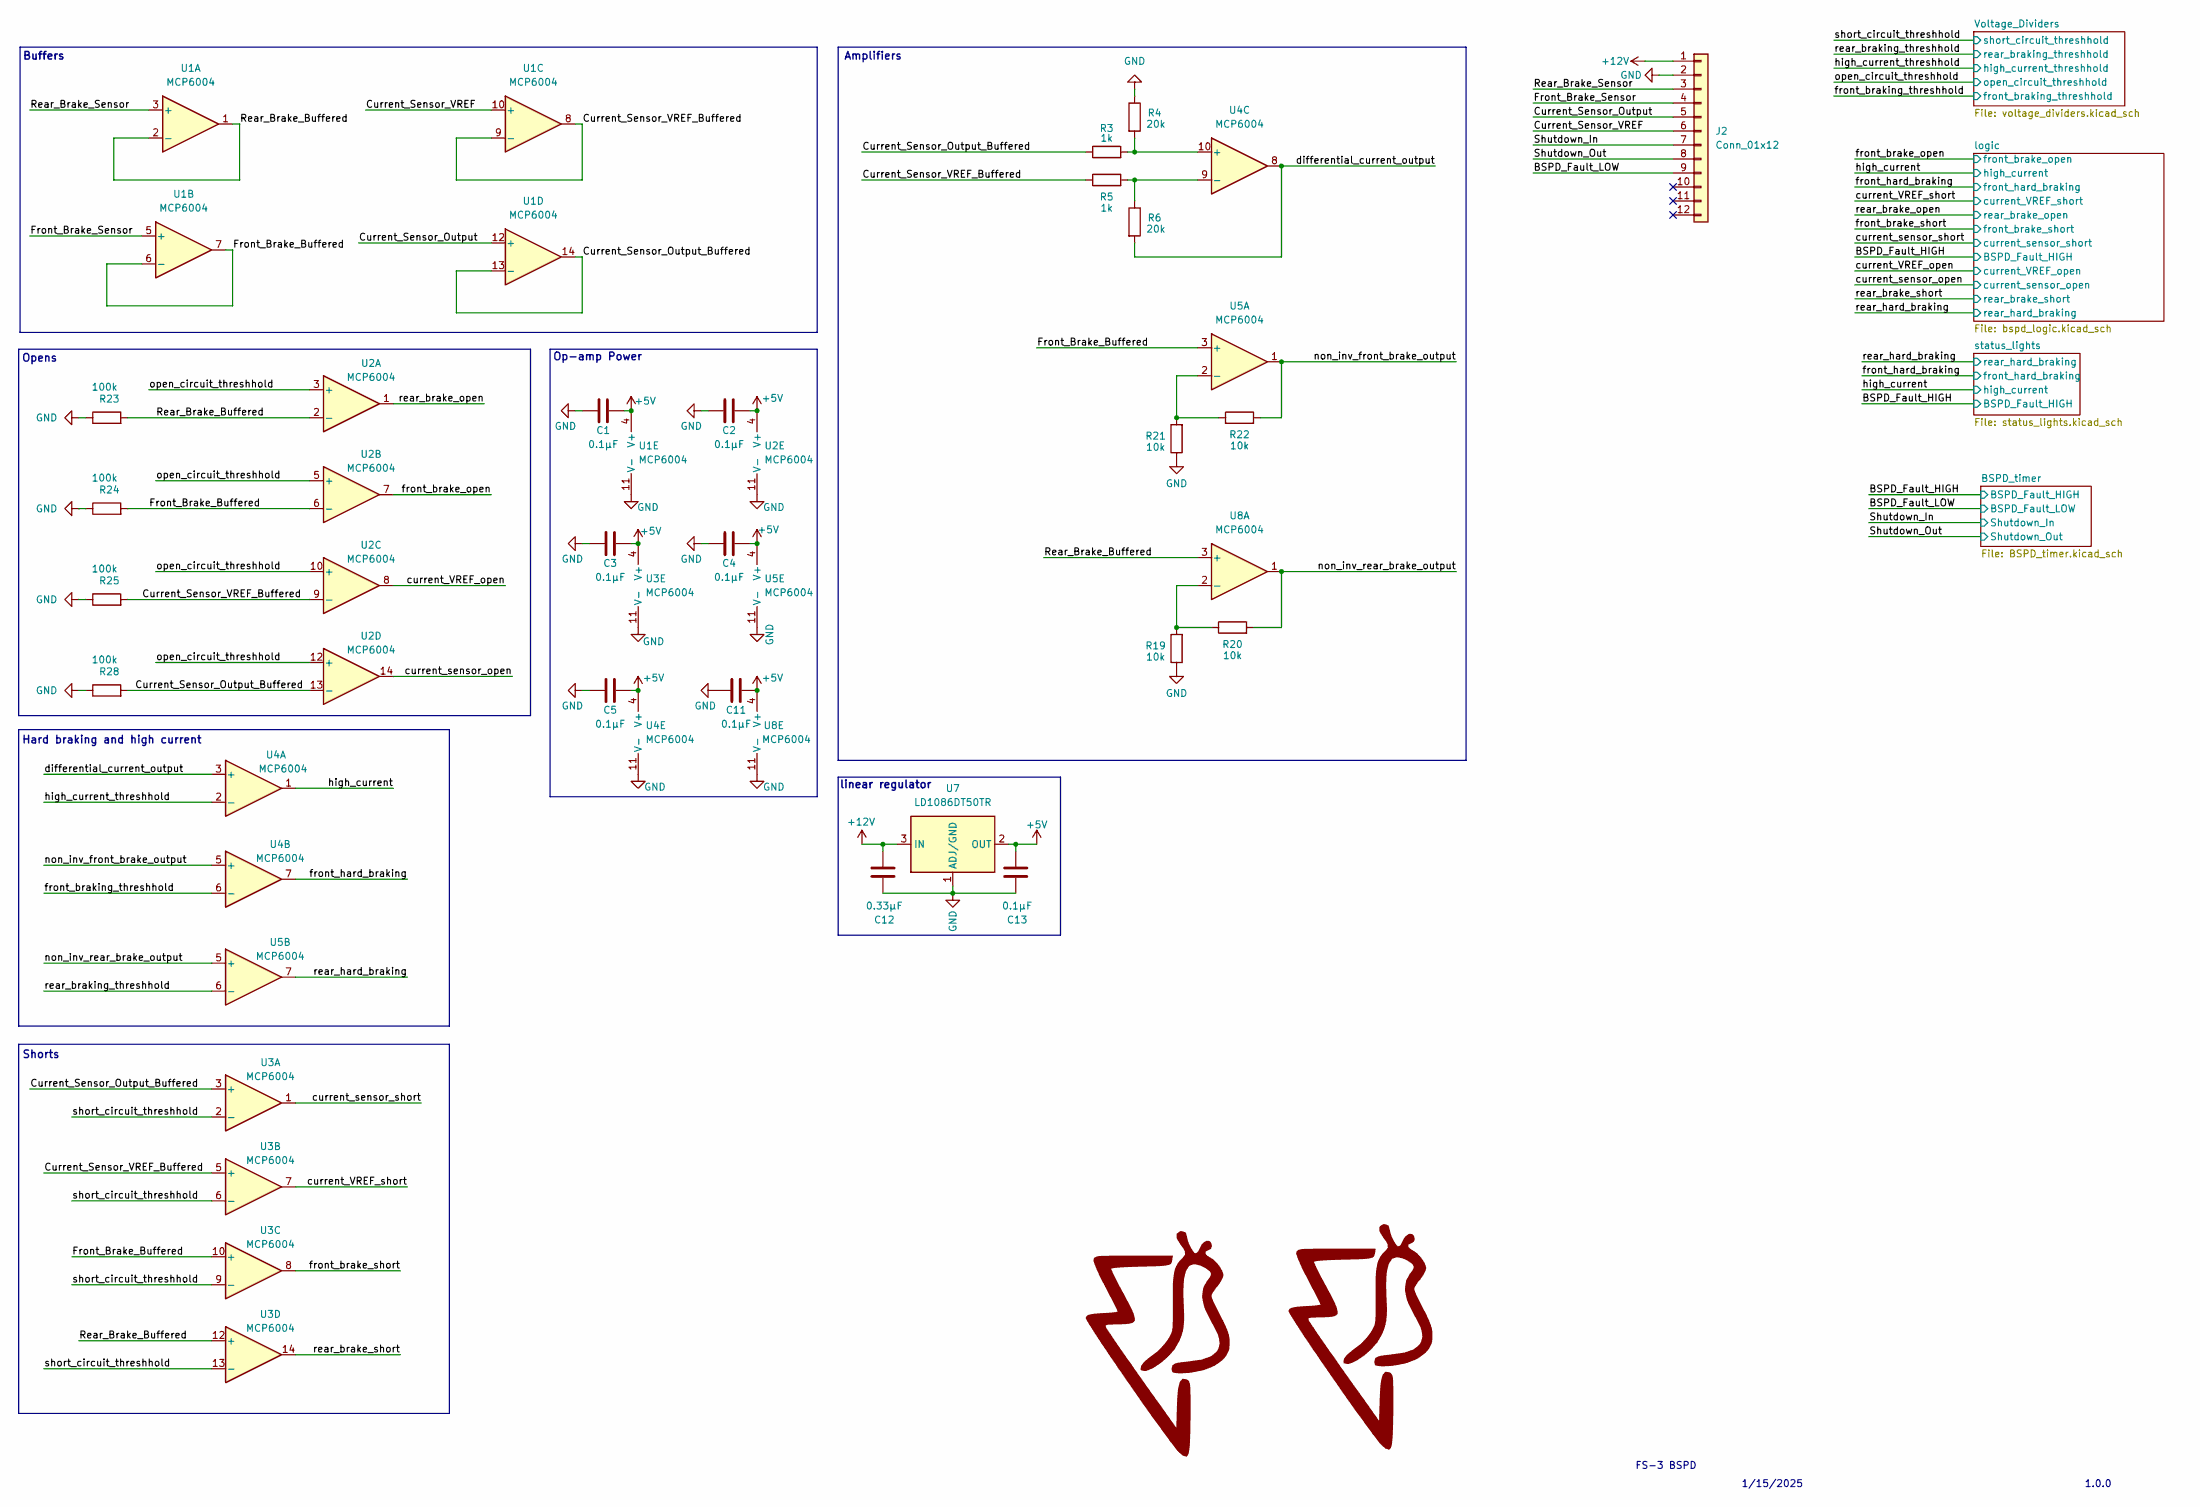
[picture p40: schematic BSPD.kicad_sch]

Parts:
C1, C2, C3, C4, C5, C11: 0.1μF; C_0805_2012Metric_Pad1.18x1.45mm_HandSolder; Part Name Capacitor
C12: 0.33µF; C_0805_2012Metric_Pad1.18x1.45mm_HandSolder; Part Name Capacitor
C13: 0.1µF; C_0805_2012Metric_Pad1.18x1.45mm_HandSolder; Part Name Capacitor
J2: Conn_01x12; Molex_Nano-Fit_105310-xx12_2x06_P2.50mm_Vertical; Part Name Connector
R3, R5: 1k; R_0805_2012Metric_Pad1.20x1.40mm_HandSolder; Part Name Resistor
R4, R6: 20k; R_0805_2012Metric_Pad1.20x1.40mm_HandSolder; Part Name Resistor
R19, R20, R21, R22: 10k; R_0805_2012Metric_Pad1.20x1.40mm_HandSolder; Part Name Resistor
R23, R24, R25, R28: 100k; R_0805_2012Metric_Pad1.20x1.40mm_HandSolder; Part Name Resistor
U1, U2, U3, U4, U5, U8: MCP6004; SOIC-14_3.9x8.7mm_P1.27mm; Part Name OPAMP
U7: LD1086DT50TR; TO-252-2; Part Name Linear Regulator

Connections:
+5V: C1.2, C2.2, C3.2, C4.2, C5.2, C11.2, C13.2, U1.4 (V+), U2.4 (V+), U3.4 (V+), U4.4 (V+), U5.4 (V+), U7.2 (OUT), U8.4 (V+); also elsewhere on the board
+12V: C12.2, J2.1, U7.3 (IN); also elsewhere on the board
/BSPD_Fault_LOW: J2.9; also elsewhere on the board
/Current_Sensor_Output: J2.5, U1.12 (+)
/Current_Sensor_Output_Buffered: R3.1, R28.2, U1.13 (-), U1.14, U2.13 (-), U3.3 (+)
/Current_Sensor_VREF: J2.6, U1.10 (+)
/Current_Sensor_VREF_Buffered: R5.1, R25.2, U1.8, U1.9 (-), U2.9 (-), U3.5 (+)
/Front_Brake_Buffered: R24.2, U1.6 (-), U1.7, U2.6 (-), U3.10 (+), U5.3 (+)
/Front_Brake_Sensor: J2.4, U1.5 (+)
/Rear_Brake_Buffered: R23.2, U1.1, U1.2 (-), U2.2 (-), U3.12 (+), U8.3 (+)
/Rear_Brake_Sensor: J2.3, U1.3 (+)
/Shutdown_In: J2.7; also elsewhere on the board
/Shutdown_Out: J2.8; also elsewhere on the board
/current_VREF_open: U2.8; also elsewhere on the board
/current_VREF_short: U3.7; also elsewhere on the board
/current_sensor_open: U2.14; also elsewhere on the board
/current_sensor_short: U3.1; also elsewhere on the board
/differential_current_output: R6.2, U4.3 (+), U4.8
/front_brake_open: U2.7; also elsewhere on the board
/front_brake_short: U3.8; also elsewhere on the board
/front_braking_threshhold: U4.6 (-); also elsewhere on the board
/front_hard_braking: U4.7; also elsewhere on the board
/high_current: U4.1; also elsewhere on the board
/high_current_threshhold: U4.2 (-); also elsewhere on the board
/non_inv_front_brake_output: R22.2, U4.5 (+), U5.1
/non_inv_rear_brake_output: R20.2, U5.5 (+), U8.1
/open_circuit_threshhold: U2.3 (+), U2.5 (+), U2.10 (+), U2.12 (+); also elsewhere on the board
/rear_brake_open: U2.1; also elsewhere on the board
/rear_brake_short: U3.14; also elsewhere on the board
/rear_braking_threshhold: U5.6 (-); also elsewhere on the board
/rear_hard_braking: U5.7; also elsewhere on the board
/short_circuit_threshhold: U3.2 (-), U3.6 (-), U3.9 (-), U3.13 (-); also elsewhere on the board
GND: C1.1, C2.1, C3.1, C4.1, C5.1, C11.1, C12.1, C13.1, J2.2, R4.1, R19.1, R21.1, R23.1, R24.1, R25.1, R28.1, U1.11 (V-), U2.11 (V-), U3.11 (V-), U4.11 (V-), U5.11 (V-), U7.1 (ADJ/GND), U8.11 (V-); also elsewhere on the board
unnamed: R3.2, R4.2, U4.10 (+)
unnamed: R5.2, R6.1, U4.9 (-)
unnamed: R21.2, R22.1, U5.2 (-)
unnamed: R19.2, R20.1, U8.2 (-)

Notes on the sheet:
FS-3 BSPD
Opens
Buffers
Hard braking and high current
1.0.0
linear regulator
Amplifiers
Shorts
Op-amp Power
1/15/2025

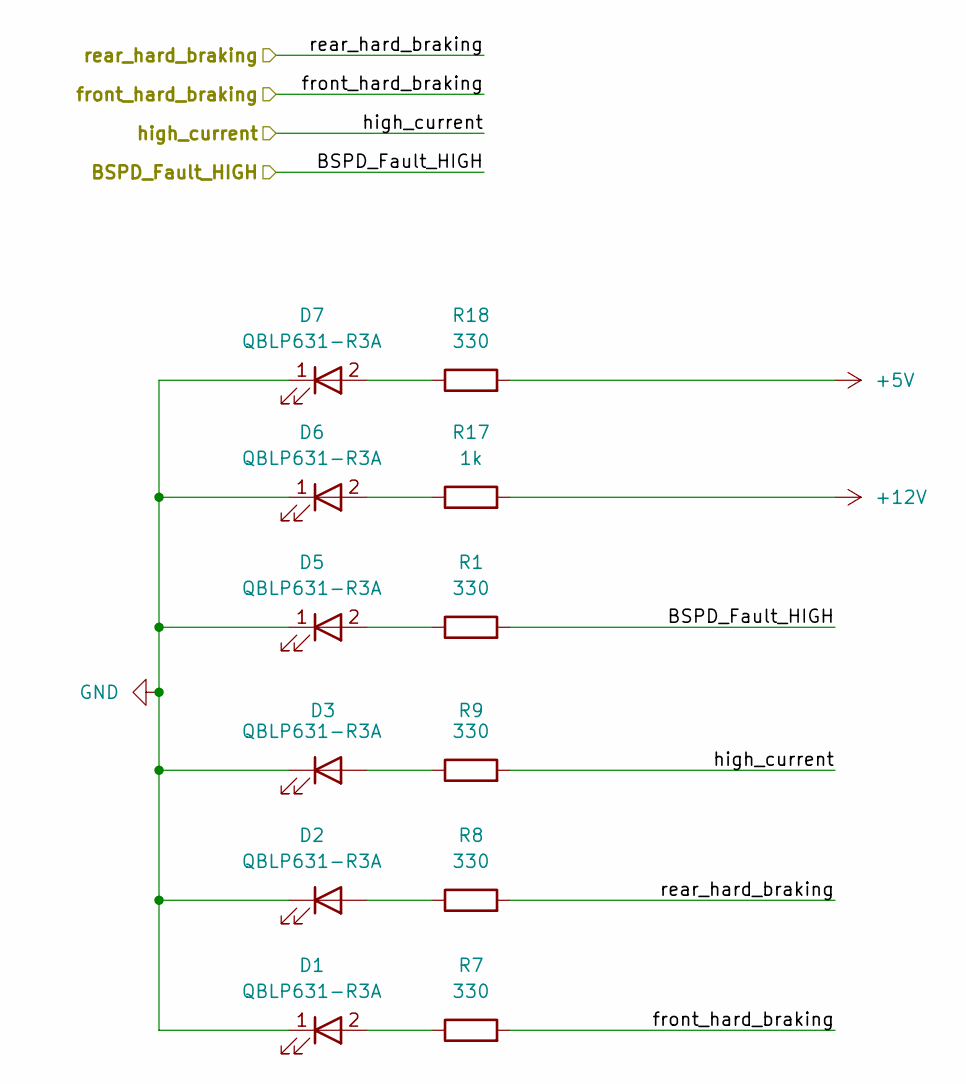
[picture p41: schematic status_lights.kicad_sch]

Parts:
D1, D2, D3, D5, D6, D7: QBLP631-R3A; LED_0805_2012Metric_Pad1.15x1.40mm_HandSolder; Part Name Leds
R1, R7, R8, R9, R18: 330; R_0805_2012Metric_Pad1.20x1.40mm_HandSolder; Part Name Resistor
R17: 1k; R_0805_2012Metric_Pad1.20x1.40mm_HandSolder; Part Name Resistor

Connections:
+5V: R18.2; also elsewhere on the board
+12V: R17.2; also elsewhere on the board
/BSPD_Fault_HIGH: R1.2; also elsewhere on the board
/front_hard_braking: R7.2; also elsewhere on the board
/high_current: R9.2; also elsewhere on the board
/rear_hard_braking: R8.2; also elsewhere on the board
GND: D1.1 (K), D2.1 (K), D3.1 (K), D5.1 (K), D6.1 (K), D7.1 (K); also elsewhere on the board
unnamed: D1.2 (A), R7.1
unnamed: D2.2 (A), R8.1
unnamed: D3.2 (A), R9.1
unnamed: D5.2 (A), R1.1
unnamed: D6.2 (A), R17.1
unnamed: D7.2 (A), R18.1

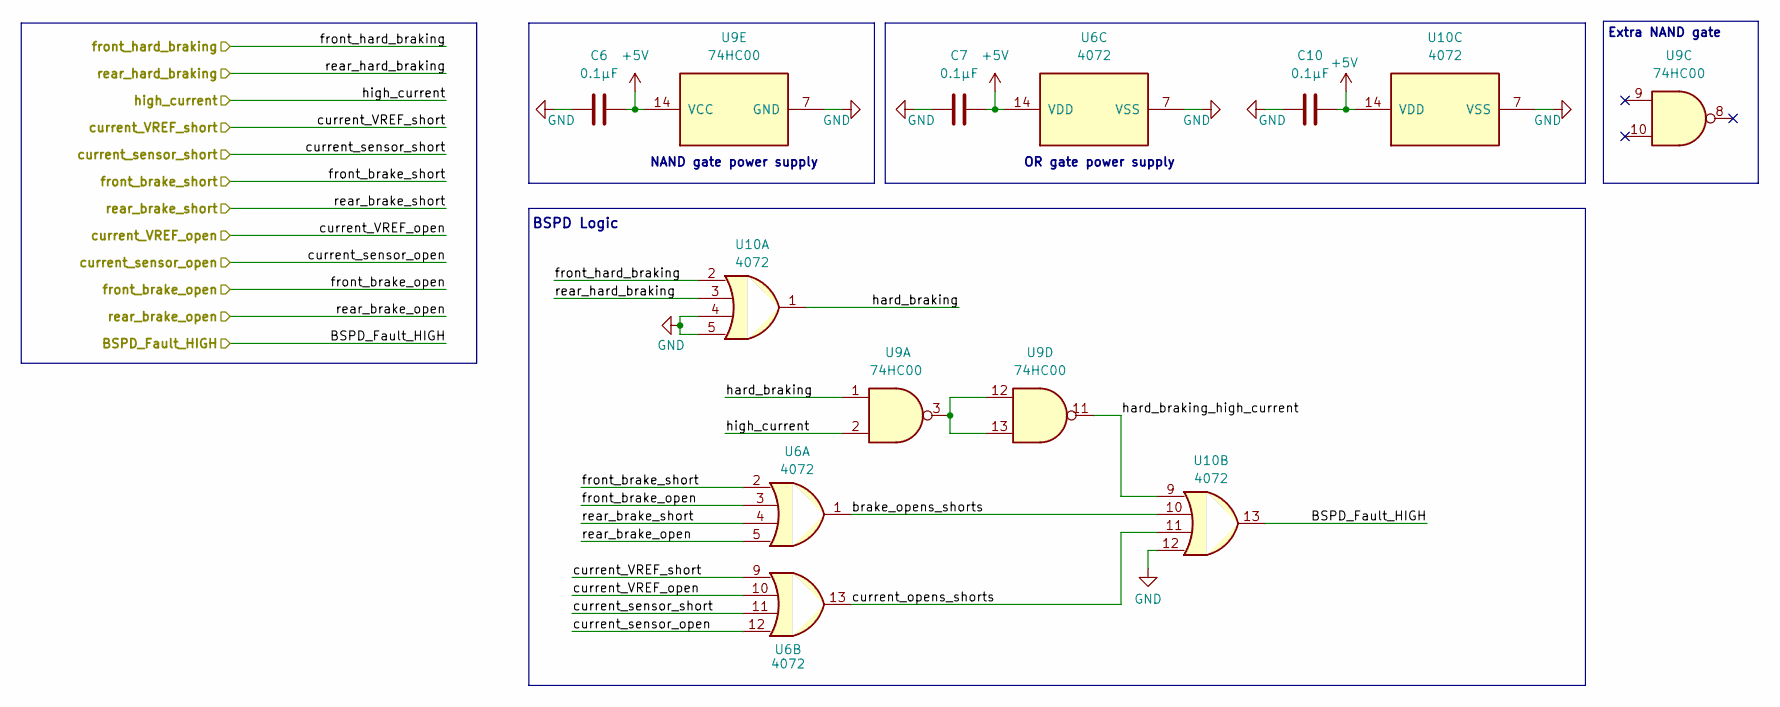
[picture p42: schematic bspd_logic.kicad_sch]

Parts:
C6, C7, C10: 0.1μF; C_0805_2012Metric_Pad1.18x1.45mm_HandSolder; Part Name Capacitor
U6, U10: 4072; SOIC-14_3.9x8.7mm_P1.27mm; Part Name OR Gate
U9: 74HC00; SOIC-14_3.9x8.7mm_P1.27mm; Part Name NAND Gate

Connections:
+5V: C6.2, C7.2, C10.2, U6.14 (VDD), U9.14 (VCC), U10.14 (VDD); also elsewhere on the board
/BSPD_Fault_HIGH: U10.13; also elsewhere on the board
/current_VREF_open: U6.10; also elsewhere on the board
/current_VREF_short: U6.9; also elsewhere on the board
/current_sensor_open: U6.12; also elsewhere on the board
/current_sensor_short: U6.11; also elsewhere on the board
/front_brake_open: U6.3; also elsewhere on the board
/front_brake_short: U6.2; also elsewhere on the board
/front_hard_braking: U10.2; also elsewhere on the board
/high_current: U9.2; also elsewhere on the board
/logic/brake_opens_shorts: U6.1, U10.10
/logic/current_opens_shorts: U6.13, U10.11
/logic/hard_braking: U9.1, U10.1
/logic/hard_braking_high_current: U9.11, U10.9
/rear_brake_open: U6.5; also elsewhere on the board
/rear_brake_short: U6.4; also elsewhere on the board
/rear_hard_braking: U10.3; also elsewhere on the board
GND: C6.1, C7.1, C10.1, U6.7 (VSS), U9.7 (GND), U10.4, U10.5, U10.7 (VSS), U10.12; also elsewhere on the board
unnamed: U9.3, U9.12, U9.13

Notes on the sheet:
BSPD Logic
Extra NAND gate
OR gate power supply
NAND gate power supply
