formulaslug/fs-3-schematics/BSPD/BSPD.kicad_pcb

## KiCad design BSPD/BSPD.kicad_pcb (continued)

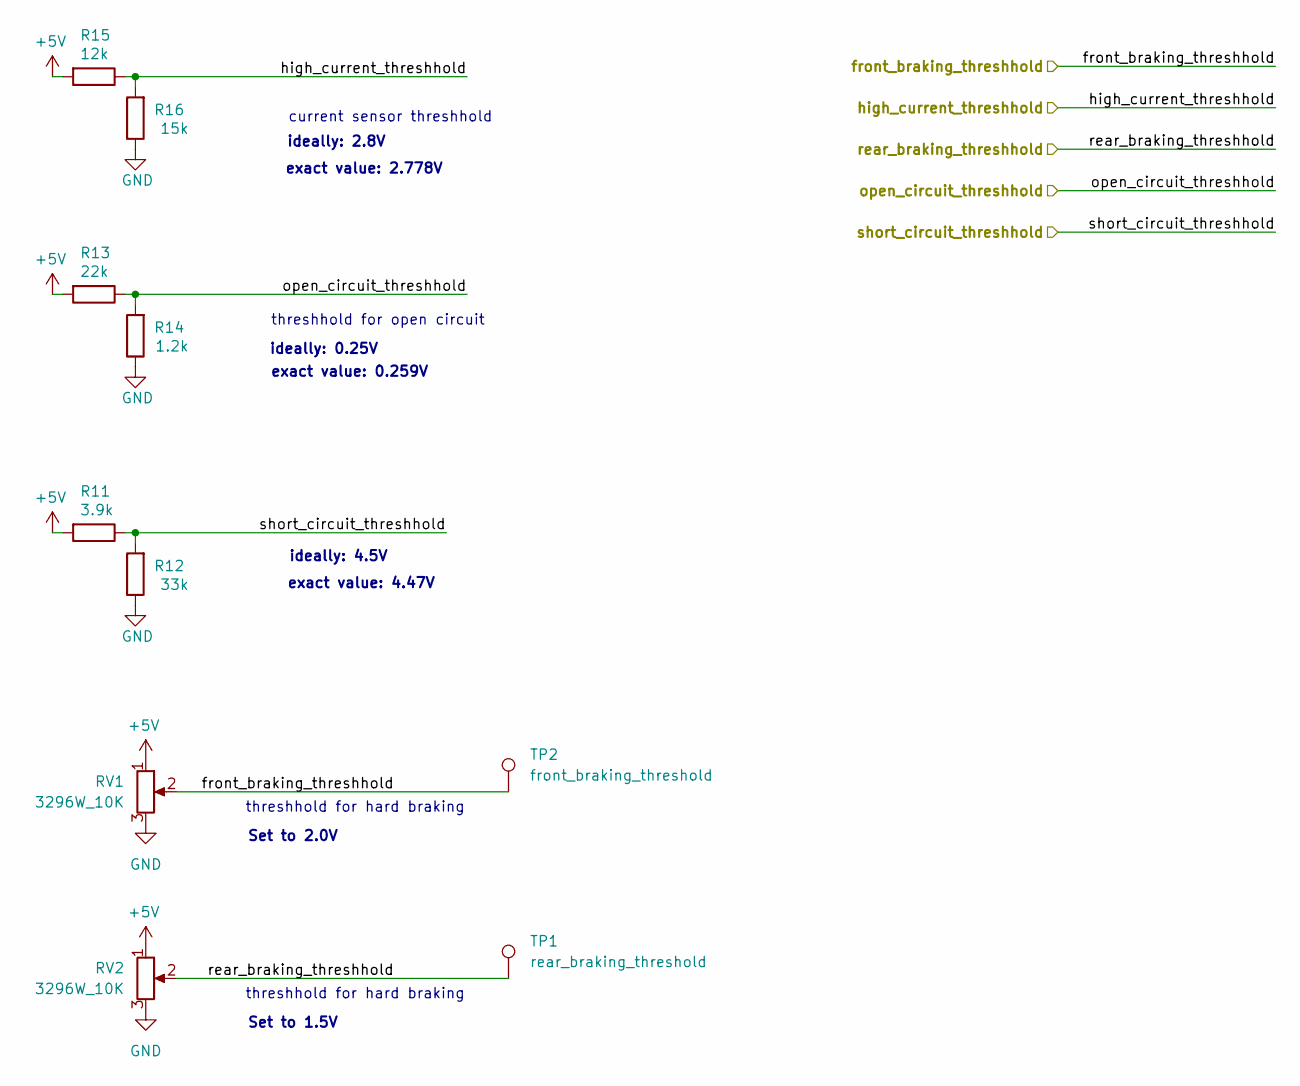
[picture p43: schematic voltage_dividers.kicad_sch]

Parts:
R11: 3.9k; R_0805_2012Metric_Pad1.20x1.40mm_HandSolder
R12: 33k; R_0805_2012Metric_Pad1.20x1.40mm_HandSolder
R13: 22k; R_0805_2012Metric_Pad1.20x1.40mm_HandSolder
R14: 1.2k; R_0805_2012Metric_Pad1.20x1.40mm_HandSolder
R15: 12k; R_0805_2012Metric_Pad1.20x1.40mm_HandSolder
R16: 15k; R_0805_2012Metric_Pad1.20x1.40mm_HandSolder
RV1, RV2: 3296W_10K; Potentiometer_Bourns_3296W_Vertical; Part Name Potentiometer
TP1: rear_braking_threshold; PinHeader_1x01_P2.54mm_Vertical
TP2: front_braking_threshold; PinHeader_1x01_P2.54mm_Vertical

Connections:
+5V: R11.2, R13.2, R15.2, RV1.1, RV2.1; also elsewhere on the board
/front_braking_threshhold: RV1.2, TP2.1; also elsewhere on the board
/high_current_threshhold: R15.1, R16.2; also elsewhere on the board
/open_circuit_threshhold: R13.1, R14.2; also elsewhere on the board
/rear_braking_threshhold: RV2.2, TP1.1; also elsewhere on the board
/short_circuit_threshhold: R11.1, R12.2; also elsewhere on the board
GND: R12.1, R14.1, R16.1, RV1.3, RV2.3; also elsewhere on the board

Notes on the sheet:
exact value: 2.778V
threshhold for hard braking
ideally: 4.5V
threshhold for open circuit
ideally: 0.25V
exact value: 0.259V
Set to 1.5V
current sensor threshhold
ideally: 2.8V
Set to 2.0V
exact value: 4.47V

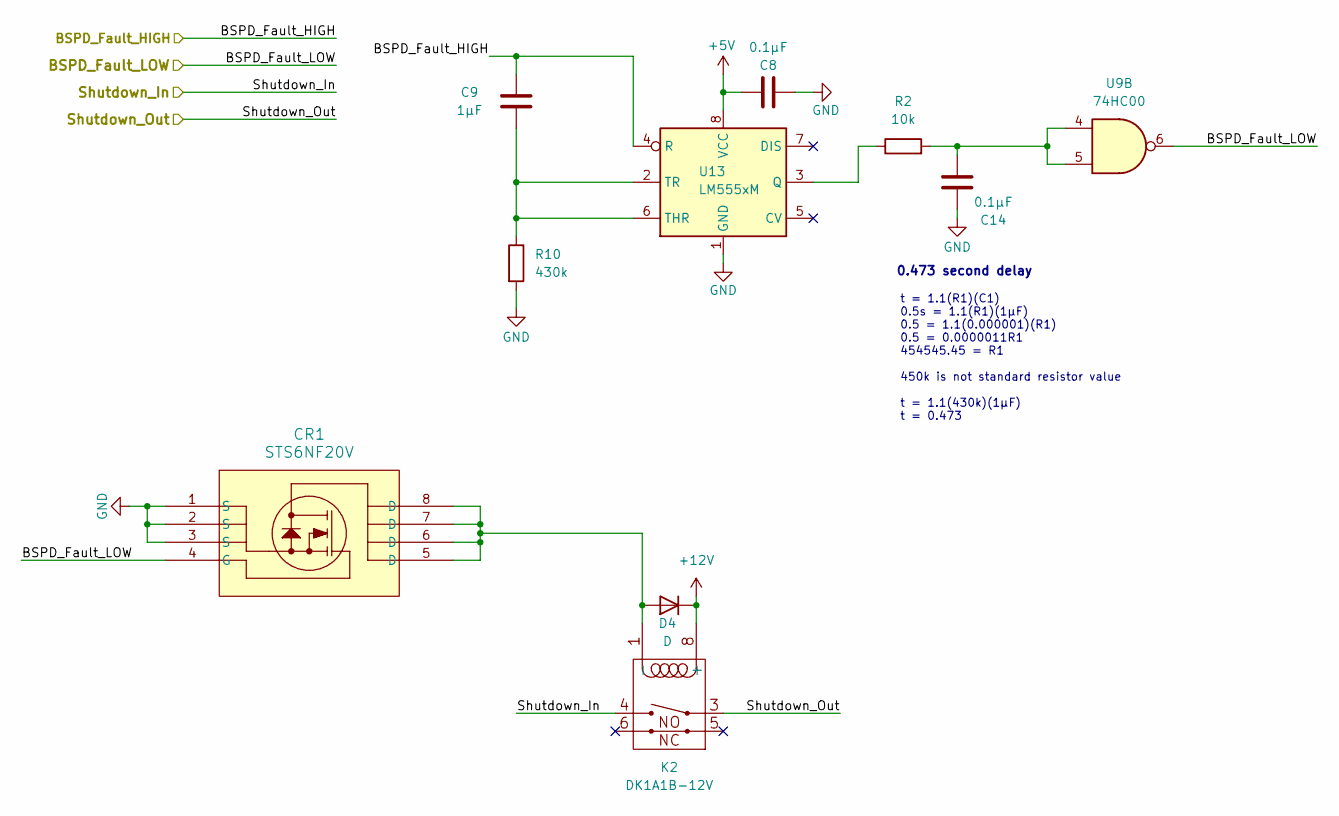
[picture p44: schematic BSPD_timer.kicad_sch]

Parts:
C8, C14: 0.1μF; C_0805_2012Metric_Pad1.18x1.45mm_HandSolder; Part Name Capacitor
C9: 1µF; C_0805_2012Metric_Pad1.18x1.45mm_HandSolder; Part Name Capacitor
CR1: STS6NF20V; SO-8_3.9x4.9mm_P1.27mm; Part Name Mosfet
D4: D; D_2010_5025Metric_Pad1.52x2.65mm_HandSolder; Part Name Diode
K2: DK1A1B-12V; DK1A1B; Mouser Part Number 769-DK1A1B-12V
R2: 10k; R_0805_2012Metric_Pad1.20x1.40mm_HandSolder; Part Name Resistor
R10: 430k; R_0805_2012Metric_Pad1.20x1.40mm_HandSolder; Part Name Resistor
U9: 74HC00; SOIC-14_3.9x8.7mm_P1.27mm; Part Name NAND Gate
U13: LM555xM; SOIC-8_3.9x4.9mm_P1.27mm; Part Name 555 Timer

Connections:
+5V: C8.2, U13.8 (VCC); also elsewhere on the board
+12V: D4.1 (K), K2.8 (+); also elsewhere on the board
/BSPD_Fault_HIGH: C9.1, U13.4 (R); also elsewhere on the board
/BSPD_Fault_LOW: CR1.4 (G), U9.6; also elsewhere on the board
/Shutdown_In: K2.4; also elsewhere on the board
/Shutdown_Out: K2.3; also elsewhere on the board
GND: C8.1, C14.1, CR1.1 (S), CR1.2 (S), CR1.3 (S), R10.2, U13.1 (GND); also elsewhere on the board
unnamed: C14.2, R2.2, U9.4, U9.5
unnamed: CR1.5 (D), CR1.6 (D), CR1.7 (D), CR1.8 (D), D4.2 (A), K2.1 (-)
unnamed: R2.1, U13.3 (Q)
unnamed: C9.2, R10.1, U13.2 (TR), U13.6 (THR)

Notes on the sheet:
0.473 second delay
t = 1.1(R1)(C1) 0.5s = 1.1(R1)(1µF) 0.5 = 1.1(0.000001)(R1) 0.5 = 0.0000011R1 454545.45 = R1 450k is not standard resistor value t = 1.1(430k)(1µF) t = 0.473

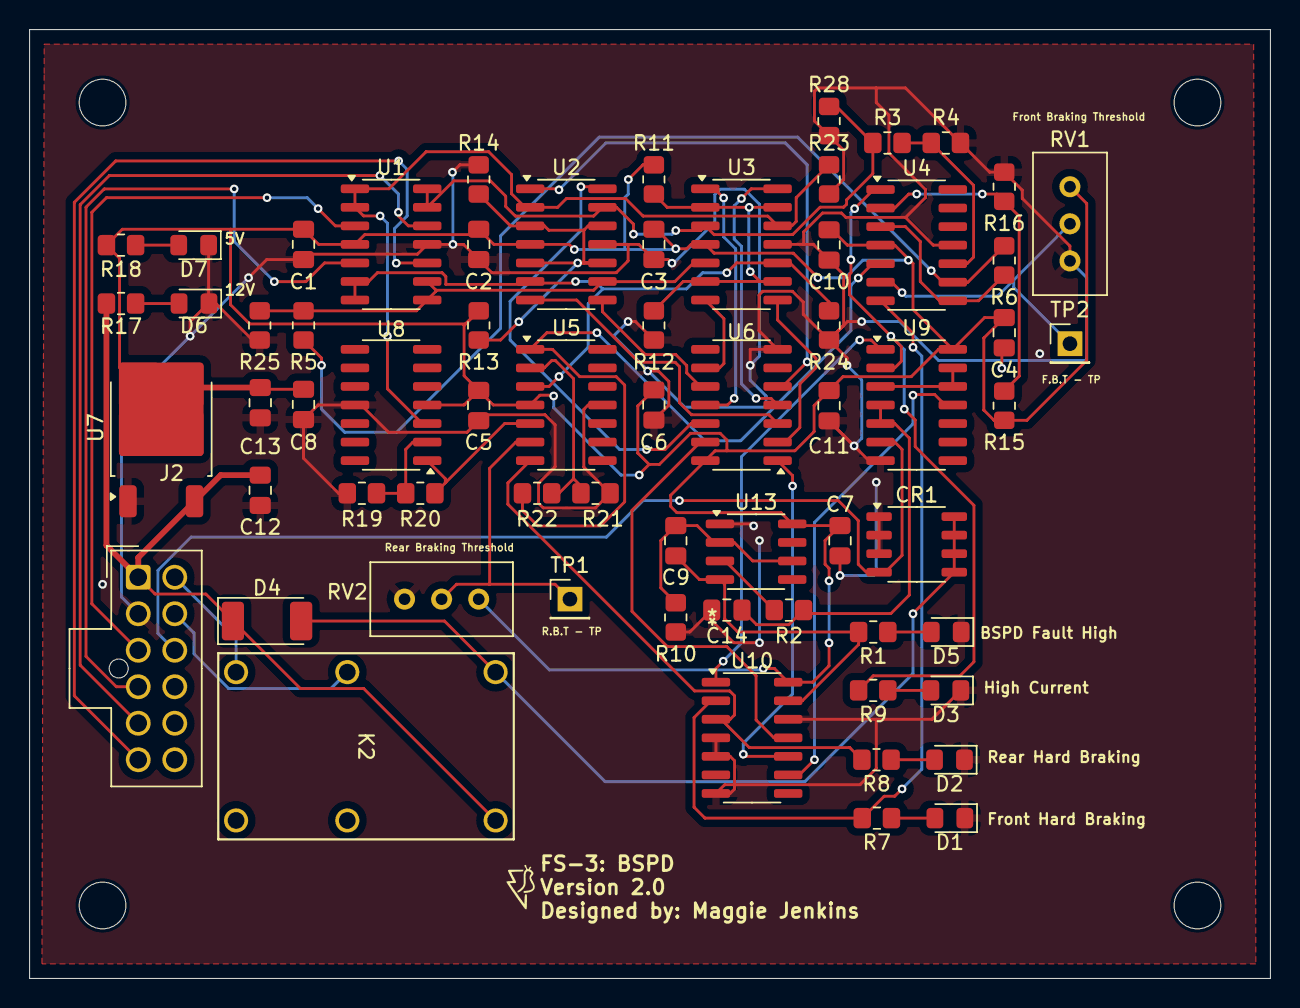
[picture p45: board BSPD.kicad_pcb from above]

Board: 2 copper layers, 85.0 x 65.0 mm, 65 parts (0 on the bottom side), 53 nets.
