formulaslug/fs-3-schematics/Live_Telemetry_Receiver_Board_V2/Live_Telemetry_Receiver_Board_V2.kicad_pcb

## KiCad design Live_Telemetry_Receiver_Board_V2/Live_Telemetry_Receiver_Board_V2.kicad_pcb (2025-02-21)

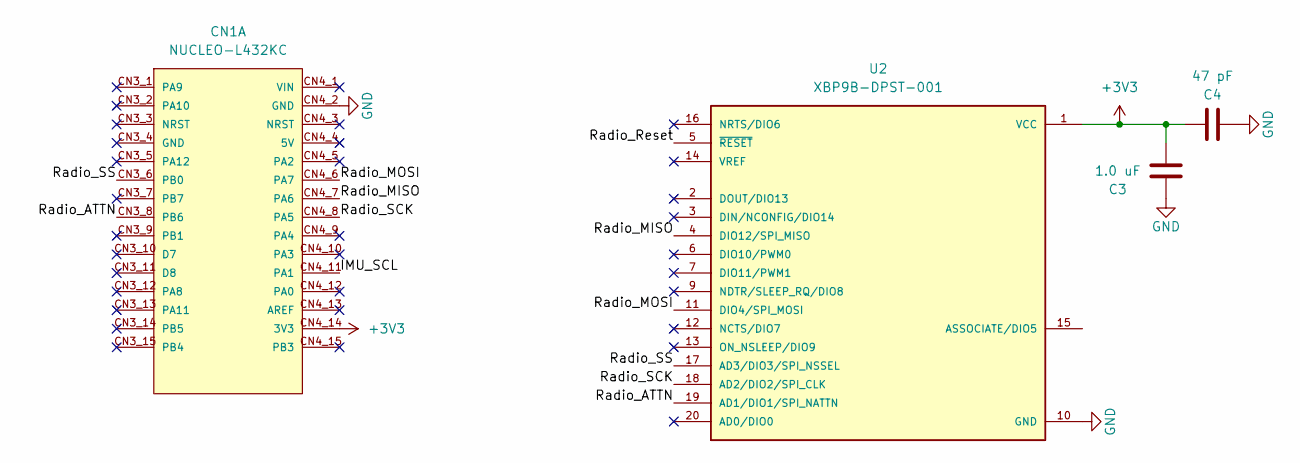
[picture p46: schematic Live_Telemetry_Receiver_Board_V2.kicad_sch]

Parts:
C3: 1.0 uF; C_0805_2012Metric_Pad1.18x1.45mm_HandSolder
C4: 47 pF; C_0805_2012Metric_Pad1.18x1.45mm_HandSolder
CN1: NUCLEO-L432KC; PARTREV N/A
U2: XBP9B-DPST-001

Connections:
+3V3: C3.1, C4.1, CN1.CN4_14 (3V3), U2.1 (VCC)
/IMU_SCL: CN1.CN4_11 (PA1)
/Radio_ATTN: CN1.CN3_8 (PB6), U2.19 (AD1/DIO1/SPI_NATTN)
/Radio_MISO: CN1.CN4_7 (PA6), U2.4 (DIO12/SPI_MISO)
/Radio_MOSI: CN1.CN4_6 (PA7), U2.11 (DIO4/SPI_MOSI)
/Radio_Reset: U2.5 (~RESET)
/Radio_SCK: CN1.CN4_8 (PA5), U2.18 (AD2/DIO2/SPI_CLK)
/Radio_SS: CN1.CN3_6 (PB0), U2.17 (AD3/DIO3/SPI_NSSEL)
GND: C3.2, C4.2, CN1.CN4_2 (GND), U2.10 (GND)

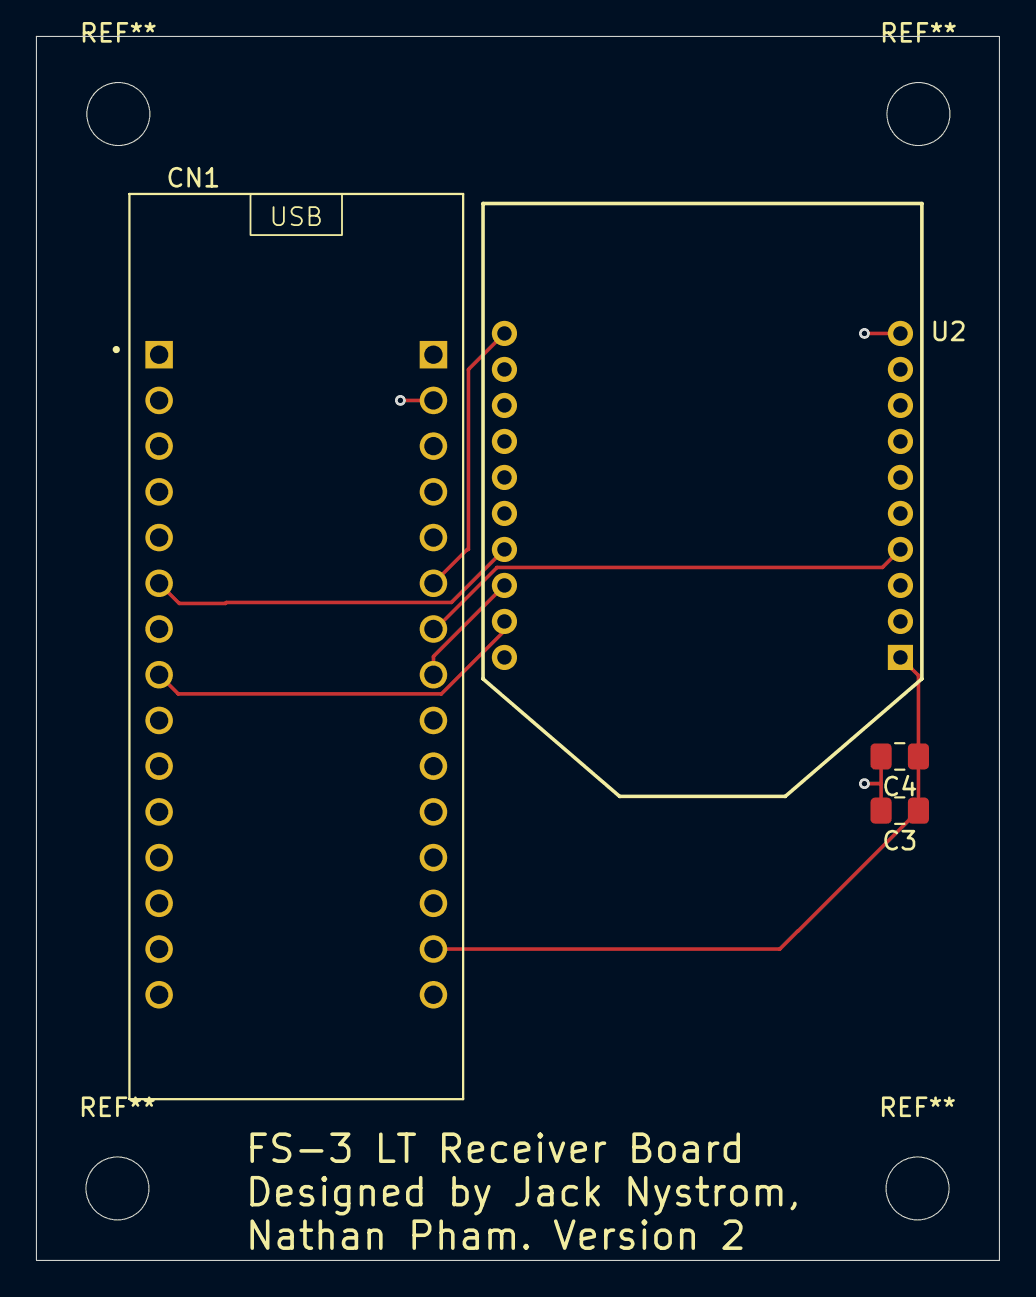
[picture p47: board Live_Telemetry_Receiver_Board_V2.kicad_pcb from above]

Board: 2 copper layers, 53.5 x 68.0 mm, 4 parts (0 on the bottom side), 7 nets.
