formulaslug/fs-3-schematics/Live_Telemetry_Board/Live_Telemetry_Board.kicad_pcb

## KiCad design Live_Telemetry_Board/Live_Telemetry_Board.kicad_pcb (2025-01-29)

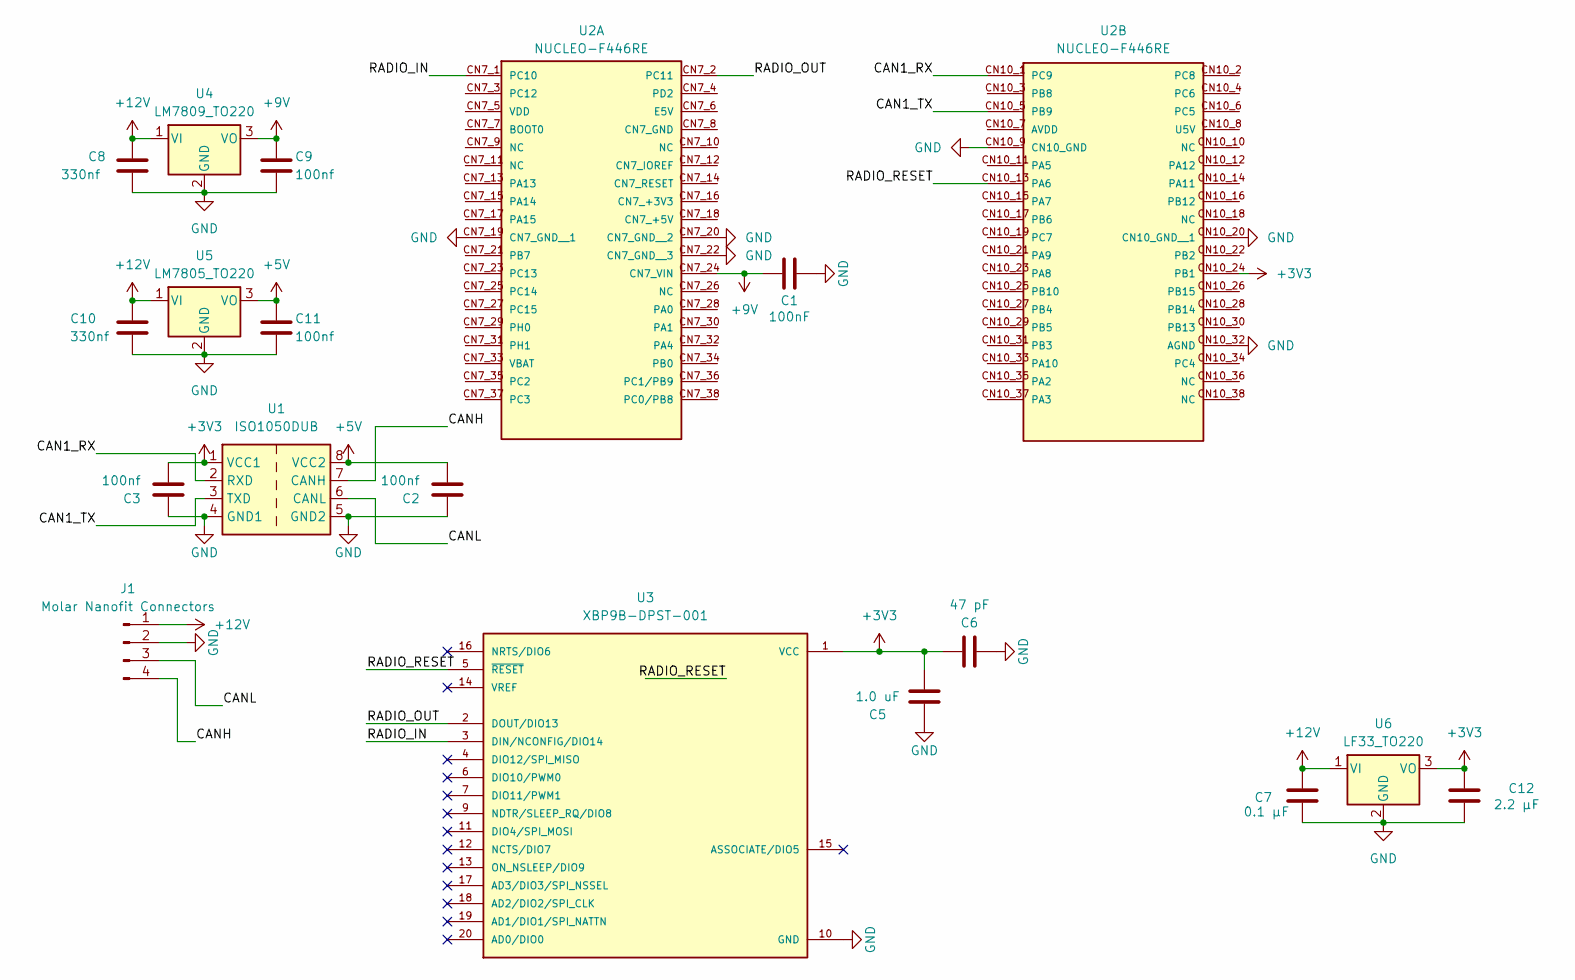
[picture p48: schematic Live_Telemetry_Board.kicad_sch, Live Telemetry Testing Board]

Parts:
C1: 100nF; C_0805_2012Metric_Pad1.18x1.45mm_HandSolder
C2, C3, C9, C11: 100nf; C_0805_2012Metric_Pad1.18x1.45mm_HandSolder
C5: 1.0 uF; C_0805_2012Metric_Pad1.18x1.45mm_HandSolder
C6: 47 pF; C_0805_2012Metric_Pad1.18x1.45mm_HandSolder
C7: 0.1 µF; C_0805_2012Metric
C8, C10: 330nf; C_0805_2012Metric_Pad1.18x1.45mm_HandSolder
C12: 2.2 µF; C_0805_2012Metric
J1: Molar Nanofit Connectors; Molex_Nano-Fit_105309-xx04_1x04_P2.50mm_Vertical
U1: ISO1050DUB; SOP-8_6.62x9.15mm_P2.54mm
U2: NUCLEO-F446RE; PARTREV 13
U3: XBP9B-DPST-001
U4: LM7809_TO220; TO-220-3_Vertical
U5: LM7805_TO220; TO-220-3_Vertical
U6: LF33_TO220; TO-220-3_Vertical

Connections:
+3V3: C3.2, C5.1, C6.1, C12.1, U1.1 (VCC1), U2.CN10_24 (PB1), U3.1 (VCC), U6.3 (VO)
+5V: C2.2, C11.1, U1.8 (VCC2), U5.3 (VO)
+9V: C1.1, C9.1, U2.CN7_24 (CN7_VIN), U4.3 (VO)
+12V: C7.1, C8.1, C10.1, J1.1, U4.1 (VI), U5.1 (VI), U6.1 (VI)
/CAN1_RX: U1.2 (RXD), U2.CN10_1 (PC9)
/CAN1_TX: U1.3 (TXD), U2.CN10_5 (PB9)
/CANH: J1.4, U1.7 (CANH)
/CANL: J1.3, U1.6 (CANL)
/RADIO_IN: U2.CN7_1 (PC10), U3.3 (DIN/NCONFIG/DIO14)
/RADIO_OUT: U2.CN7_2 (PC11), U3.2 (DOUT/DIO13)
/RADIO_RESET: U2.CN10_13 (PA6), U3.5 (~RESET)
GND: C1.2, C2.1, C3.1, C5.2, C6.2, C7.2, C8.2, C9.2, C10.2, C11.2, C12.2, J1.2, U1.4 (GND1), U1.5 (GND2), U2.CN7_19 (CN7_GND__1), U2.CN7_20 (CN7_GND__2), U2.CN7_22 (CN7_GND__3), U2.CN10_9 (CN10_GND), U2.CN10_20 (CN10_GND__1), U2.CN10_32 (AGND), U3.10 (GND), U4.2 (GND), U5.2 (GND), U6.2 (GND)

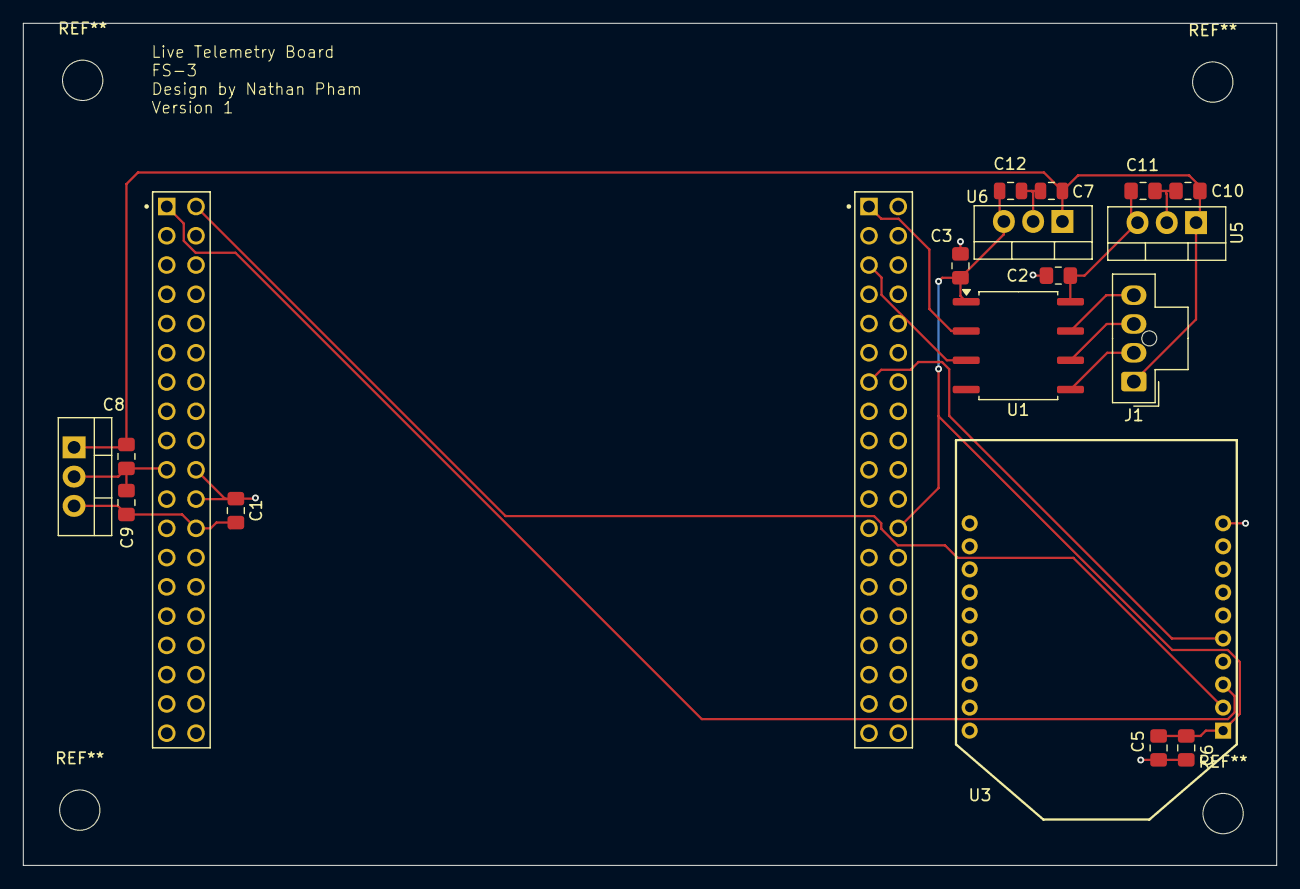
[picture p49: board Live_Telemetry_Board.kicad_pcb from above]

Board: 2 copper layers, 108.8 x 73.1 mm, 18 parts (0 on the bottom side), 12 nets.
