formulaslug/fs-3-schematics/Live_Telemetry_Receiver_Board/Live_Telemetry_Receiver_Board.kicad_pcb

## KiCad design Live_Telemetry_Receiver_Board/Live_Telemetry_Receiver_Board.kicad_pcb (2025-01-29, an earlier design)

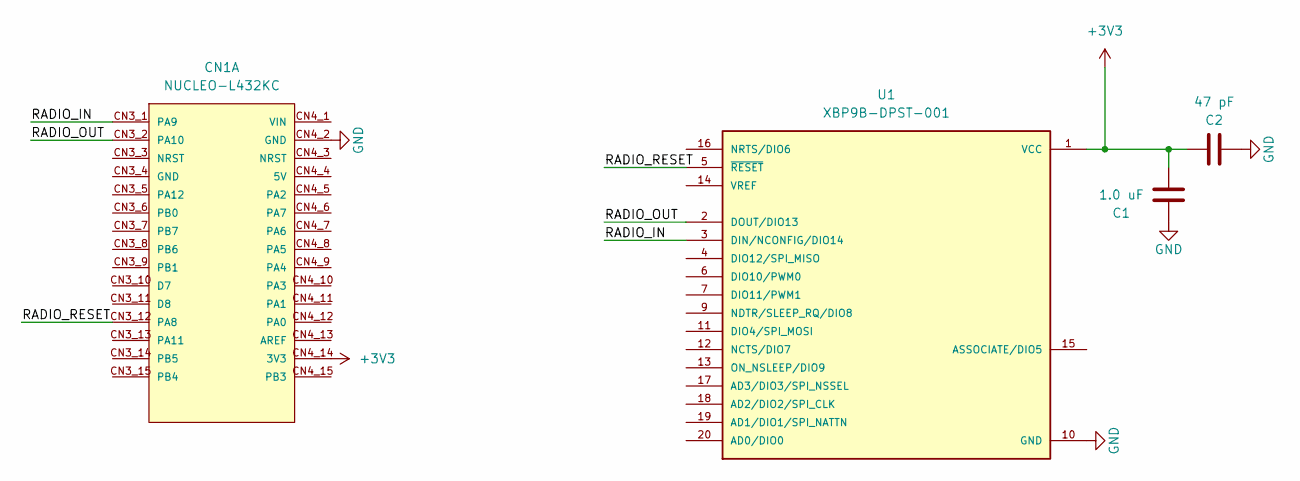
[picture p50: schematic Live_Telemetry_Receiver_Board.kicad_sch]

Parts:
C1: 1.0 uF; C_0805_2012Metric_Pad1.18x1.45mm_HandSolder
C2: 47 pF; C_0805_2012Metric_Pad1.18x1.45mm_HandSolder
CN1: NUCLEO-L432KC; PARTREV N/A
U1: XBP9B-DPST-001

Connections:
+3V3: C1.1, C2.1, CN1.CN4_14 (3V3), U1.1 (VCC)
/RADIO_IN: CN1.CN3_1 (PA9), U1.3 (DIN/NCONFIG/DIO14)
/RADIO_OUT: CN1.CN3_2 (PA10), U1.2 (DOUT/DIO13)
/RADIO_RESET: CN1.CN3_12 (PA8), U1.5 (~RESET)
GND: C1.2, C2.2, CN1.CN4_2 (GND), U1.10 (GND)

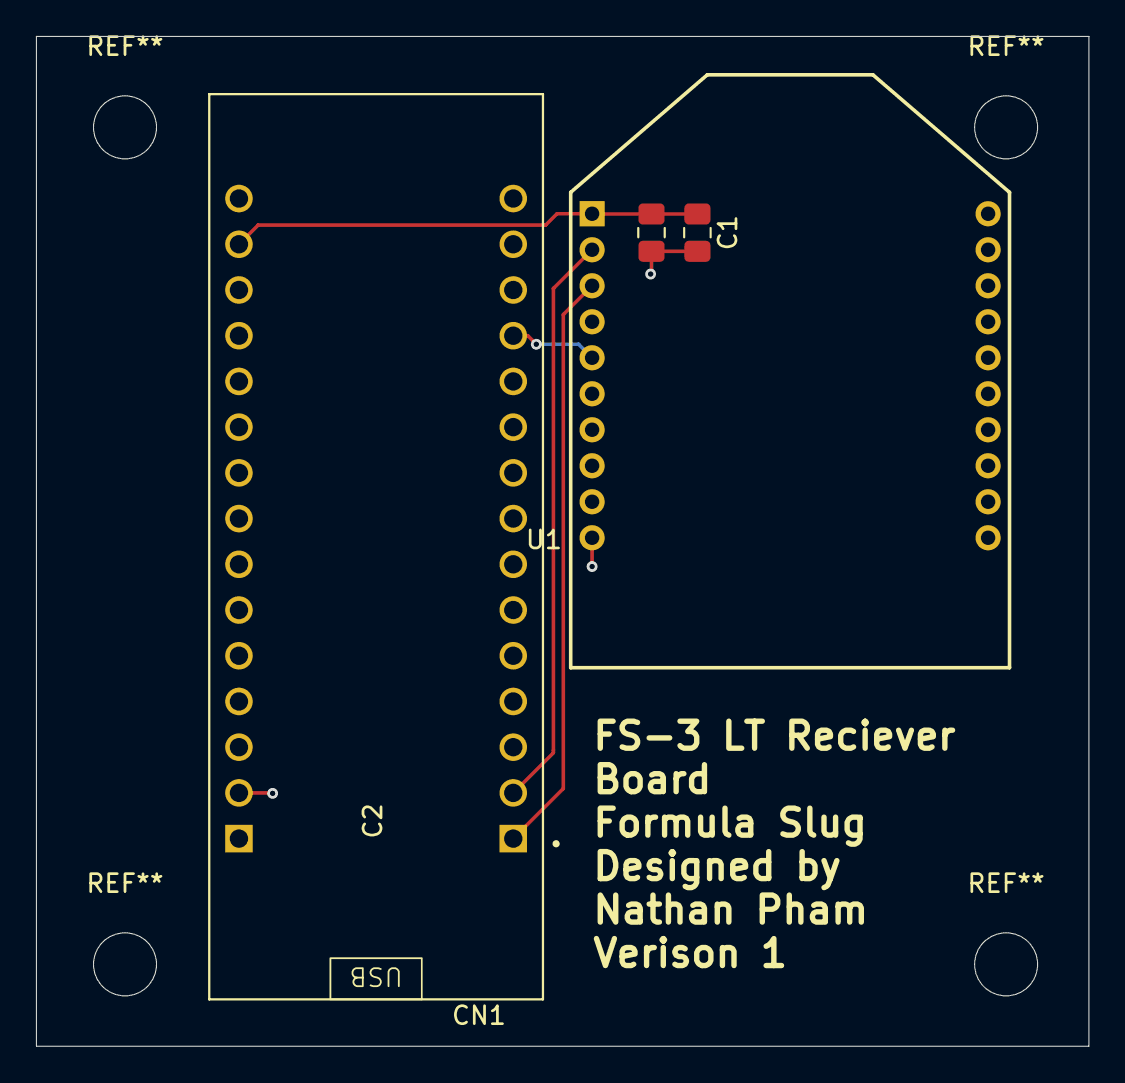
[picture p51: board Live_Telemetry_Receiver_Board.kicad_pcb from above]

Board: 2 copper layers, 58.5 x 56.1 mm, 4 parts (0 on the bottom side), 5 nets.
