formulaslug/fs-3-schematics/Dash/Dash.kicad_pcb

## KiCad design Dash/Dash.kicad_pcb (2025-01-15)

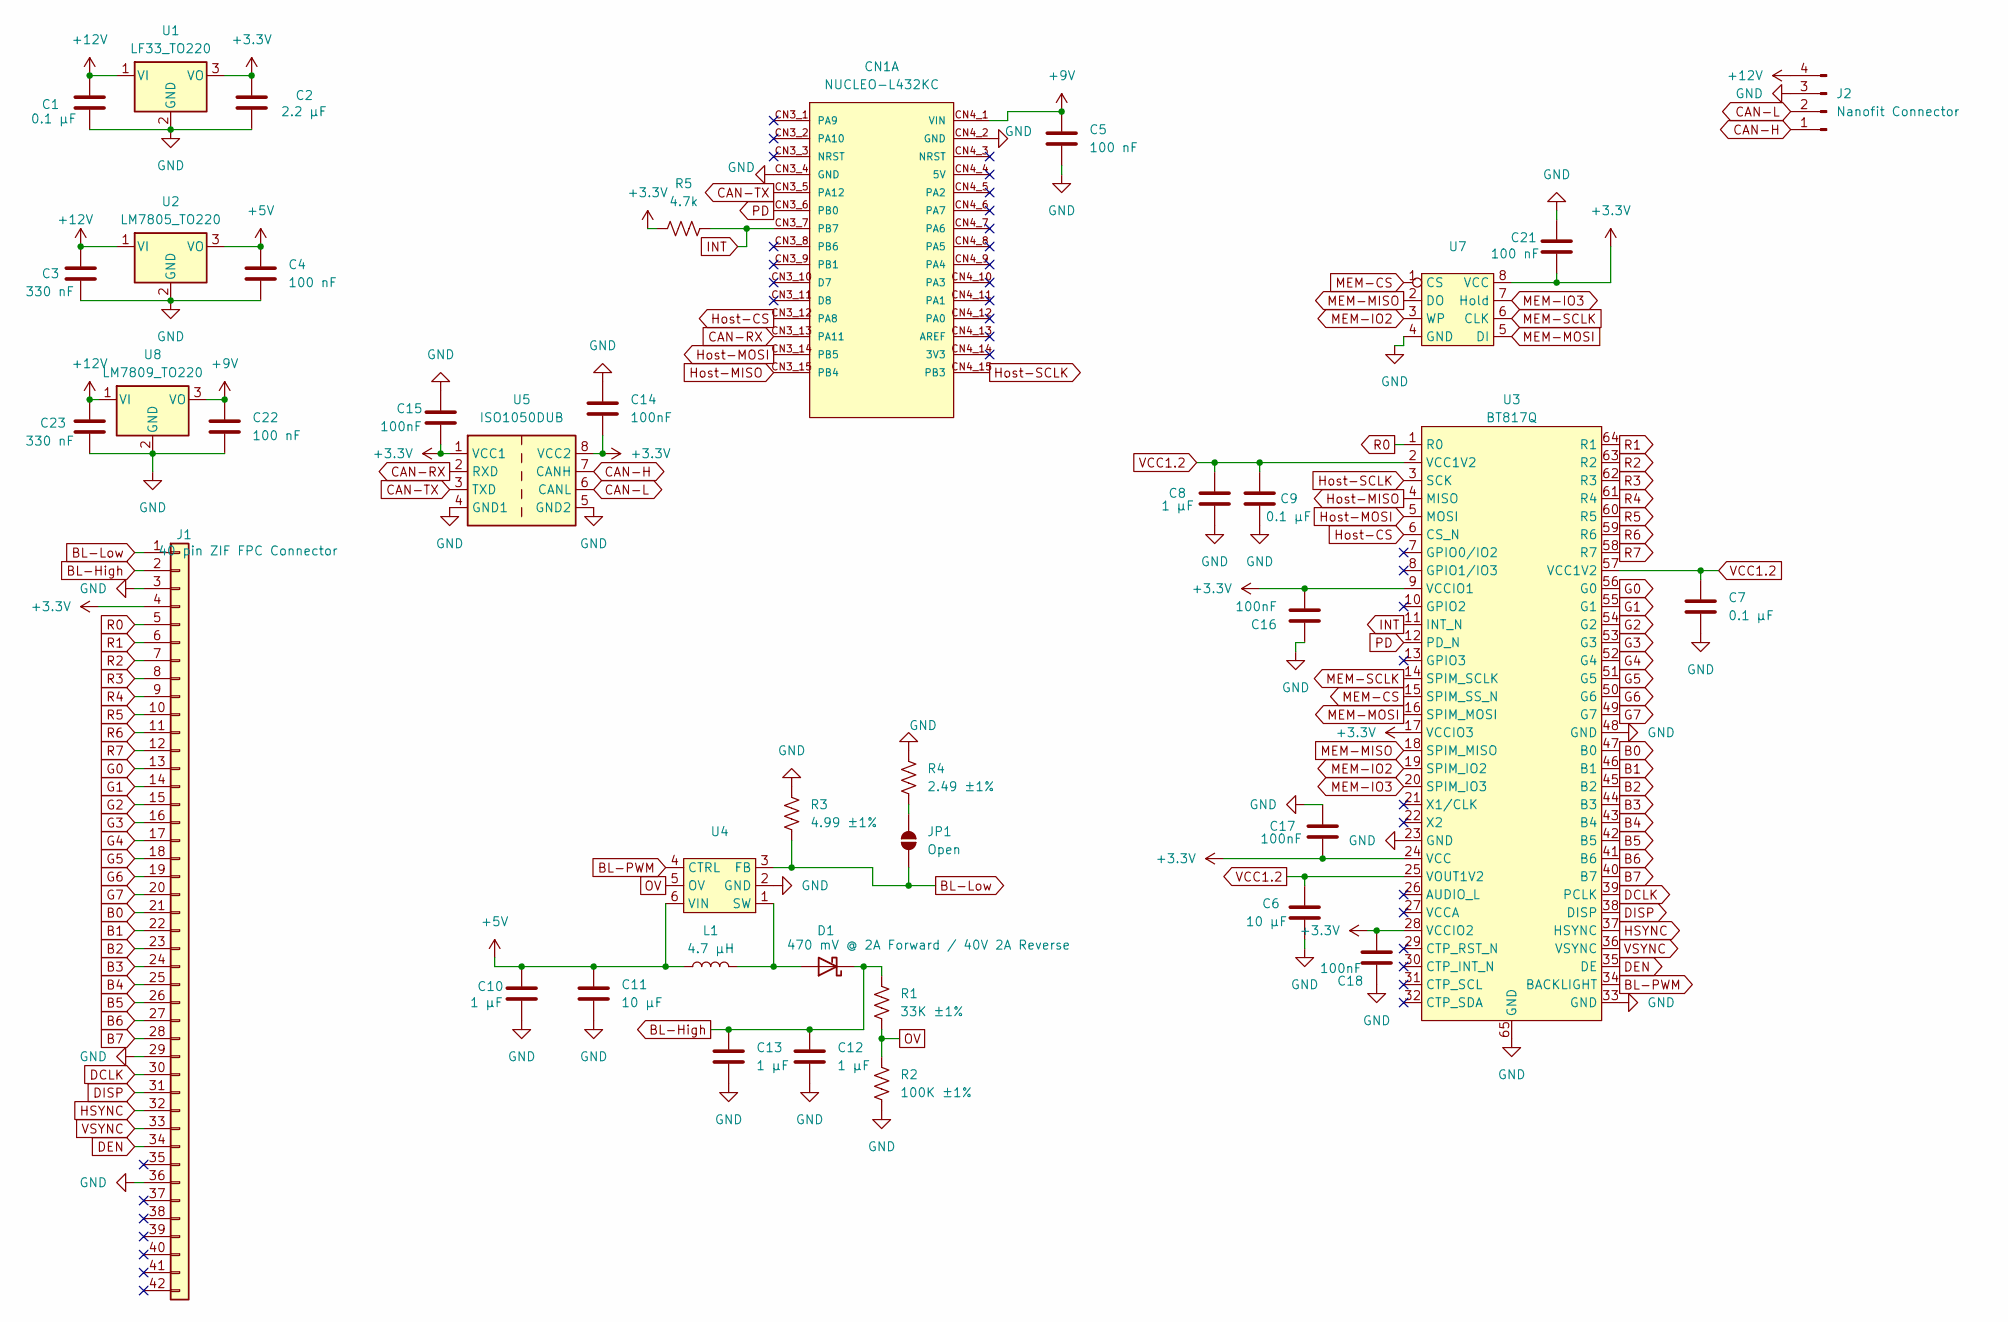
[picture p52: schematic Dash.kicad_sch, FS-3 Dash]

Parts:
C1, C7, C9: 0.1 µF; C_0805_2012Metric
C2: 2.2 µF; C_0805_2012Metric
C3, C23: 330 nF; C_0805_2012Metric
C4, C5, C21, C22: 100 nF; C_0805_2012Metric
C6, C11: 10 µF; C_0805_2012Metric
C8, C10, C12, C13: 1 µF; C_0805_2012Metric
C14, C15, C16, C17, C18: 100nF; C_0805_2012Metric
CN1: NUCLEO-L432KC; PARTREV N/A
D1: 470 mV @ 2A Forward / 40V 2A Reverse; US2H_TOS
J1: 40 pin ZIF FPC Connector; CONN_F32D-1A7Y1-21040_AMP
J2: Nanofit Connector; Molex_Nano-Fit_105310-xx04_2x02_P2.50mm_Vertical
JP1: Open; SolderJumper-2_P1.3mm_Open_RoundedPad1.0x1.5mm
L1: 4.7 µH; L_TDK_SLF7045
R1: 33K ±1%; R_0805_2012Metric
R2: 100K ±1%; R_0805_2012Metric
R3: 4.99 ±1%; R_0805_2012Metric
R4: 2.49 ±1%; R_0805_2012Metric
R5: 4.7k; R_0805_2012Metric
U1: LF33_TO220; TO-220-3_Vertical
U2: LM7805_TO220; TO-220-3_Vertical
U3: BT817Q; VQFN-64-1EP_9x9mm_P0.5mm_EP7.15x7.15mm
U4: SOT-23-6_Handsoldering
U5: ISO1050DUB; SOP-8_6.62x9.15mm_P2.54mm
U7: SOIC-8_5.23x5.23mm_P1.27mm
U8: LM7809_TO220; TO-220-3_Vertical

Connections:
+3.3V: C2.1, C14.2, C15.2, C16.2, C17.2, C18.2, C21.2, J1.4, R5.1, U1.3 (VO), U3.9 (VCCIO1), U3.17 (VCCIO3), U3.24 (VCC), U3.28 (VCCIO2), U5.1 (VCC1), U5.8 (VCC2), U7.8 (VCC)
+5V: C4.1, C10.1, C11.1, L1.1, U2.3 (VO), U4.6 (VIN)
+9V: C5.2, C22.1, CN1.CN4_1 (VIN), U8.3 (VO)
+12V: C1.1, C3.1, C23.1, J2.4, U1.1 (VI), U2.1 (VI), U8.1 (VI)
B0: J1.21, U3.47 (B0)
B1: J1.22, U3.46 (B1)
B2: J1.23, U3.45 (B2)
B3: J1.24, U3.44 (B3)
B4: J1.25, U3.43 (B4)
B5: J1.26, U3.42 (B5)
B6: J1.27, U3.41 (B6)
B7: J1.28, U3.40 (B7)
BL-High: C12.1, C13.1, D1.1 (K), J1.2, R1.1
BL-Low: J1.1, JP1.2 (B), R3.2, U4.3 (FB)
BL-PWM: U3.34 (BACKLIGHT), U4.4 (CTRL)
CAN-H: J2.1, U5.7 (CANH)
CAN-L: J2.2, U5.6 (CANL)
CAN-RX: CN1.CN3_13 (PA11), U5.2 (RXD)
CAN-TX: CN1.CN3_5 (PA12), U5.3 (TXD)
DCLK: J1.30, U3.39 (PCLK)
DEN: J1.34, U3.35 (DE)
DISP: J1.31, U3.38 (DISP)
G0: J1.13, U3.56 (G0)
G1: J1.14, U3.55 (G1)
G2: J1.15, U3.54 (G2)
G3: J1.16, U3.53 (G3)
G4: J1.17, U3.52 (G4)
G5: J1.18, U3.51 (G5)
G6: J1.19, U3.50 (G6)
G7: J1.20, U3.49 (G7)
GND: C1.2, C2.2, C3.2, C4.2, C5.1, C6.2, C7.2, C8.2, C9.2, C10.2, C11.2, C12.2, C13.2, C14.1, C15.1, C16.1, C17.1, C18.1, C21.1, C22.2, C23.2, CN1.CN3_4 (GND), CN1.CN4_2 (GND), J1.3, J1.29, J1.36, J2.3, R2.2, R3.1, R4.1, U1.2 (GND), U2.2 (GND), U3.23 (GND), U3.33 (GND), U3.48 (GND), U3.65 (GND), U4.2 (GND), U5.4 (GND1), U5.5 (GND2), U7.4 (GND), U8.2 (GND)
HSYNC: J1.32, U3.37 (HSYNC)
Host-CS: CN1.CN3_12 (PA8), U3.6 (CS_N)
Host-MISO: CN1.CN3_15 (PB4), U3.4 (MISO)
Host-MOSI: CN1.CN3_14 (PB5), U3.5 (MOSI)
Host-SCLK: CN1.CN4_15 (PB3), U3.3 (SCK)
INT: CN1.CN3_7 (PB7), R5.2, U3.11 (INT_N)
MEM-CS: U3.15 (SPIM_SS_N), U7.1 (CS)
MEM-IO2: U3.19 (SPIM_IO2), U7.3 (WP)
MEM-IO3: U3.20 (SPIM_IO3), U7.7 (Hold)
MEM-MISO: U3.18 (SPIM_MISO), U7.2 (DO)
MEM-MOSI: U3.16 (SPIM_MOSI), U7.5 (DI)
MEM-SCLK: U3.14 (SPIM_SCLK), U7.6 (CLK)
unnamed: D1.2 (A), L1.2, U4.1 (SW)
unnamed: JP1.1 (A), R4.2
OV: R1.2, R2.1, U4.5 (OV)
PD: CN1.CN3_6 (PB0), U3.12 (PD_N)
R0: J1.5, U3.1 (R0)
R1: J1.6, U3.64 (R1)
R2: J1.7, U3.63 (R2)
R3: J1.8, U3.62 (R3)
R4: J1.9, U3.61 (R4)
R5: J1.10, U3.60 (R5)
R6: J1.11, U3.59 (R6)
R7: J1.12, U3.58 (R7)
VCC1.2: C6.1, C7.1, C8.1, C9.1, U3.2 (VCC1V2), U3.25 (VOUT1V2), U3.57 (VCC1V2)
VSYNC: J1.33, U3.36 (VSYNC)

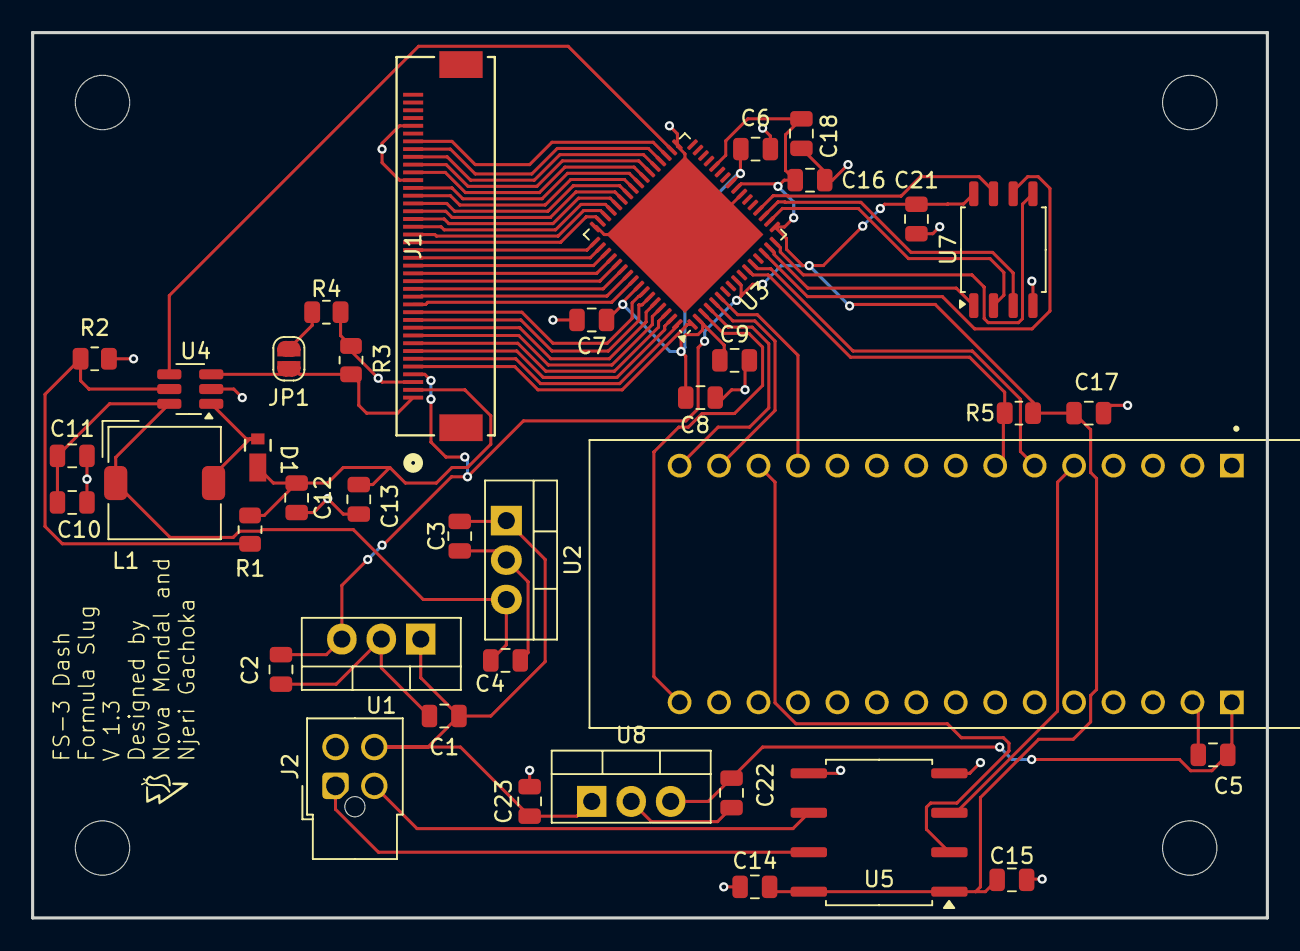
[picture p53: board Dash.kicad_pcb from above]

Board: 2 copper layers, 79.5 x 57.0 mm, 39 parts (0 on the bottom side), 57 nets.
