formulaslug/fs-3-schematics/Telemetry_board_2.0/Telemetry Main Board Revision 1/Revision 1/Revision 1.kicad_pcb

## KiCad design Telemetry_board_2.0/Telemetry Main Board Revision 1/Revision 1/Revision 1.kicad_pcb (2025-01-15)

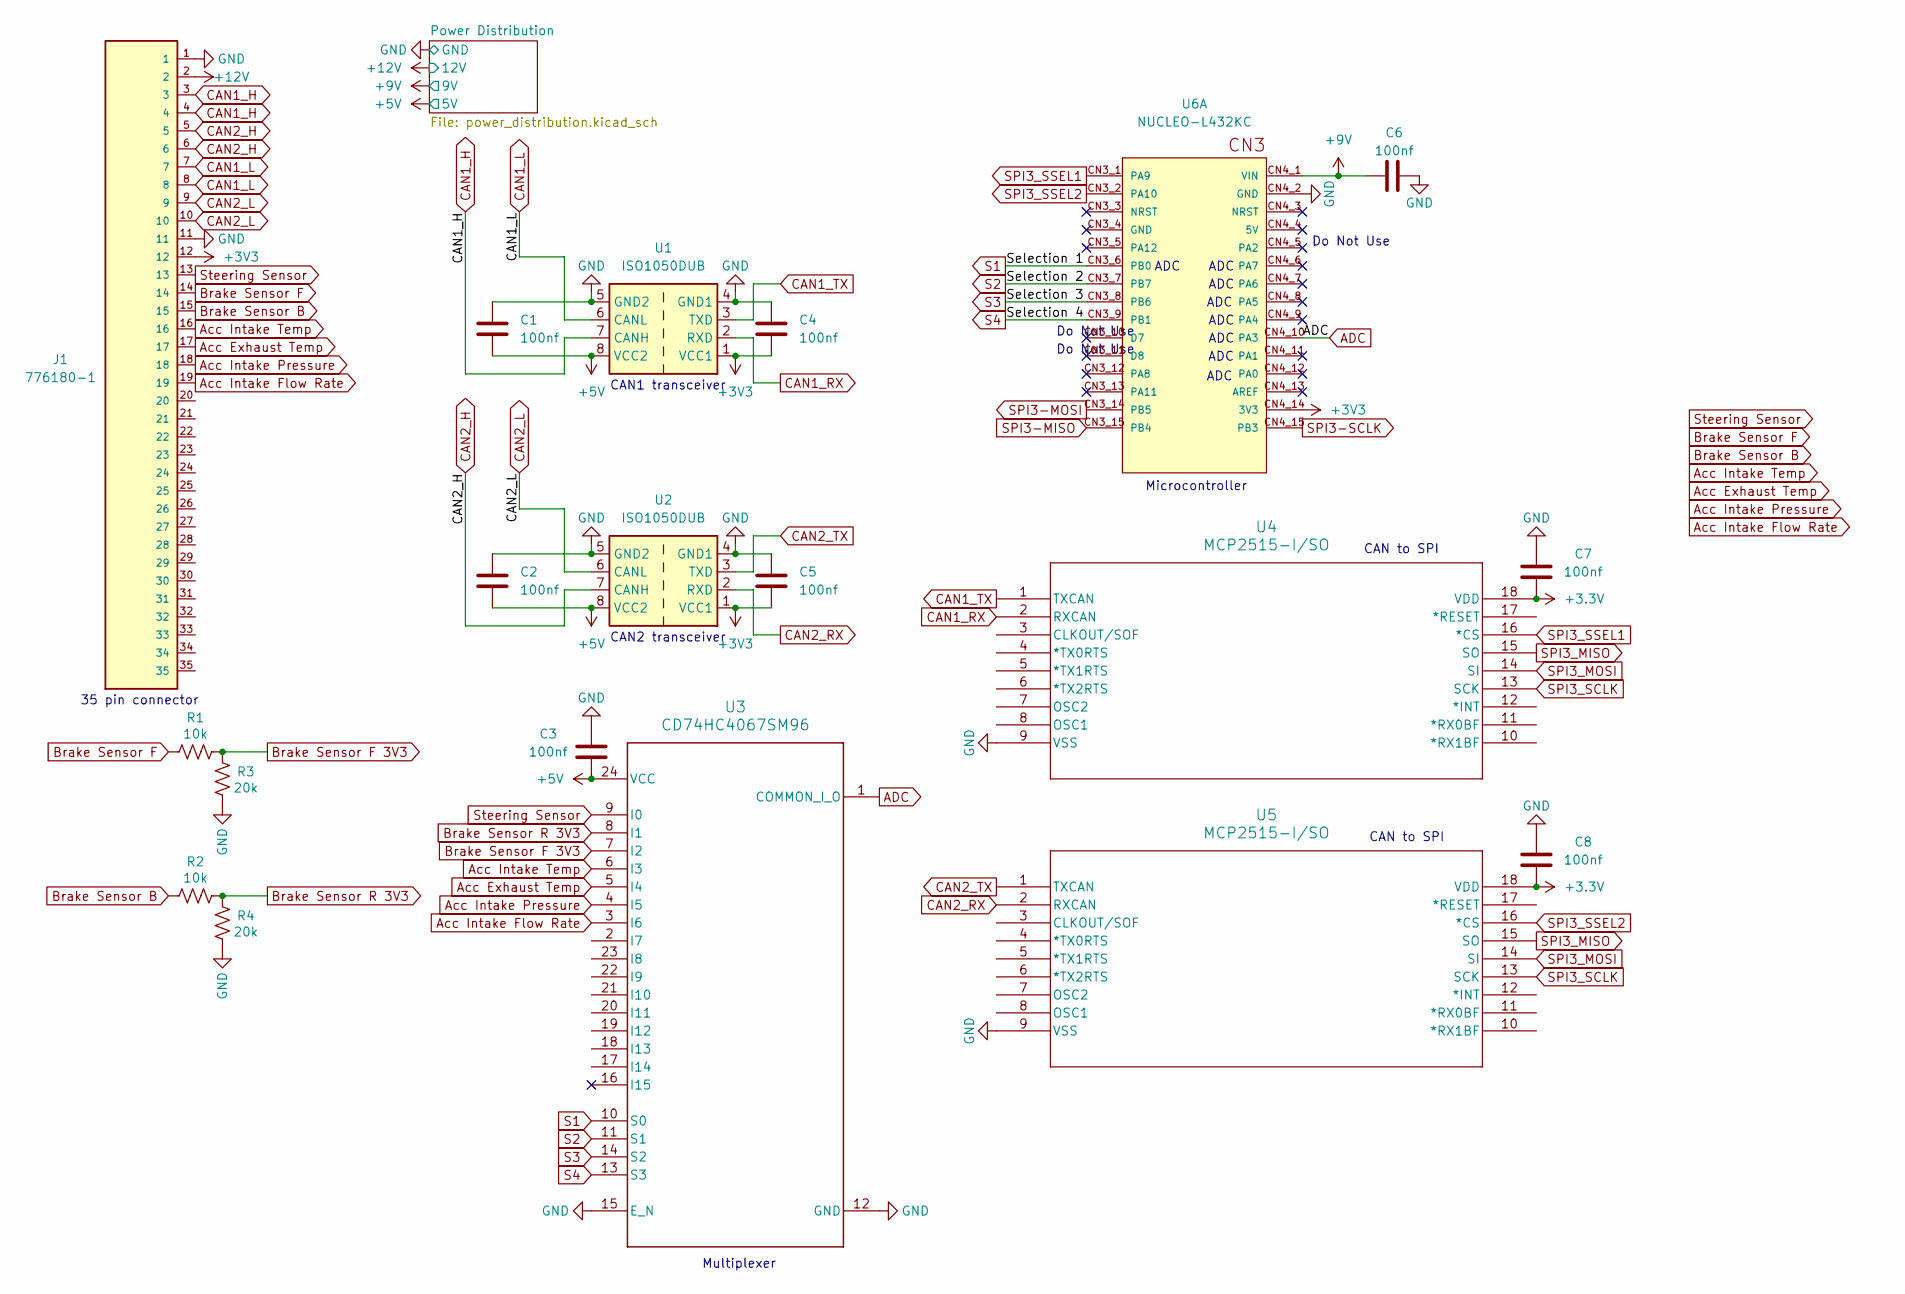
[picture p54: schematic Revision 1.kicad_sch]

Parts:
C1, C2, C3, C4, C5, C6, C7, C8: 100nf; C_0805_2012Metric_Pad1.18x1.45mm_HandSolder
J1: 776180-1; TE_776180-1; PARTREV H7
R1, R2: 10k; R_0805_2012Metric_Pad1.20x1.40mm_HandSolder
R3, R4: 20k; R_0805_2012Metric_Pad1.20x1.40mm_HandSolder
U1, U2: ISO1050DUB; SOP-8_6.62x9.15mm_P2.54mm
U3: CD74HC4067SM96; SSOP-24_5.3x8.2mm_P0.65mm
U4, U5: MCP2515-I/SO; SOIC-18W_7.5x11.6mm_P1.27mm
U6: NUCLEO-L432KC; PARTREV N/A

Connections:
+3.3V: C7.1, C8.1, U4.18 (VDD), U5.18 (VDD)
+3V3: C4.2, C5.2, J1.12, U1.1 (VCC1), U2.1 (VCC1), U6.CN4_14 (3V3)
+5V: C1.2, C2.2, C3.1, U1.8 (VCC2), U2.8 (VCC2), U3.24 (VCC); also elsewhere on the board
+9V: C6.1, U6.CN4_1 (VIN); also elsewhere on the board
+12V: J1.2; also elsewhere on the board
ADC: U3.1 (COMMON_I_O), U6.CN4_10 (PA3)
Acc Exhaust Temp: J1.17, U3.5 (I4)
Acc Intake Flow Rate: J1.19, U3.3 (I6)
Acc Intake Pressure: J1.18, U3.4 (I5)
Acc Intake Temp: J1.16, U3.6 (I3)
Brake Sensor B: J1.15, R2.1
Brake Sensor F: J1.14, R1.1
Brake Sensor F 3V3: R1.2, R3.2, U3.7 (I2)
Brake Sensor R 3V3: R2.2, R4.2, U3.8 (I1)
CAN1_H: J1.3, J1.4, U1.7 (CANH)
CAN1_L: J1.7, J1.8, U1.6 (CANL)
CAN1_RX: U1.2 (RXD), U4.2 (RXCAN)
CAN1_TX: U1.3 (TXD), U4.1 (TXCAN)
CAN2_H: J1.5, J1.6, U2.7 (CANH)
CAN2_L: J1.9, J1.10, U2.6 (CANL)
CAN2_RX: U2.2 (RXD), U5.2 (RXCAN)
CAN2_TX: U2.3 (TXD), U5.1 (TXCAN)
GND: C1.1, C2.1, C3.2, C4.1, C5.1, C6.2, C7.2, C8.2, J1.1, J1.11, R3.1, R4.1, U1.4 (GND1), U1.5 (GND2), U2.4 (GND1), U2.5 (GND2), U3.12 (GND), U3.15 (E_N), U4.9 (VSS), U5.9 (VSS), U6.CN4_2 (GND); also elsewhere on the board
S1: U3.10 (S0), U6.CN3_6 (PB0)
S2: U3.11 (S1), U6.CN3_7 (PB7)
S3: U3.14 (S2), U6.CN3_8 (PB6)
S4: U3.13 (S3), U6.CN3_9 (PB1)
SPI3-MISO: U6.CN3_15 (PB4)
SPI3-MOSI: U6.CN3_14 (PB5)
SPI3-SCLK: U6.CN4_15 (PB3)
SPI3_MISO: U4.15 (SO), U5.15 (SO)
SPI3_MOSI: U4.14 (SI), U5.14 (SI)
SPI3_SCLK: U4.13 (SCK), U5.13 (SCK)
SPI3_SSEL1: U4.16 (*CS), U6.CN3_1 (PA9)
SPI3_SSEL2: U5.16 (*CS), U6.CN3_2 (PA10)
Steering Sensor: J1.13, U3.9 (I0)

Notes on the sheet:
ADC
Do Not Use
35 pin connector
CAN2 transceiver
Microcontroller
CAN to SPI
CAN1 transceiver
Multiplexer

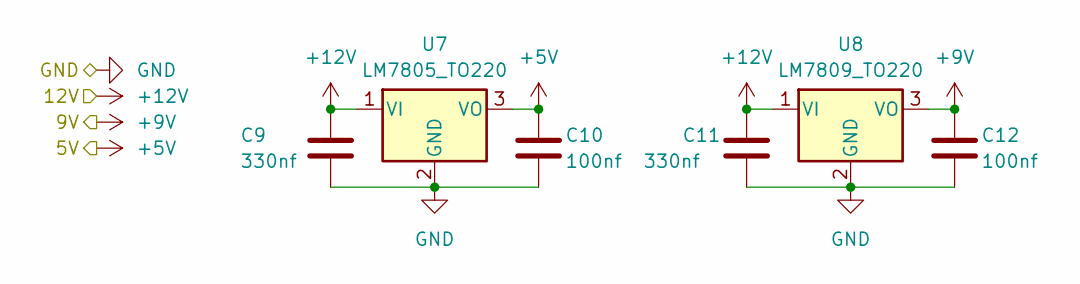
[picture p55: schematic power_distribution.kicad_sch]

Parts:
C9, C11: 330nf; C_0805_2012Metric_Pad1.18x1.45mm_HandSolder
C10, C12: 100nf; C_0805_2012Metric_Pad1.18x1.45mm_HandSolder
U7: LM7805_TO220; TO-220-3_Vertical
U8: LM7809_TO220; TO-220-3_Vertical

Connections:
+5V: C10.1, U7.3 (VO); also elsewhere on the board
+9V: C12.1, U8.3 (VO); also elsewhere on the board
+12V: C9.1, C11.1, U7.1 (VI), U8.1 (VI); also elsewhere on the board
GND: C9.2, C10.2, C11.2, C12.2, U7.2 (GND), U8.2 (GND); also elsewhere on the board

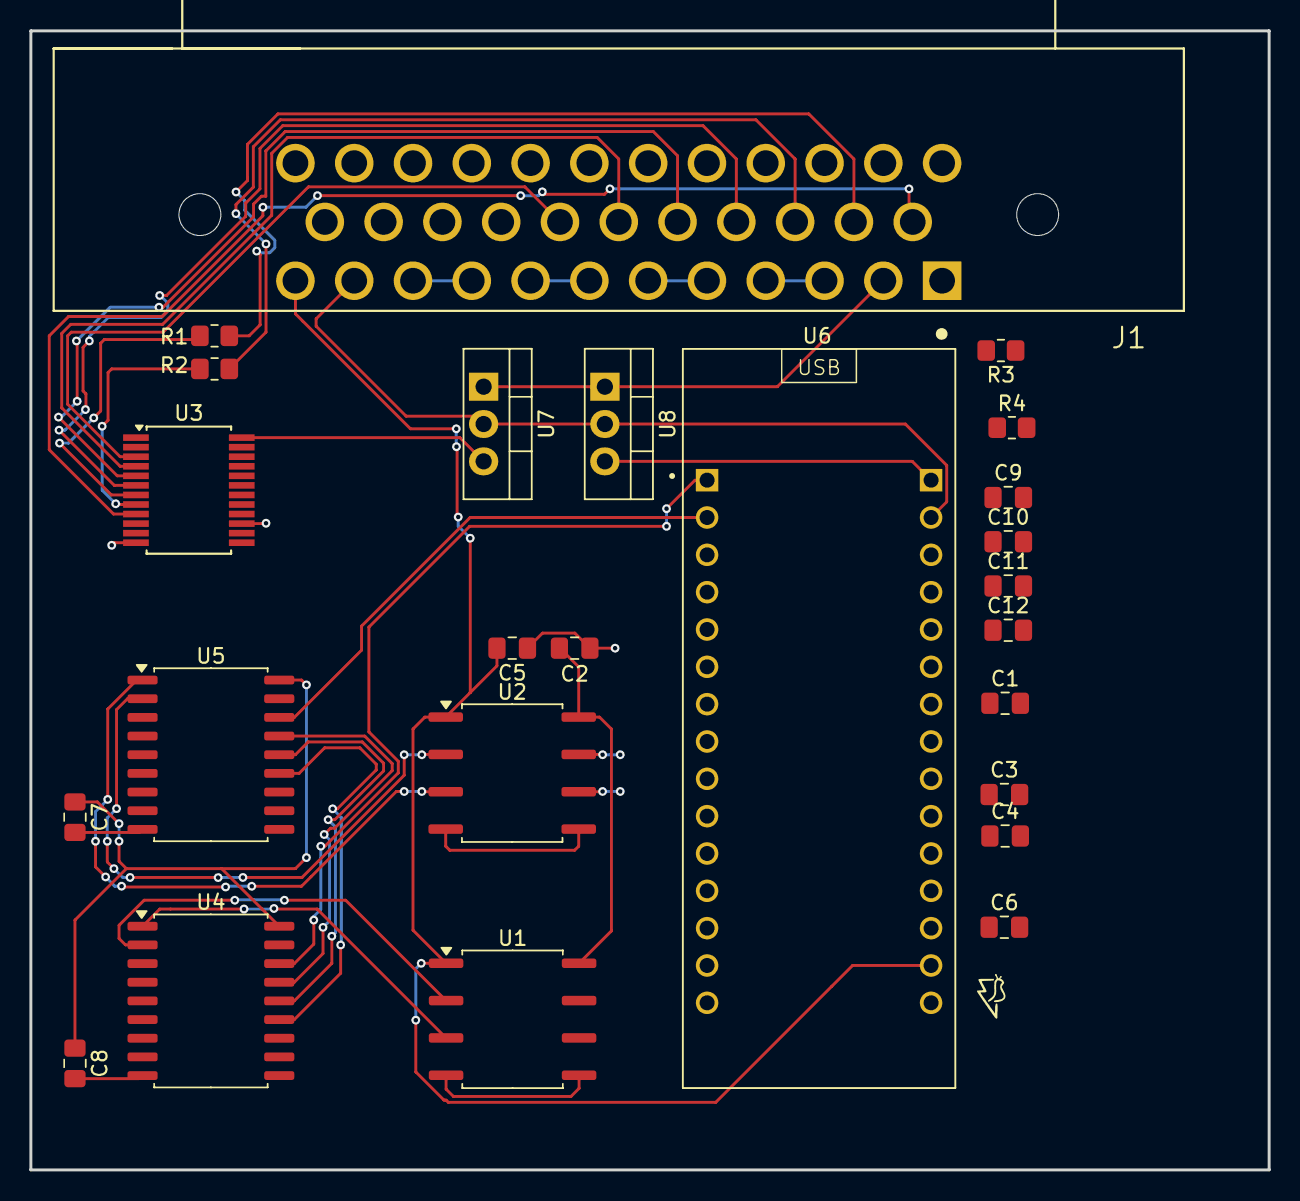
[picture p56: board Revision 1.kicad_pcb from above]

Board: 2 copper layers, 84.2 x 77.5 mm, 25 parts (0 on the bottom side), 33 nets.
