formulaslug/fs-3-schematics/Telemetry Upright Hall Effect Breakout Board/Telemetry Upright Hall Effect Breakout Board.kicad_pcb

## KiCad design Telemetry Upright Hall Effect Breakout Board/Telemetry Upright Hall Effect Breakout Board.kicad_pcb (2025-01-02)

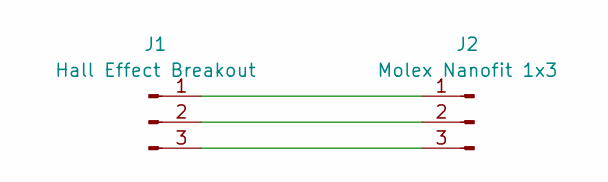
[picture p57: schematic Telemetry Upright Hall Effect Breakout Board.kicad_sch, HE Breakout]

Parts:
J1: Hall Effect Breakout; ATS668LSMTN-T
J2: Molex Nanofit 1x3; Molex_Nano-Fit_105309-xx03_1x03_P2.50mm_Vertical

Connections:
unnamed: J1.1, J2.1
unnamed: J1.2, J2.2
unnamed: J1.3, J2.3

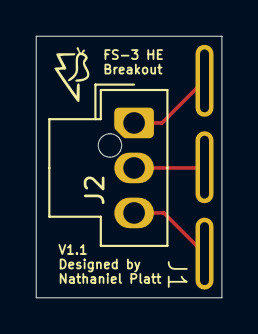
[picture p58: board Telemetry Upright Hall Effect Breakout Board.kicad_pcb from above]

Board: 2 copper layers, 10.3 x 14.5 mm, 3 parts (0 on the bottom side), 3 nets.

Other parts of the board:
G2: FS Logo; FORMULA SLUG
