formulaslug/fs-3-schematics/(commit log)

2024-10-14 group components into circuits
    [ETC.kicad_pcb]
2024-10-14 place large components
    [ETC.kicad_pcb]
2024-10-14 add connections
    [ETC.kicad_pcb]
2024-10-14 add nucleo board to pcb, need to connect
    [ETC.kicad_pcb]
2024-10-15 first routing attempt
    [ETC.kicad_pcb]
2024-10-15 final v1 design
    [ETC.kicad_pcb]
2024-10-15 increase copper-pad distance
    [ETC.kicad_pcb]
2024-10-16 simplify some traces
    [ETC.kicad_pcb]
2024-10-17 minor rerouting of Vss
    [ETC.kicad_pcb]
2024-10-17 add Vss plane, reduce depth of board
    [ETC.kicad_pcb]
2024-10-17 minor adjustments
    [ETC.kicad_pcb]
2024-10-21 update to match new schematic
    [ETC.kicad_pcb]
2024-10-21 increasing spacing around U2
    [ETC.kicad_pcb]
2024-10-21 update revision number
    [ETC.kicad_pcb]
2024-10-24 remove some redundant vias
    [ETC.kicad_pcb]
2024-10-24 shallow out connection angles
    [ETC.kicad_pcb]
2024-10-25 Discharge update
    [Discharge.kicad_pcb]
2024-10-25 discharge updates
    [Discharge.kicad_sch]
2024-10-28 Packaged BMS
    [BMS.kicad_pcb]
2024-10-28 Added formula slug logo to footprint library
2024-10-28 Revert "Added formula slug logo to footprint library"
    This reverts commit fc9fc558537e7acea55cd6e840f56f4eb1ef9a87.
2024-10-28 Silkscreen update
    [BMS.kicad_pcb]
2024-10-28 precharge pcb (still wip)
    edited schematics to have connectors, connected pcb together
    [Precharge.kicad_pcb, Precharge.kicad_sch]
2024-10-30 minor trace changes
    [ETC.kicad_pcb]
2024-10-30 Silkscreen Final Touches
    [BMS.kicad_pcb]
2024-10-30 update silkscreen
    [ETC.kicad_pcb]
2024-10-30 finished board
    [Precharge.kicad_pcb]
2024-10-30 added kicad files, added program folder and voltage divider programs
    [BSPD.kicad_pcb, BSPD.kicad_sch]
2024-10-31 compression
    packaged more tightly
    [Precharge.kicad_pcb]
2024-11-01 finished V1 of bspd
    [BSPD.kicad_pcb, BSPD.kicad_sch, bspd_logic.kicad_sch, shutdown_control.kicad_sch, status_lights.kicad_sch, untitled.kicad_sch, voltage_dividers.kicad_sch]
2024-11-01 Updated 3d models of connectors
    [BMS.kicad_pcb, BMS.step]
2024-11-04 deleted copy missing some stuff
    [Telemetry Main Board.kicad_pcb]
2024-11-06 Update Telemetry Main Board.kicad_sch
    [Telemetry Main Board.kicad_sch]
2024-11-06 changes to connections
    changed connector pin for airs+ from 1x4 to 1x2, increased width of airs+ traces, moved connectors around
    [Precharge.kicad_pcb, Precharge.kicad_sch]
2024-11-07 Started work on dash schematic
    [Dash.kicad_pcb, Dash.kicad_sch]
2024-11-07 Added SD to SPI board and generated temp PCB
    [Telemetry Main Board.kicad_pcb, Telemetry Main Board.kicad_sch]
2024-11-07 Peripheral Board updated
    [F3 peripheral boards.kicad_pcb, F3 peripheral boards.kicad_sch]
2024-11-07 deleted duplicate
    [Telemetry Main Board.kicad_pcb]
2024-11-07 Updated Library with 23 pin ampseal
2024-11-07 Dash schematic initial revision
    [Dash.kicad_sch]
2024-11-07 acc board initial commit
    [Accumulator_Board.kicad_pcb, Accumulator_Board.kicad_sch]
2024-11-08 save pcb progress
    save pcb progress
    [ETC_backup.kicad_pcb]
2024-11-10 put SD card on molex, split 23 pin connector into 2 ATM connectors (8 pin and 12 pin)
    [Telemetry Main Board.kicad_sch]
2024-11-11 Added changes after 11/10 meeting
    [Telemetry Main Board.kicad_sch]
2024-11-11 Added changes from during and after 11-10-24 work meeting
    [Telemetry Main Board.kicad_sch]
2024-11-11 Updated main PCB board
    Updated PCB board to 1.8. Made it more compact
    [Revision 1.kicad_pcb, Revision 1.kicad_sch, Telemetry Main Board.kicad_pcb, Telemetry Main Board.kicad_sch, power_distribution.kicad_sch]
2024-11-11 dash PCB work
    [Dash.kicad_pcb, Dash.kicad_sch]
2024-11-11 Dash PCB revision 1
    [Dash.kicad_pcb, Dash.kicad_sch]
2024-11-11 fixed footprints for Dash
    [Dash.kicad_sch]
2024-11-11 fixed ground plane of Dash PCB
    [Dash.kicad_pcb]
2024-11-11 Updated resistor values for CAN over SPI reset circuit
    [Telemetry Main Board.kicad_pcb, Telemetry Main Board.kicad_sch]
2024-11-11 Adapter V1
    Made adapter board, modified lt mainboard
    [LT_Adapter_V1.kicad_sch, LT_MainBoard_V1.kicad_sch]
2024-11-11 PCB slightly changed after 11/11 CDR
    [Telemetry Main Board.kicad_pcb]
2024-11-11 Added ATM13-12PA-BM03 to footprint library
2024-11-11 linear regulator
    [Discharge.kicad_sch]
2024-11-12 not gate
    [Discharge.kicad_sch, Precharge.kicad_sch]
2024-11-12 Fix footprint of flash chip
    [Dash.kicad_pcb, Dash.kicad_sch]
2024-11-12 PD board first commit
    i should have done this earlier this is v1.1
    [Power DIstrobution Board.kicad_pcb, Power DIstrobution Board.kicad_sch, brake_pressure_sensor_power.kicad_sch, current_sensor_shutdown.kicad_sch, current_sensors.kicad_sch, micro.kicad_sch, pd_board_power.kicad_sch, untitled.kicad_sch]
2024-11-12 Added 9V linear regulator for nucleo power
    [Dash.kicad_pcb, Dash.kicad_sch]
2024-11-12 Updated input capacitor value for 9V linear regulator on dash pcb
    [Dash.kicad_pcb, Dash.kicad_sch]
2024-11-12 version 1.1
    [Power DIstrobution Board.kicad_pcb, Power DIstrobution Board.kicad_sch, current_sensors.kicad_sch, micro.kicad_sch]
2024-11-12 Added can transceiver footprint with rule keepout area
2024-11-13 Created output files/zip for Dash
    [Dash.kicad_pcb]
2024-11-13 Created project and added nanofit
    [Telemetry Upright Hall Effect Breakout Board.kicad_pcb, Telemetry Upright Hall Effect Breakout Board.kicad_sch]
2024-11-13 Added ATM13-8PA-BM03 to footprint library
2024-11-13 Added name and stuff
    [Telemetry Upright Hall Effect Breakout Board.kicad_pcb, Telemetry Upright Hall Effect Breakout Board.kicad_sch]
2024-11-13 zipped gerbers
    [Telemetry Upright Hall Effect Breakout Board.kicad_pcb]
2024-11-13 saving midway through pcb work
    [Telemetry Main Board.kicad_pcb, Telemetry Main Board.kicad_sch]
2024-11-13 output update
    [Dash.kicad_pcb]
2024-11-13 please god help me
    [Telemetry Main Board.kicad_pcb, Telemetry Main Board.kicad_sch]
2024-11-13 Updated ribbon cable footprint and added pcb text to Dash board
    [Dash.kicad_pcb, Dash.kicad_sch]
2024-11-13 Byrons schematic altered
    [Accumulator_Board.kicad_sch, isoSPI.kicad_sch]
2024-11-13 Shutdown, precharge, +revisions added
    [Accumulator_Board.kicad_sch]
2024-11-13 added telemetry board PCB rev. 2
    [Telemetry Main Board.kicad_pcb]
2024-11-13 Update Telemetry Main Board.kicad_pcb
    [Telemetry Main Board.kicad_pcb]
2024-11-14 updated telemetry board
    [Telemetry Main Board.kicad_pcb]
2024-11-14 Current Footprints used for the discharge circuit.
2024-11-14 v1.3
    changed footprint of linear regulators
    [Power DIstrobution Board.kicad_pcb, brake_pressure_sensor_power.kicad_sch, pd_board_power.kicad_sch]
2024-11-14 Added led driver
2024-11-15 charger schematic made, footprints for 2 pin connectors added
    [charger_shutdownboard.kicad_pcb, charger_shutdownboard.kicad_sch]
2024-11-16 charger shutdown circuit board done!
    [charger_shutdownboard.kicad_pcb, charger_shutdownboard.kicad_sch]
2024-11-16 added spacing rules between HV and LV
    [charger_shutdownboard.kicad_pcb]
2024-11-16 Adaptor PCB
    Version 1
    [LT_Adapter_V1.kicad_pcb, LT_Adapter_V1.kicad_sch, adapator.kicad_pcb]
2024-11-16 Updated symbols for adaptor pcb
    [LT_Adapter_V1.kicad_pcb, LT_Adapter_V1.kicad_sch]
2024-11-16 testing pcb
    [testing.kicad_pcb, testing.kicad_sch]
2024-11-16 Updating name
    [LT_MainBoard_V1.kicad_pcb, LT_MainBoard_V1.kicad_sch, testing.kicad_sch]
2024-11-17 cleaned up labeling of part designations and values
    [Telemetry Main Board.kicad_pcb]
2024-11-18 small changes to shutdown schematic
    [Accumulator_Board.kicad_sch]
2024-11-19 Updated labels for capacitors and resistors
    Updated values and added F.Silkscreen text indicating the values of capacitors and resistors
    [Telemetry Main Board.kicad_pcb, Telemetry Main Board.kicad_sch]
2024-11-19 Update Live Telemetry Board (11/19)
    [LT_MainBoard_V1.kicad_pcb, LT_MainBoard_V1.kicad_sch]
2024-11-19 Added ground plate
    [LT_MainBoard_V1.kicad_pcb]
2024-11-19 Updated schematic (11/19)
    [LT_MainBoard_V1.kicad_sch]
2024-11-20 updated RC values on Dash schematic
    [Dash.kicad_sch]
2024-11-20 added gerbers
    [Telemetry Main Board.kicad_pcb]
2024-11-20 Updated dash output files
    [Dash.kicad_pcb]
2024-11-20 Gerber file for LT_MainBaord_V1
2024-11-20 revised gerbers
    [Telemetry Main Board.kicad_pcb]
2024-11-20 updated Shutdown
    [Accumulator_Board.kicad_sch]
2024-11-20 12v and discharge connection
    [Discharge.kicad_sch]
2024-11-20 pushing changes for ACC team to continue working
    [Accumulator_Board.kicad_sch]
2024-11-20 Changes to make: Dash light pins on Mircro and figure out how to power NOT gate in pre-charge
    [Accumulator_Board.kicad_sch, isoSPI.kicad_sch]
2024-11-21 Update Telemetry Main Board.kicad_pro
2024-11-22 replaced l432kc with f446re and removed multiplexer and can over spi
    [Telemetry Main Board.kicad_sch]
2024-11-22 Adapter Board
    [LT_Adapter_V1.kicad_pcb]
2024-11-22 finished pcb for updated micro
    [Telemetry Main Board.kicad_pcb, Telemetry Main Board.kicad_sch]
2024-11-22 changes after cdr
    [Power DIstrobution Board.kicad_pcb, brake_pressure_sensor_power.kicad_sch, current_sensors.kicad_sch, micro.kicad_sch, pd_board_power.kicad_sch, untitled.kicad_sch]
2024-11-22 even newer changes
    [Power DIstrobution Board.kicad_pcb, Power DIstrobution Board.kicad_sch, brake_pressure_sensor_power.kicad_sch, current_sensors.kicad_sch, micro.kicad_sch, untitled.kicad_sch]
2024-11-22 fixed backwards cap
    [Power DIstrobution Board.kicad_pcb]
2024-11-22 silkscreen updates
    [Power DIstrobution Board.kicad_pcb]
2024-11-23 value for voltage divider resistors for bspd_fault changed
    [charger_shutdownboard.kicad_pcb, charger_shutdownboard.kicad_sch]
2024-11-23 updated cap values
    [Power DIstrobution Board.kicad_pcb, brake_pressure_sensor_power.kicad_sch, current_sensors.kicad_sch, micro.kicad_sch, pd_board_power.kicad_sch]
2024-11-23 update v2
    [LT_MainBoard_V1.kicad_sch]
2024-11-23 made changes per nathaniel
    [Power DIstrobution Board.kicad_pcb, current_sensors.kicad_sch, micro.kicad_sch]
2024-11-23 reset update
    [LT_MainBoard_V1.kicad_pcb, LT_MainBoard_V1.kicad_sch]
2024-11-23 rename LT boards (LT_MainBoard_TestingV1 -> Live_Telemetry_Board)
    [Live_Telemetry_Board.kicad_pcb, Live_Telemetry_Board.kicad_sch, Live_Telemetry_Reciever_Board.kicad_pcb, Live_Telemetry_Reciever_Board.kicad_sch]
2024-11-23 spelling: reciever -> receiver
    [Live_Telemetry_Receiver_Board.kicad_pcb, Live_Telemetry_Receiver_Board.kicad_sch]
2024-11-23 Add files via upload
    Updated On 11/22/2024.
    Added the 12V supply for low voltage connectors, Voltage regulator for the Optometry relay control. Additionally, there are tests points (labeled as TP) available for troubleshooting.
    [Discharge.kicad_pcb, Discharge.kicad_sch]
2024-11-23 Warning Pushes
    [Accumulator_Board.kicad_sch, isoSPI.kicad_sch]
2024-11-23 fixed telemetry main pcb
    [Telemetry Main Board.kicad_pcb, Telemetry Main Board.kicad_sch]
2024-11-23 removed CAN SPI controller from Dash PCB and connected tranceiver directly to nucleo
    [Dash.kicad_pcb, Dash.kicad_sch]
2024-11-25 Footprint Assignment
    [Accumulator_Board.kicad_pcb, Accumulator_Board.kicad_sch, isoSPI.kicad_sch]
2024-11-25 Added RELAY_G6BK-1114P-US_OMR to library
2024-11-25 Final Footprint
    [Accumulator_Board.kicad_sch]
2024-11-25 created bom
2024-11-25 dash bom
2024-11-25 changed can and trancever exclusion stuff
    [Power DIstrobution Board.kicad_pcb]
2024-11-25 fixed design rule errors
    [Power DIstrobution Board.kicad_pcb]
2025-01-08 Changed Accumulator Board
    Added Energy Meter Temp Sense + pinout.
    [Accumulator_Board.kicad_sch]
2025-01-09 ACC board pcb changes
    Final commit before moving to branch repo
    [Accumulator_Board.kicad_pcb, Accumulator_Board.kicad_sch]
2025-01-09 added capacitor and voltage monitoring to schematic
    [Telemetry Main Board.kicad_sch]
2025-01-14 added mounting holes and specified diode
    [Telemetry Main Board.kicad_pcb, Telemetry Main Board.kicad_sch, power_distribution.kicad_sch]
2025-01-14 mounting holes
    [Live_Telemetry_Board.kicad_pcb, Live_Telemetry_Receiver_Board.kicad_pcb]
2025-01-15 implemented capacitor, diode, and voltage monitoring on pcb
    [Telemetry Main Board.kicad_pcb, Telemetry Main Board.kicad_sch, power_distribution.kicad_sch]
2025-01-15 fixed capacitor traces
    [Telemetry Main Board.kicad_pcb]
2025-01-15 added mounting holes to Dash and rearranged to be more compact
    [Dash.kicad_pcb]
2025-01-15 main telemetry board done with gerber
    [Telemetry Main Board.kicad_pcb, Telemetry Main Board.kicad_sch, power_distribution.kicad_sch]
2025-01-16 Finished BSPD
    [BSPD.kicad_pcb, BSPD.kicad_sch, BSPD_timer.kicad_sch, bspd_logic.kicad_sch, status_lights.kicad_sch, voltage_dividers.kicad_sch]
2025-01-16 added holes
    HOLE
    [Power DIstrobution Board.kicad_pcb]
2025-01-16 mounting holes and edge cut
    [Discharge.kicad_pcb]
2025-01-16 gerbers renames
2025-01-22 room design
    [Room Design.kicad_pcb, Room Design.kicad_sch]
2025-02-05 BOM tool addition
2025-02-05 Add files via upload
    All Footprints used for discharge.
2025-02-12 started design and implemented live telemetry and some of the dash
    [TelemMainV2.kicad_pcb, TelemMainV2.kicad_sch, dash.kicad_sch, power_distribution.kicad_sch, radio.kicad_sch, untitled.kicad_sch]
2025-02-13 updated dash integration
    [TelemMainV2.kicad_sch, dash.kicad_sch]
2025-02-17 grounded steering sensor
    [TelemMainV2.kicad_sch]
2025-02-17 switched radio to spi and implemented INT and PD pins for dash
    [TelemMainV2.kicad_sch, radio.kicad_sch]
2025-02-17 updated radio footprint
    [radio.kicad_sch]
2025-02-18 added new components and began creating traces
    [TelemMainV2.kicad_pcb]
2025-02-18 dash traces
    [TelemMainV2.kicad_pcb, TelemMainV2.kicad_sch]
2025-02-18 updated dash traces
    [TelemMainV2.kicad_pcb, TelemMainV2.kicad_sch]
2025-02-19 Library: Changed F446RE to avoid pin collisions
2025-02-19 almost done with dash traces
    [TelemMainV2.kicad_pcb, TelemMainV2.kicad_sch, dash.kicad_sch]
2025-02-19 Lib: Telemetry Board connector updates
    Fixed the coutyard for the 8 pin connector to accurately reflect the connector. Also changed the background for the F446RE from fab to silkscreen so people get the orientation of the micro correct on the board.
2025-02-19 almost there please god
    [TelemMainV2.kicad_pcb]
2025-02-19 i can see the light
    [TelemMainV2.kicad_pcb, TelemMainV2.kicad_sch]
2025-02-19 i had to delete half of this board and start it over again i am going to go missing soon
    [TelemMainV2.kicad_pcb, TelemMainV2.kicad_sch]
2025-02-19 init Live_Telemetry_Receiver_Board_V2
    [Live_Telemetry_Receiver_Board_V2.kicad_pcb, Live_Telemetry_Receiver_Board_V2.kicad_sch]
2025-02-19 update LT Receiver V2 Schem (PCB not done)
    [Live_Telemetry_Receiver_Board_V2.kicad_sch]
2025-02-19 save (backup old pcb)
    [Live_Telemetry_Receiver_Board_V2.kicad_sch, Live_Telemetry_Receiver_Board_V2_old.kicad_pcb]
2025-02-19 add adafruit IMU to symbol/footprint libraries
2025-02-19 pushing changes from 2/18
    [TelemMainV2.kicad_pcb]
2025-02-19 add 10DoF IMU to Telem Main board v2
    [TelemMainV2.kicad_pcb, TelemMainV2.kicad_sch]
2025-02-19 i woke up at 6 am and finished the first part and most of it will probably get deleted by later today. for good luck: Our Father, who art in heaven, hallowed be thy Name, thy kingdom come, thy will b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
    [TelemMainV2.kicad_pcb, TelemMainV2.kicad_sch]
2025-02-19 finish LT receiver PCB
    [Live_Telemetry_Receiver_Board_V2.kicad_pcb, Live_Telemetry_Receiver_Board_V2_old.kicad_pcb]
2025-02-19 update pcb dimensions
    [Live_Telemetry_Receiver_Board_V2.kicad_pcb]
2025-02-19 update IMU footprint to have f.courtyard boundaries
2025-02-20 there is an insect hidden underneath my skin and i'm going to find it (pcb finished)
    [TelemMainV2.kicad_pcb]
2025-02-20 (pcb finished) Lorem ipsum dolor sit amet, consectetur adipiscing elit. Ut a arcu at ligula tristique viverra. Ut sodales, odio ut mattis laoreet, mauris tortor congue purus, nec ultricies nulla tort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
    [TelemMainV2.kicad_pcb]
2025-02-20 Fixed IMU footprint rule area around grounded pads
2025-02-20 stopped a micro pin from being blown up at a solid 9V
    [TelemMainV2.kicad_sch, radio.kicad_sch]
2025-02-20 Updated Schematic and pcb for peripheral boards
    [F3 peripheral boards.kicad_pcb]
2025-02-20 added status diodes, fixed silkscreen, etc
    [TelemMainV2.kicad_pcb, TelemMainV2.kicad_sch, power_distribution.kicad_sch]
2025-02-20 Board touchups and LED changes
    [TelemMainV2.kicad_pcb, TelemMainV2.kicad_sch, power_distribution.kicad_sch]
2025-02-20 Edge cuts and mounting holes updated
    [F3 peripheral boards.kicad_pcb]
2025-02-20 Updated Silkscreen
    [F3 peripheral boards.kicad_pcb]
2025-02-20 some silkscreen updates, will be completed today
    [TelemMainV2.kicad_pcb]
2025-02-21 finished silkscreen
    [TelemMainV2.kicad_pcb]
2025-02-21 Finished board more!
    [TelemMainV2.kicad_pcb]
2025-02-21 generate lt receiver v2 gerbers
    [Live_Telemetry_Receiver_Board_V2.kicad_pcb]
2025-02-21 Schematic For V2
    [F3 peripheral boards-PositiveSpork.kicad_pcb, F3 peripheral boards-PositiveSpork.kicad_sch, F3 peripheral boards.kicad_pcb, F3 peripheral boards.kicad_sch]
2025-02-21 Updated names
    [F3 peripheral boards.kicad_pcb]
2025-02-21 PCB I HOPE
    [F3 peripheral boards.kicad_pcb]
2025-02-21 Pushed schematic
    [F3 peripheral boards.kicad_sch]
2025-02-21 pcb done
    [F3 peripheral boards.kicad_pcb]
2025-02-21 Board generated in a weird place but Gerbered!
2025-02-21 moved mounting holes, changed some traces,
    [TelemMainV2.kicad_pcb]
2025-02-22 update lt receiver v2 bom
2025-02-22 create telemetry peripheral bom
2025-02-23 Updated Board and Gerbers
    [F3 peripheral boards.kicad_pcb, F3 peripheral boards.kicad_sch]
2025-02-24 Stashed changes
    [Accumulator_Board.kicad_pcb, Accumulator_Board.kicad_sch]
2025-02-24 Schematic Finalized
    [Accumulator_Board.kicad_pcb, Accumulator_Board.kicad_sch]
2025-02-24 Boards and gerbers
2025-02-24 PCB Drc Needed
    [Accumulator_Board.kicad_pcb, Accumulator_Board.kicad_sch]
2025-02-24 V2 Final
    [Accumulator_Board.kicad_pcb]
2025-02-25 added more dimensions
    [F3 peripheral boards.kicad_pcb]
2025-03-06 Fault logic fixes
    [Accumulator_Board.kicad_pcb, Accumulator_Board.kicad_sch]
2025-03-11 work started
    [F3311A7H121030E200.step, TelemMainV3.kicad_pcb, TelemMainV3.kicad_sch, dash.kicad_sch, power_distribution.kicad_sch, radio.kicad_sch, untitled.kicad_sch]
2025-03-11 Fixed dk1a1b relays and CAN transceiver
    [Accumulator_Board.kicad_pcb, Accumulator_Board.kicad_sch]
2025-03-11 Minor cleanup and moved precharge relay
    [Accumulator_Board.kicad_pcb]
2025-03-11 Telemetry Main Rev 3 finished
    [TelemMainV3-B_Cu.gbr, TelemMainV3-B_Mask.gbr, TelemMainV3-B_Paste.gbr, TelemMainV3-B_Silkscreen.gbr, TelemMainV3-Edge_Cuts.gbr, TelemMainV3-F_Cu.gbr, TelemMainV3-F_Mask.gbr, TelemMainV3-F_Paste.gbr]
2025-03-11 fixed board dimension layer
    [TelemMainV3.kicad_pcb]
2025-03-11 updated telem gerbers
    [TelemMainV3-B_Cu.gbr, TelemMainV3-B_Mask.gbr, TelemMainV3-B_Paste.gbr, TelemMainV3-B_Silkscreen.gbr, TelemMainV3-Edge_Cuts.gbr, TelemMainV3-F_Cu.gbr, TelemMainV3-F_Mask.gbr, TelemMainV3-F_Paste.gbr]
2025-03-24 all BSPD changes
    [BSPD-B_Cu.gbr, BSPD-B_Mask.gbr, BSPD-B_Paste.gbr, BSPD-B_Silkscreen.gbr, BSPD-Edge_Cuts.gbr, BSPD-F_Cu.gbr, BSPD-F_Mask.gbr, BSPD-F_Paste.gbr]
2025-03-26 Added extra fusing for powering boards
    [BMS.kicad_sch]
2025-03-28 silkscreen change
    [Accumulator_Board.kicad_pcb]
2025-03-28 Precharge logic fixed
    [Accumulator_Board.kicad_sch]
2025-03-29 commit 1 of v2
    pd board v2 work first commit
    [Power DIstrobution Board.kicad_pcb, Power DIstrobution Board.kicad_sch, brake_pressure_sensor_power.kicad_sch, micro.kicad_sch, pd_board_power.kicad_sch, untitled.kicad_sch]
2025-03-29 v2 3/29
    almost done need to add mounting holes text, clean up screen printing, and get linear regs re speced
    [Power DIstrobution Board.kicad_pcb, Power DIstrobution Board.kicad_sch, brake_pressure_sensor_power.kicad_sch, current_sensors.kicad_sch, pd_board_power.kicad_sch, untitled.kicad_sch]
2025-03-29 another push idk
    idk what changed i just saved some stuff
    [Power DIstrobution Board.kicad_sch, untitled.kicad_sch]
2025-03-31 Linear Regulator Fix
    [Accumulator_Board.kicad_pcb, Accumulator_Board.kicad_sch]
2025-03-31 fixed dk1a1b footprint (added width)
2025-04-02 Revert "Added extra fusing for powering boards"
    This reverts commit 2168929610f95d4d97141b26f9bc23faee535fcb.
    [BMS.kicad_sch]
2025-04-02 Added fuses
    changed bms to avoid voltage drops
    [BMS.kicad_sch]
2025-04-03 Created Copy of Schematic to Update
    [F3 peripheral boards.kicad_pcb, F3 peripheral boards.kicad_sch]
2025-04-03 Updated to get schematic copy to work
    [F3 peripheral boards (Nucleo).kicad_pcb, F3 peripheral boards (Nucleo).kicad_sch]
2025-04-03 generate main v3 bom
2025-04-03 updated schematic and pcb new components
    [F3 peripheral boards (Nucleo).kicad_pcb, F3 peripheral boards (Nucleo).kicad_sch]
2025-04-03 Main Push
    [Accumulator_Board.kicad_pcb, Accumulator_Board.kicad_sch]
2025-04-04 Slight Change
    [Accumulator_Board.kicad_pcb]
2025-04-04 added mounting holes
    ready for review. need linear reg pns
    [Power DIstrobution Board.kicad_pcb]
2025-04-04 PCB (Partially Complete)
    [F3 peripheral boards (Nucleo).kicad_pcb, F3 peripheral boards (Nucleo).kicad_sch]
2025-04-04 More traces
    [F3 peripheral boards (Nucleo).kicad_pcb]
2025-04-04 finished traces
    [F3 peripheral boards (Nucleo).kicad_pcb]
2025-04-04 completed pcb
    [F3 peripheral boards (Nucleo).kicad_pcb]
2025-04-04 fixed voltage drop issue with parallel fuses
    [BMS.kicad_sch]
2025-04-04 Updated fuse values to contain part numbers
    [BMS.kicad_sch]
2025-04-05 made attiny project folder
    [FS3 Peripheral V3 ATTINY.kicad_pcb, FS3 Peripheral V3 ATTINY.kicad_sch]
2025-04-06 small fixes
    [Accumulator_Board.kicad_pcb]
2025-04-06 flipped cons
    [Power DIstrobution Board.kicad_pcb, pd_board_power.kicad_sch]
2025-04-06 updated exclusion zones
    [Power DIstrobution Board.kicad_pcb]
2025-04-07 Update F3 peripheral boards (Nucleo).kicad_sch
    [F3 peripheral boards (Nucleo).kicad_sch]
2025-04-07 added tire temp, removed headers
    [F3 peripheral boards.kicad_pcb, F3 peripheral boards.kicad_sch, FS3 Peripheral V3 ATTINY.kicad_pcb, FS3 Peripheral V3 ATTINY.kicad_sch]
2025-04-07 updated schematic
    [F3 peripheral boards.kicad_sch]
2025-04-08 resized pcb
    [F3 peripheral boards.kicad_pcb]
2025-04-08 updated PCB
    [BMS.kicad_pcb, BMS.kicad_sch]
2025-04-08 Added temp sensor symbol
    [F3 peripheral boards.kicad_sch]
2025-04-10 Updated Nucleo Board
    [F3 peripheral boards (Nucleo).kicad_pcb, F3 peripheral boards (Nucleo).kicad_sch]
2025-04-10 Added values to come components and repaired silk screen errors
    [BMS.kicad_pcb, BMS.kicad_sch]
2025-04-11 added testing pin headers and made pin change on attiny v3
    [F3 peripheral boards.kicad_pcb, F3 peripheral boards.kicad_sch]
2025-04-13 cleaned up and made silkscreen
    [Power DIstrobution Board.kicad_pcb]
2025-04-13 added peripheral v3 nucleo sl
    [F3 peripheral boards (Nucleo) sl.kicad_pcb]
2025-04-14 fixed attiny v3
    [F3 peripheral boards.kicad_pcb, F3 peripheral boards.kicad_sch]
2025-04-14 fixed attiny pin headers
    [F3 peripheral boards.kicad_pcb]
2025-04-14 REV 6 (?)
    [Discharge.kicad_pcb, Discharge.kicad_sch]
2025-04-14 updated attiny board
    [F3 peripheral boards.kicad_pcb]
2025-04-14 Added temp sensor, cleaned up tracks and vias
    [Accumulator_Board.kicad_pcb, Accumulator_Board.kicad_sch]
2025-04-14 created gerbers
    [Accumulator_Board-B_Cu.gbr, Accumulator_Board-B_Mask.gbr, Accumulator_Board-B_Paste.gbr, Accumulator_Board-B_Silkscreen.gbr, Accumulator_Board-Edge_Cuts.gbr, Accumulator_Board-F_Cu.gbr, Accumulator_Board-F_Mask.gbr, Accumulator_Board-F_Paste.gbr]
2025-04-14 updated silk screen
    updated bms silk screen
    [BMS.kicad_pcb]
2025-04-14 timer fix
    [Discharge.kicad_pcb, Discharge.kicad_sch]
2025-04-15 Corrected value for R1, repaired 555 nets, and aesthetic changes
    Changed R1 footprint to 0805, added vias to GND, rerouted 555 5V and discharge pins. Corrected PCB silkscreen rev # to 3
    [Discharge.kicad_pcb, Discharge.kicad_sch]
2025-04-16 telemP v3.1: added silkscreens, re-added separate updi testpoints
    [F3 peripheral boards.kicad_pcb]
2025-04-24 idk some random changes
    [Power DIstrobution Board.kicad_pcb, le poisson steve.kicad_pcb, le poisson steve.kicad_sch]
2025-05-01 moved pos fuse
    [BMS.kicad_pcb]
2025-05-01 idk what i changed
    [Power DIstrobution Board.kicad_pcb, current_sensors.kicad_sch]
2025-05-02 Added J1772 negotiation to schematic
    [charger_shutdownboard.kicad_sch]
2025-05-02 Revised PCB for J1772 negotiation
    [charger_shutdownboard.kicad_pcb, charger_shutdownboard.kicad_sch]
2025-05-02 Minor silkscreen cleanup
    [BMS.kicad_pcb]
2025-05-02 Reduced board height slightly
    [charger_shutdownboard.kicad_pcb]
2025-05-02 Silkscreen cleanup
    [charger_shutdownboard.kicad_pcb]
2025-05-03 TSSI and DASH Light logic adjustment
    [Accumulator_Board.kicad_pcb, Accumulator_Board.kicad_sch]
2025-05-03 Slight readjusment
    [Accumulator_Board.kicad_sch]
2025-05-03 Deleted Extra GND
    [Accumulator_Board.kicad_sch]
2025-05-03 5V trace fix
    [Accumulator_Board.kicad_sch]
2025-05-03 Final BMS PCB Layout
    Shifted top right balance block to better fit the new fuses. Shifted bottom layer to remove islands from ground plane. Removed all 90 degree tracks.
    [BMS.kicad_pcb]
2025-05-03 v4.3, organized tracks, fixed silkscreens
    [Accumulator_Board.kicad_pcb]
2025-05-03 Removed redundant BMS
    [BMS.kicad_pcb, BMS.kicad_sch, BalanceSenseBlock.kicad_sch]
2025-05-03 Cleaned up version number
    [Accumulator_Board.kicad_pcb]
2025-05-03 Removed redundant acc board folders
2025-05-03 Fixed version numbers
    [Accumulator_Board.kicad_sch]
2025-05-03 Updated acc board version number
    [Accumulator_Board.kicad_pcb]
2025-05-03 added clarification text
    [charger_shutdownboard.kicad_sch]
2025-05-04 changes to move to pc
    [Power DIstrobution Board.kicad_pcb, Power DIstrobution Board.kicad_sch]
2025-05-04 footprint fixes
    [Discharge-B_Cu.gbr, Discharge-B_Mask.gbr, Discharge-B_Paste.gbr, Discharge-B_Silkscreen.gbr, Discharge-Edge_Cuts.gbr, Discharge-F_Cu.gbr, Discharge-F_Mask.gbr, Discharge-F_Paste.gbr]
2025-05-04 Updated silkscreen issues
    [charger_shutdownboard.kicad_pcb]
2025-05-04 fixed charger board silkscreen misalignment
    [charger_shutdownboard.kicad_pcb]
2025-05-04 trace separation
    [Discharge-B_Cu.gbr, Discharge-B_Mask.gbr, Discharge-B_Paste.gbr, Discharge-B_Silkscreen.gbr, Discharge-Edge_Cuts.gbr, Discharge-F_Cu.gbr, Discharge-F_Mask.gbr, Discharge-F_Paste.gbr]
2025-05-04 another footprint fix
    [Discharge.kicad_pcb]
2025-05-05 Accumulator board, IMD Fault Latching fix.
    [Accumulator_Board.kicad_sch]
2025-05-05 Corrected RC Values for IMD Delay before turn on
    Also corrected Diode and inverter "Value" fields to part numbers. See here for simulation results:
    https://fsae.slack.com/archives/C07NHLH0MM1/p1746485749681379?thread_ts=1746476164.111659&cid=C07NHLH0MM1
    [Accumulator_Board.kicad_sch]
2025-05-06 removed empty footprints, fixed CAN paths, organized traces
    [Accumulator_Board-B_Cu.gbr, Accumulator_Board-B_Mask.gbr, Accumulator_Board-B_Paste.gbr, Accumulator_Board-B_Silkscreen.gbr, Accumulator_Board-Edge_Cuts.gbr, Accumulator_Board-F_Cu.gbr, Accumulator_Board-F_Mask.gbr, Accumulator_Board-F_Paste.gbr]
2025-05-06 cleared 3V3 regulator
    [F3 peripheral boards.kicad_pcb, F3 peripheral boards.kicad_sch, PD.kicad_sch]
2025-05-07 more stuff and gerbers!
    [F3 peripheral boards.kicad_pcb]
2025-05-08 Tssi & acc board test points
    [Accumulator_Board.kicad_pcb, Accumulator_Board.kicad_sch]
2025-08-24 Update STS6NF20V Symbol to match KiCad style
    Matches symbols such as Q_NMOS_SSSGD_AvalanchRated
2025-09-10 Update Acc board to KiCad 9.0
    [Accumulator_Board.kicad_sch, isoSPI.kicad_sch]
2025-09-10 Separate IMD Delay and shutdown onto subsheets for Eric and Gaddiel to work on them
    [Accumulator_Board.kicad_sch, delay_and_led_drivers.kicad_sch, isoSPI.kicad_sch, shutdown.kicad_sch]
2025-09-14 Acc Onboard Shutdown cleanup
    [shutdown.kicad_sch]
